upb-lea/LEA_KiCad_Library/LEA_3D_Models/Conn_354078-E_3d.stp

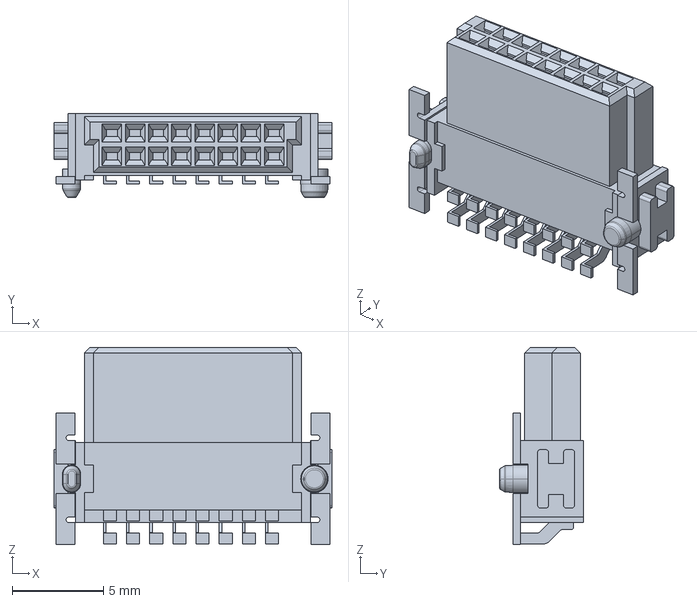
[picture p5: CAD file, 2026-10-27]
LEA_3D_Models/Conn_354078-E_3d.stp
15.2 x 4.60 x 10.8 mm
