upb-lea/LEA_KiCad_Library/LEA_3D_Models/heatsink_ub4060-10.stp

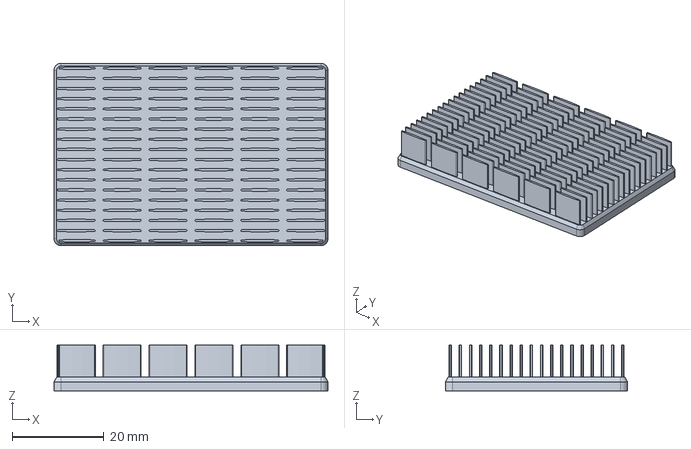
[picture p6: CAD file, 2026-10-13]
LEA_3D_Models/heatsink_ub4060-10.stp
59.7 x 39.7 x 10.0 mm
