upb-lea/LEA_KiCad_Library/LEA_3D_Models/WE_744393305100.stp

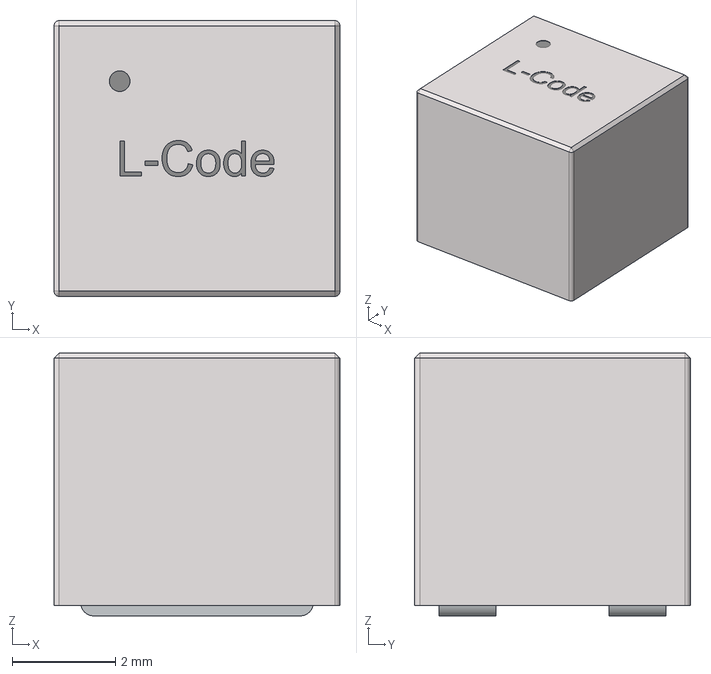
[picture p7: CAD file, 2026-09-16]
LEA_3D_Models/WE_744393305100.stp
5.55 x 5.35 x 5.10 mm
