upb-lea/LEA_KiCad_Library/LEA_3D_Models/C_Film_ECW-FJ3A205J.stp

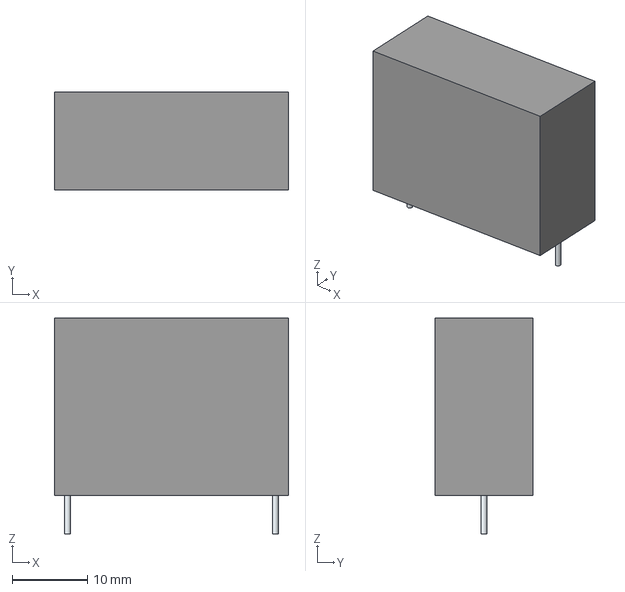
[picture p8: CAD file, 2026-09-16]
LEA_3D_Models/C_Film_ECW-FJ3A205J.stp
31.0 x 13.0 x 28.6 mm
Leads
