upb-lea/LEA_KiCad_Library/LEA_3D_Models/SOT-323F_UFM.stp

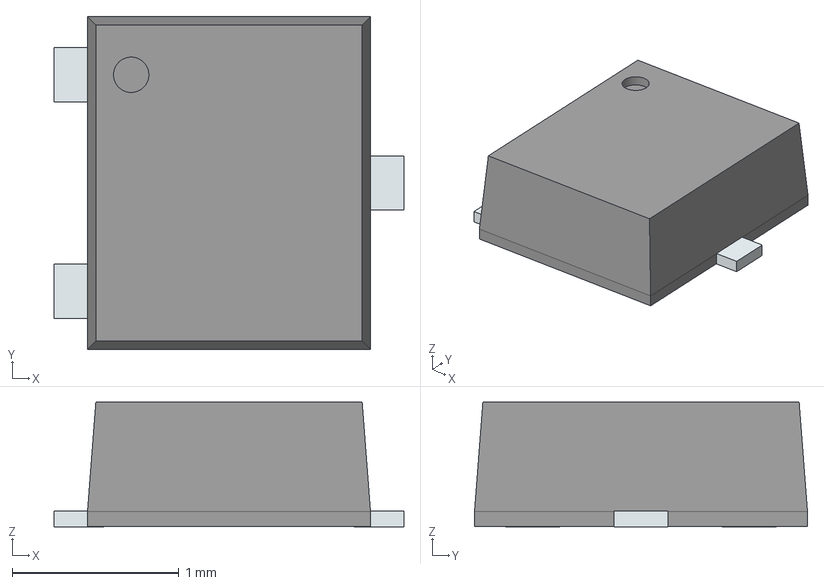
[picture p9: CAD file, 2026-09-15]
LEA_3D_Models/SOT-323F_UFM.stp
2.10 x 2.00 x 0.748 mm
PinsArrayL
PinsArrayR
