upb-lea/LEA_KiCad_Library/LEA_3D_Models/Conn_SAMTEC-LS2-105-01-X-D.step

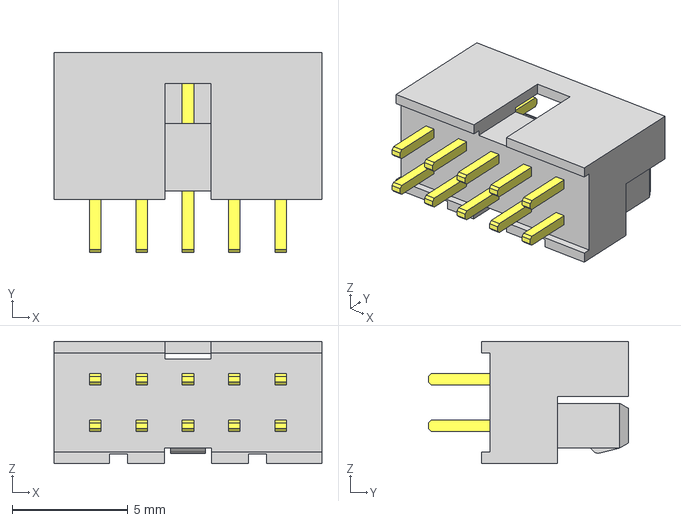
[picture p10: CAD file, 2026-09-14]
LEA_3D_Models/Conn_SAMTEC-LS2-105-01-X-D.step
11.6 x 8.64 x 5.27 mm
LS2-105-01-D_strip
T-1S13-05-01-D
