upb-lea/LEA_KiCad_Library/LEA_3D_Models/Conn_Samtec_LS2-105-01-F-D-RA2.stp

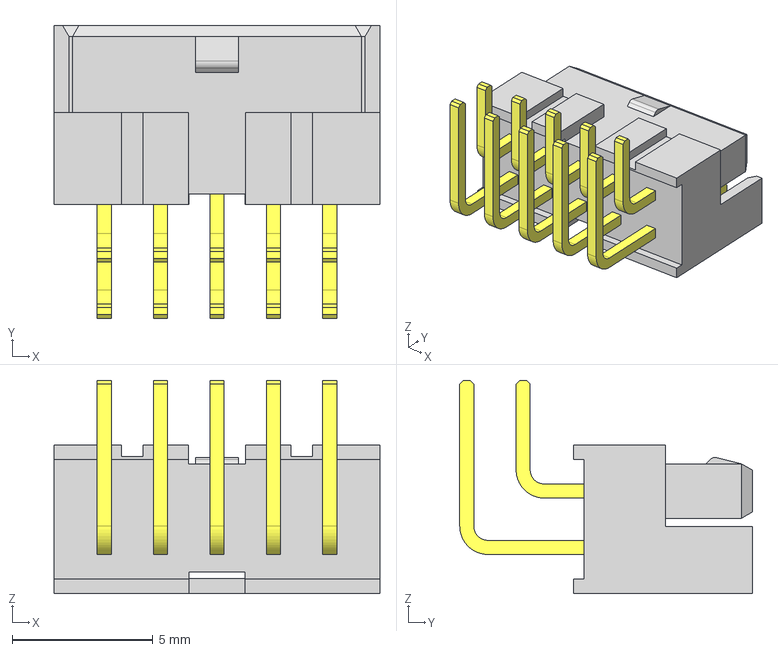
[picture p11: CAD file, 2026-09-14]
LEA_3D_Models/Conn_Samtec_LS2-105-01-F-D-RA2.stp
11.6 x 10.4 x 7.56 mm
LS2-105-01-D_strip
T-1S13-05-01-D-RA2
