upb-lea/LEA_KiCad_Library/LEA_3D_Models/Conn_WE_61301021821.stp

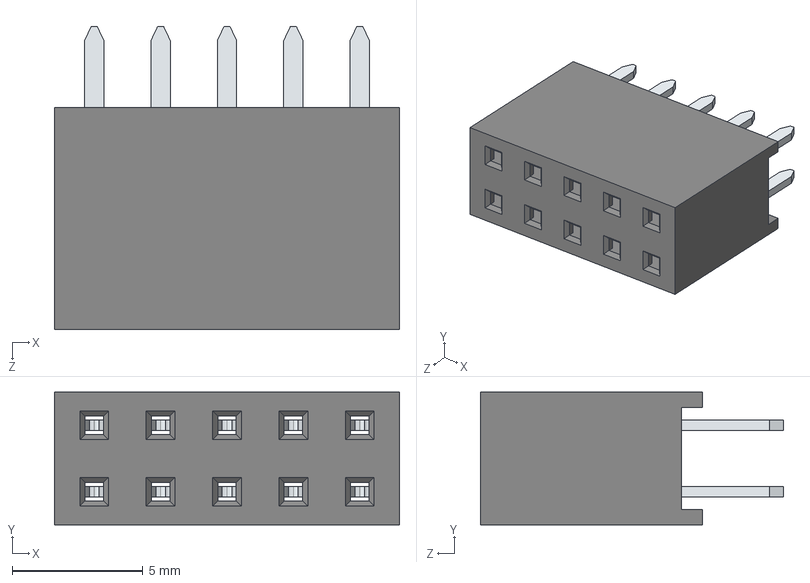
[picture p12: CAD file, 2026-09-11]
LEA_3D_Models/Conn_WE_61301021821.stp
13.2 x 5.08 x 11.6 mm
6130xx21821_PIN x 10
