upb-lea/LEA_KiCad_Library/LEA_3D_Models/HCMA1707-6R8-R.stp

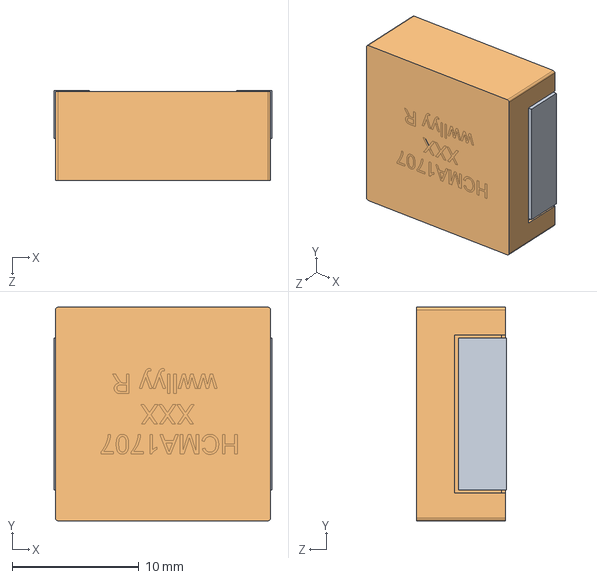
[picture p13: CAD file, 2026-09-08]
LEA_3D_Models/HCMA1707-6R8-R.stp
17.2 x 16.9 x 7.11 mm
