upb-lea/LEA_KiCad_Library/LEA_3D_Models/R_2728_reversed.stp

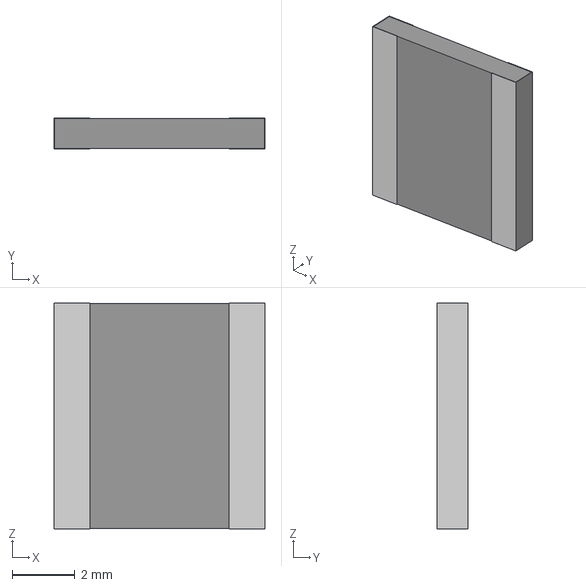
[picture p14: CAD file, 2026-09-08]
LEA_3D_Models/R_2728_reversed.stp
6.71 x 0.99 x 7.19 mm
