upb-lea/LEA_KiCad_Library/LEA_3D_Models/C_2225_5664Metric.step

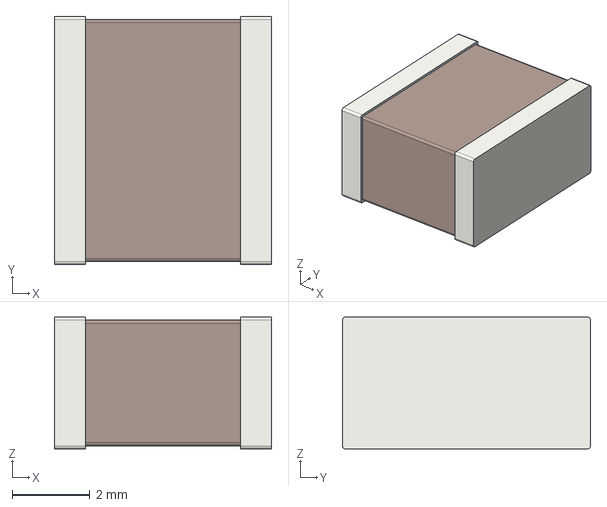
[picture p15: CAD file, 2026-09-07]
LEA_3D_Models/C_2225_5664Metric.step
5.60 x 6.40 x 3.40 mm
