upb-lea/LEA_KiCad_Library/LEA_3D_Models/TO-263-2.step

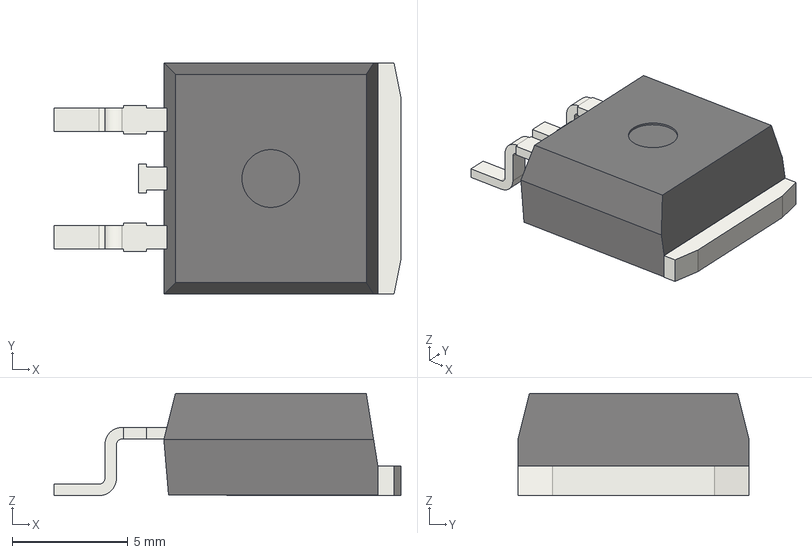
[picture p16: CAD file, 2026-09-03]
LEA_3D_Models/TO-263-2.step
15.0 x 10.0 x 4.42 mm
a3dd6ad7-9c39-11ed-93f0-dde97e994e83_part
a3dd6ad8-9c39-11ed-93f0-dde97e994e83_part
a3dd6ad9-9c39-11ed-93f0-dde97e994e83_part
