upb-lea/LEA_KiCad_Library/LEA_3D_Models/TO-263AB(D2PAK)-2L.STEP

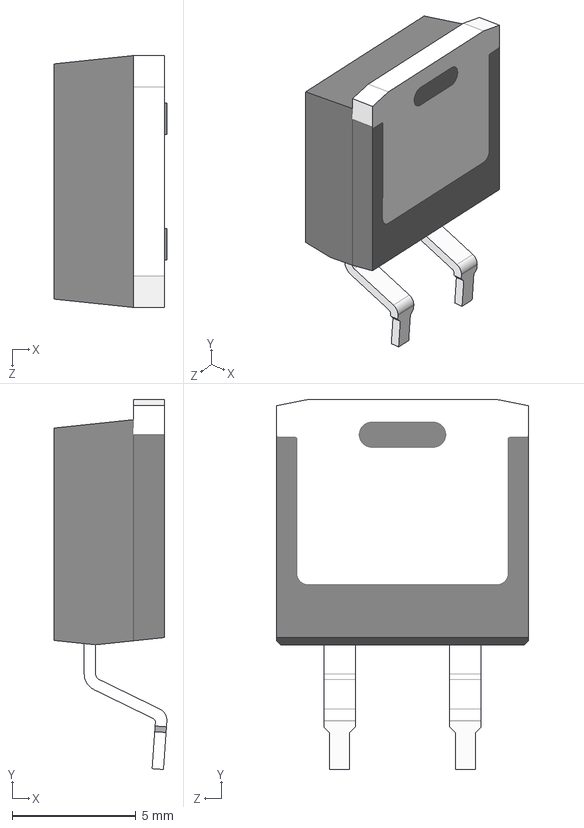
[picture p17: CAD file, 2026-08-31]
LEA_3D_Models/TO-263AB(D2PAK)-2L.STEP
4.55 x 14.9 x 10.2 mm
