upb-lea/LEA_KiCad_Library/LEA_3D_Models/2MM-HB-D08-HT-02-H-TB.stp

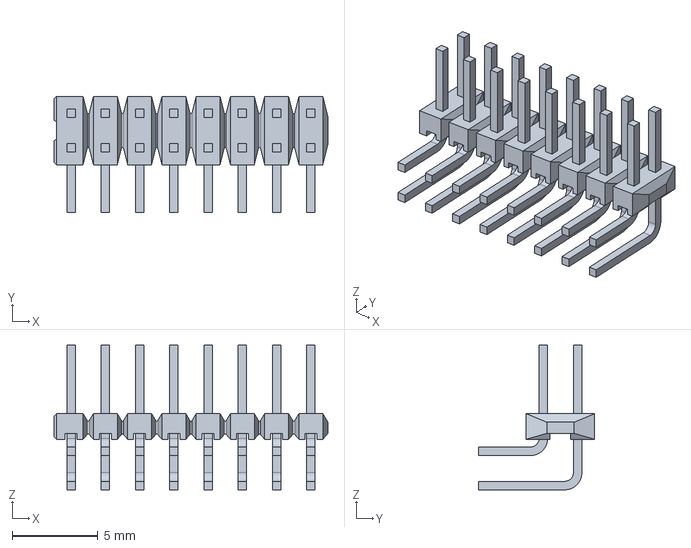
[picture p18: CAD file, 2026-08-21]
LEA_3D_Models/2MM-HB-D08-HT-02-H-TB.stp
16.0 x 6.80 x 8.45 mm
