upb-lea/LEA_KiCad_Library/LEA_3D_Models/HalfBridge.step

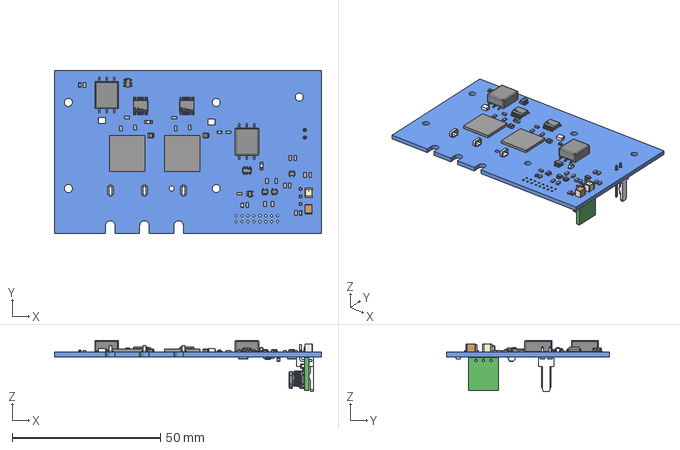
[picture p19: CAD file, 2026-08-21]
LEA_3D_Models/HalfBridge.step
90.0 x 55.0 x 17.3 mm
