upb-lea/LEA_KiCad_Library/LEA_3D_Models/ESQT-108-03-F-D-350.stp

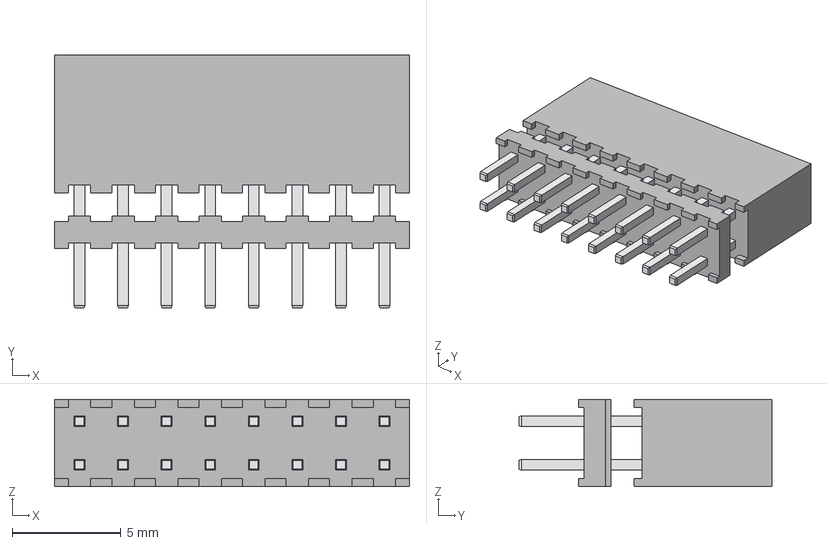
[picture p20: CAD file, 2026-08-21]
LEA_3D_Models/ESQT-108-03-F-D-350.stp
16.3 x 11.6 x 4.00 mm
ESQT-108-03-F-D-350_S
ESQT-108-03-F-D-350_P
ESQT-108-03-F-D-3502_P
ESQT-108-03-F-D-350_BS
