upb-lea/LEA_KiCad_Library/LEA_3D_Models/C_1812_4532Metric.step

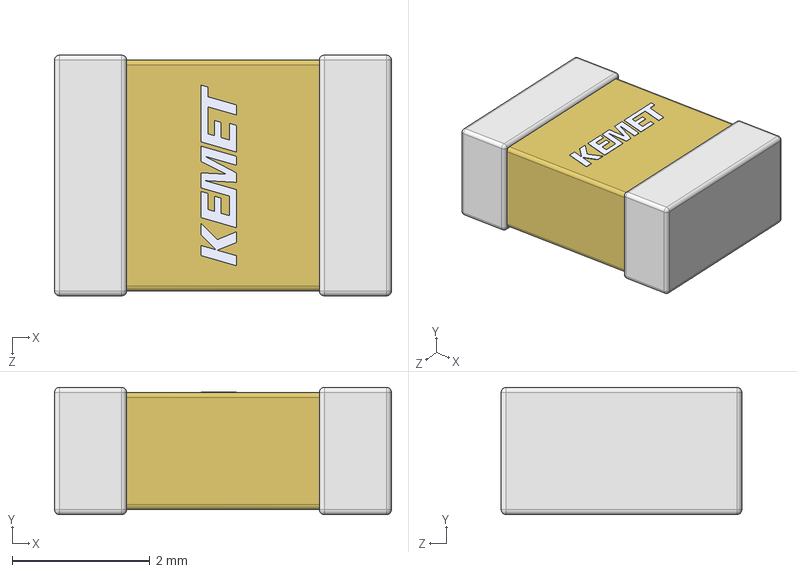
[picture p21: CAD file, 2026-08-18]
LEA_3D_Models/C_1812_4532Metric.step
4.90 x 1.85 x 3.50 mm
