upb-lea/LEA_KiCad_Library/LEA_3D_Models/IGC033S10S1XTMA1.stp

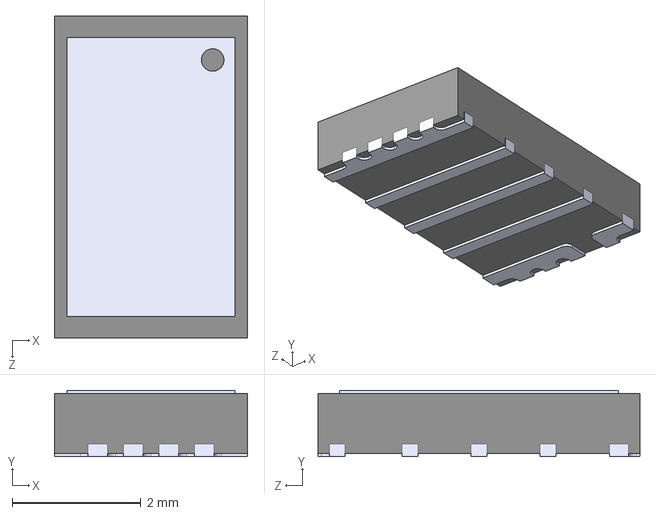
[picture p22: CAD file, 2026-08-09]
LEA_3D_Models/IGC033S10S1XTMA1.stp
3.00 x 1.03 x 5.00 mm
