upb-lea/LEA_KiCad_Library/LEA_3D_Models/D_0805_2012Metric.step

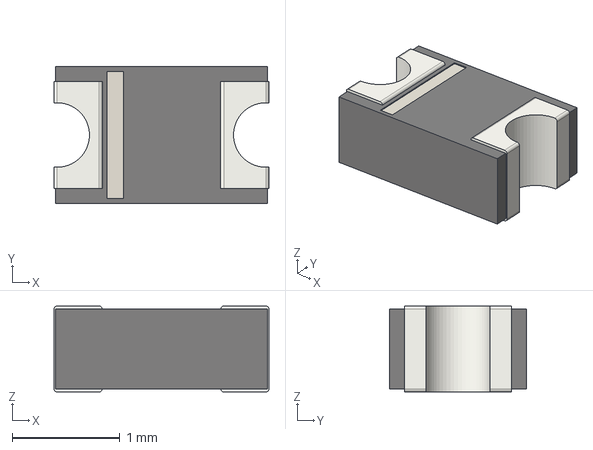
[picture p23: CAD file, 2026-01-27]
LEA_3D_Models/D_0805_2012Metric.step
2.00 x 1.27 x 0.8 mm
