upb-lea/LEA_KiCad_Library/LEA_3D_Models/Conn_Molex_10085021.stp

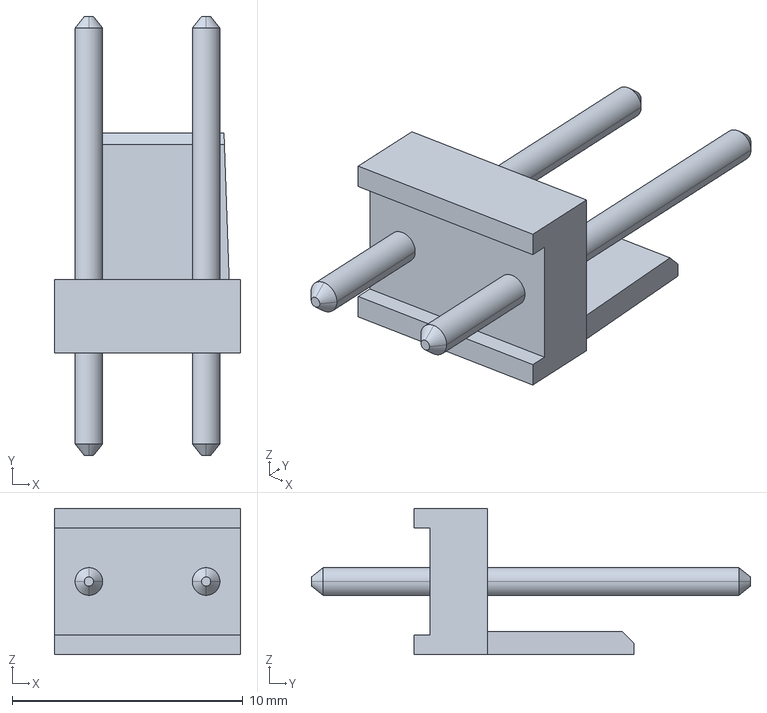
[picture p24: CAD file, 2025-09-18]
LEA_3D_Models/Conn_Molex_10085021.stp
8.08 x 19.0 x 6.35 mm
