upb-lea/LEA_KiCad_Library/LEA_3D_Models/C_1210_3225Metric.step

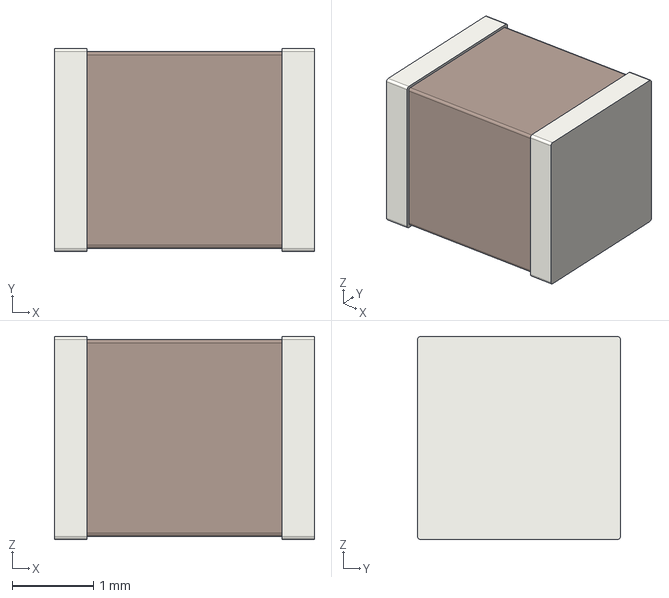
[picture p25: CAD file, 2025-09-16]
LEA_3D_Models/C_1210_3225Metric.step
3.20 x 2.50 x 2.50 mm
