upb-lea/LEA_KiCad_Library/LEA_3D_Models/RDA0015A_QFN15.stp

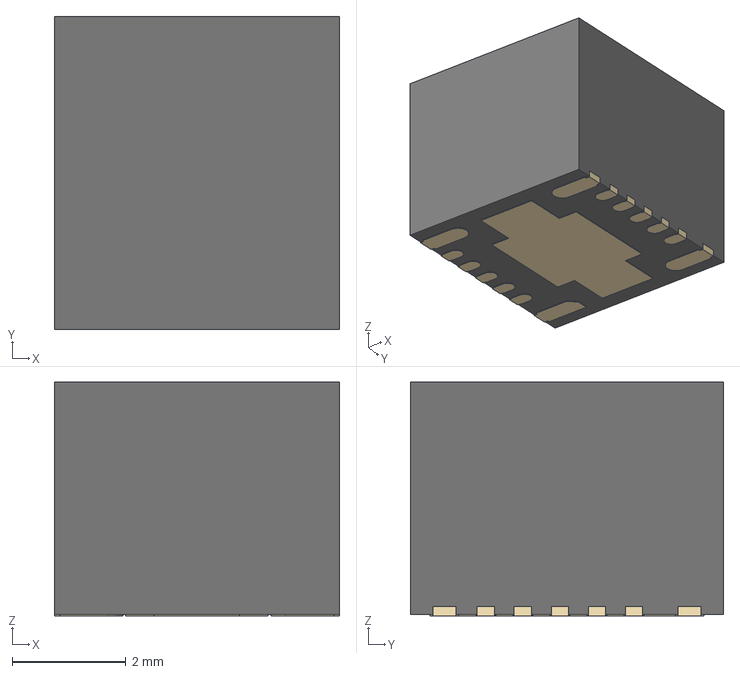
[picture p26: CAD file, 2025-09-12]
LEA_3D_Models/RDA0015A_QFN15.stp
5.00 x 5.50 x 4.10 mm
METAL
MOLD
