upb-lea/LEA_KiCad_Library/LEA_3D_Models/SRN4026-220M.stp

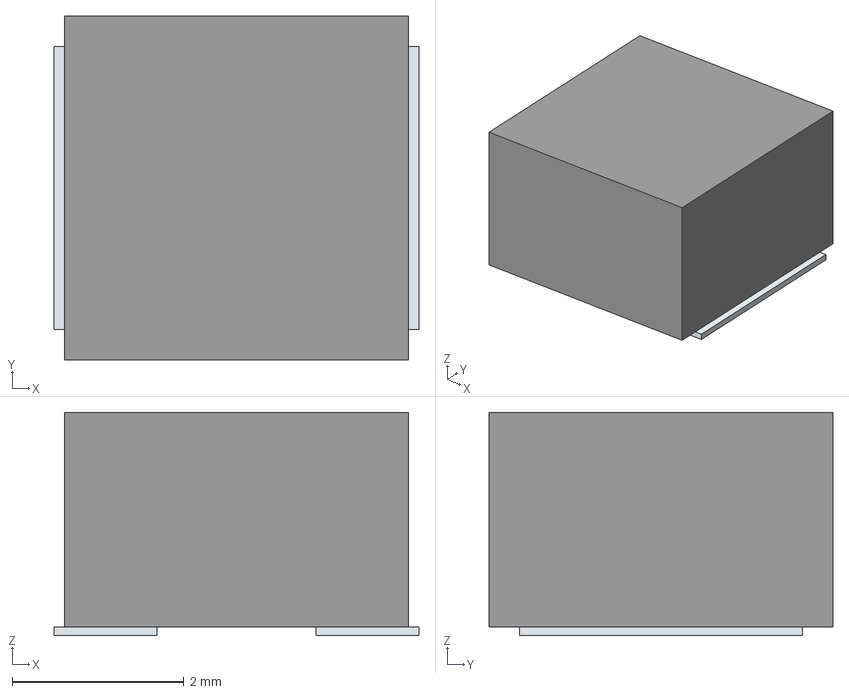
[picture p27: CAD file, 2025-06-04]
LEA_3D_Models/SRN4026-220M.stp
4.25 x 4.00 x 2.60 mm
Pins
