upb-lea/LEA_KiCad_Library/LEA_3D_Models/L_Wurth_WE-TPC-1038.step

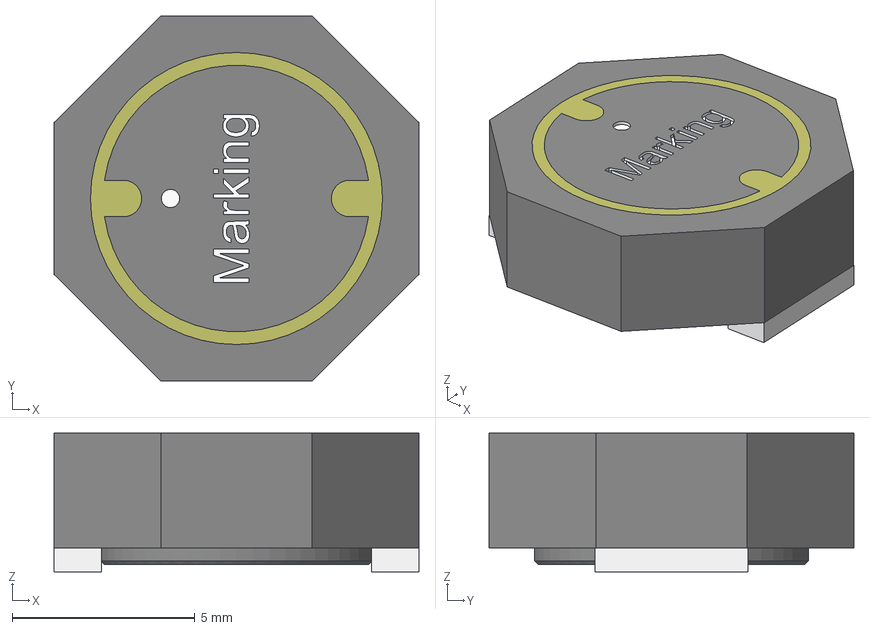
[picture p28: CAD file, 2025-05-29]
LEA_3D_Models/L_Wurth_WE-TPC-1038.step
10.0 x 10.00 x 3.80 mm
