upb-lea/LEA_KiCad_Library/LEA_3D_Models/LED_Yellow_0603.stp

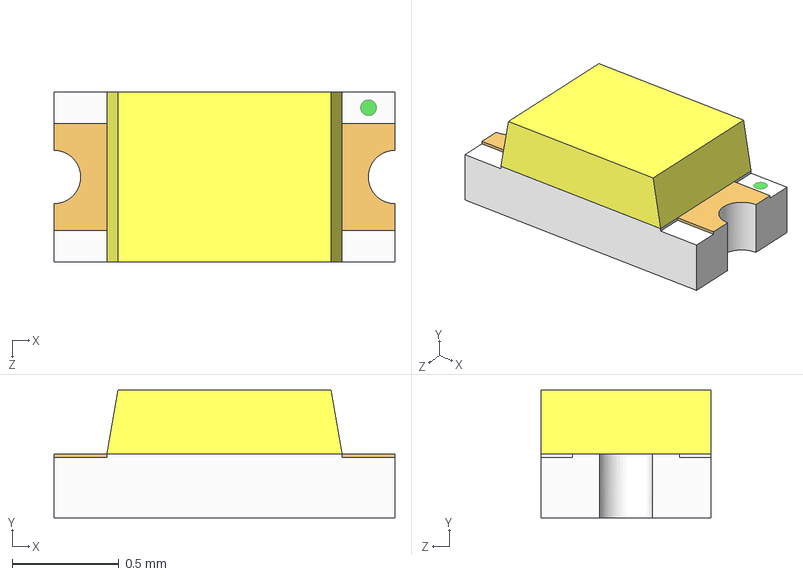
[picture p29: CAD file, 2025-02-20]
LEA_3D_Models/LED_Yellow_0603.stp
1.60 x 0.6 x 0.8 mm
