upb-lea/LEA_KiCad_Library/LEA_3D_Models/MSOP10_AnalogDevices.stp

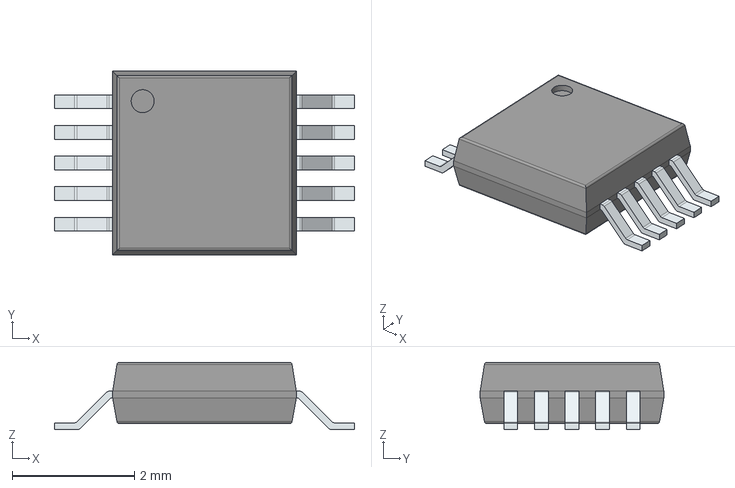
[picture p30: CAD file, 2025-02-18]
LEA_3D_Models/MSOP10_AnalogDevices.stp
4.90 x 3.00 x 1.10 mm
PinsArrayLR
