upb-lea/LEA_KiCad_Library/LEA_3D_Models/FTR-110-03-G-D-06-TR.stp

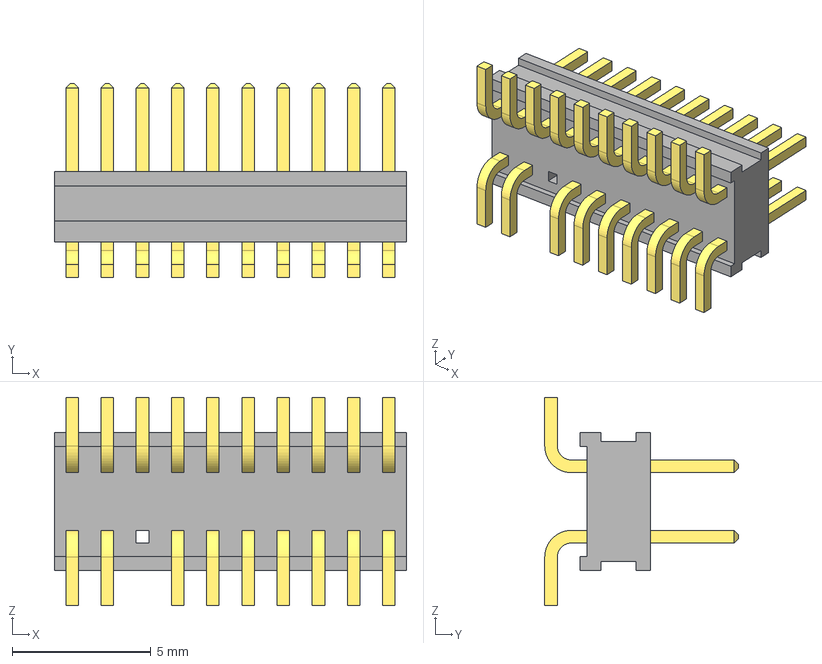
[picture p31: CAD file, 2025-02-18]
LEA_3D_Models/FTR-110-03-G-D-06-TR.stp
12.7 x 6.98 x 7.52 mm
FTR-110-03-G-D-006-TR_body
FTR-110-03-G-D-006-TR_pins
FTR-110-03-G-D-006-TR2PNS
