upb-lea/LEA_KiCad_Library/LEA_3D_Models/VSSOP-8-TI.stp

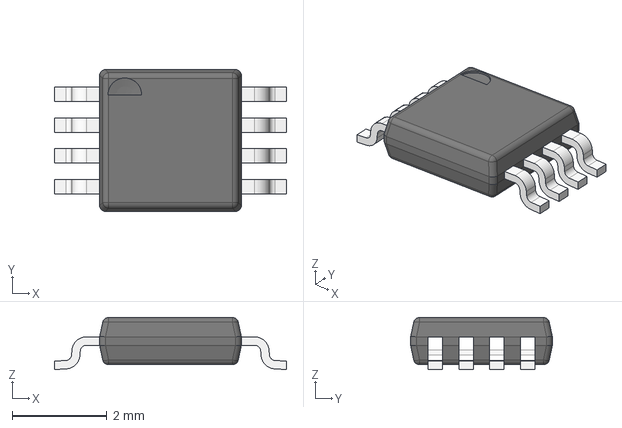
[picture p32: CAD file, 2025-01-23]
LEA_3D_Models/VSSOP-8-TI.stp
4.90 x 3.00 x 1.10 mm
BODY_MUA08A
LEAD_MUA08A x 8
