upb-lea/LEA_KiCad_Library/LEA_3D_Models/SO-14.stp

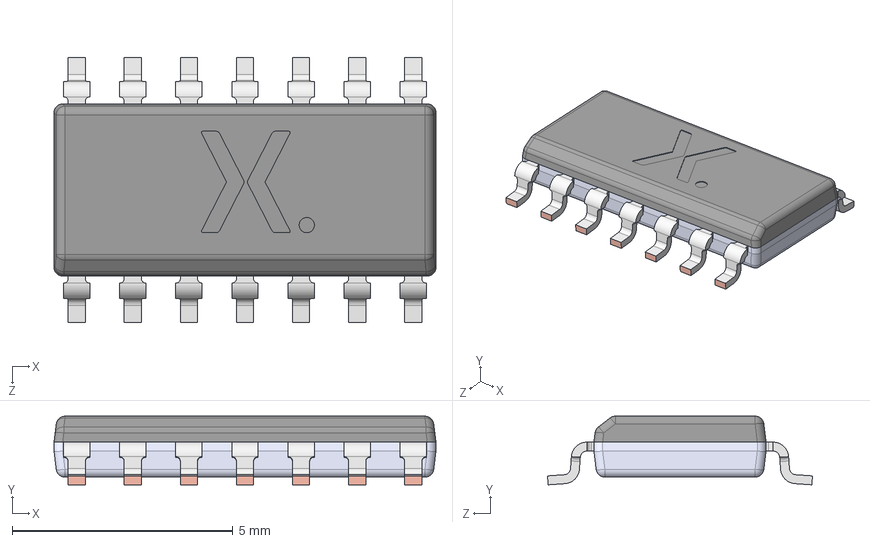
[picture p33: CAD file, 2025-01-13]
LEA_3D_Models/SO-14.stp
8.65 x 1.56 x 6.00 mm
SOT108 lower body
SOT108 upper body
SOT108-1 Lead
