upb-lea/LEA_KiCad_Library/LEA_3D_Models/SOT-23-8.stp

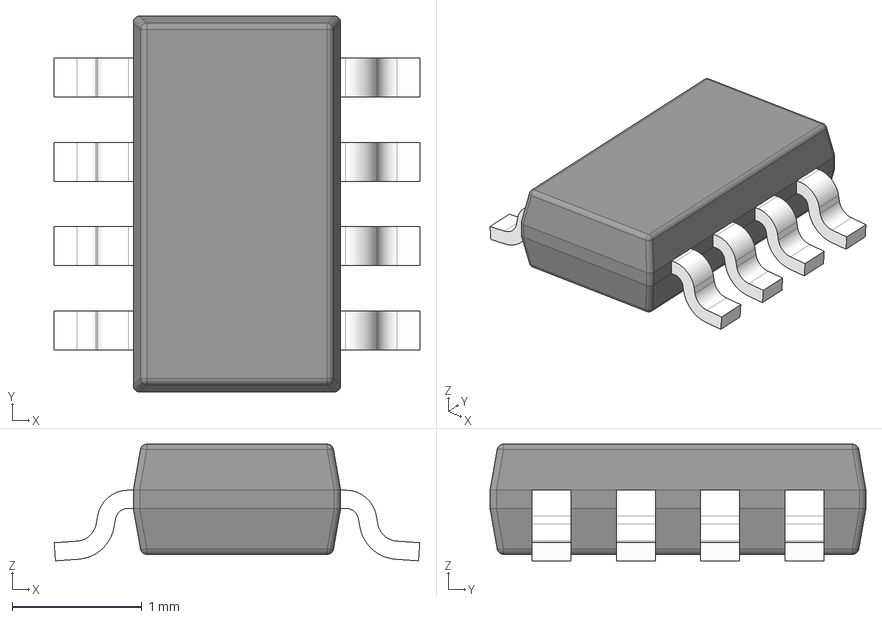
[picture p34: CAD file, 2025-01-13]
LEA_3D_Models/SOT-23-8.stp
2.82 x 2.90 x 0.9 mm
BODY-SO
LEAD-SO x 8
PIN1-ID
