upb-lea/LEA_KiCad_Library/LEA_3D_Models/B3U-3000PM-B.stp

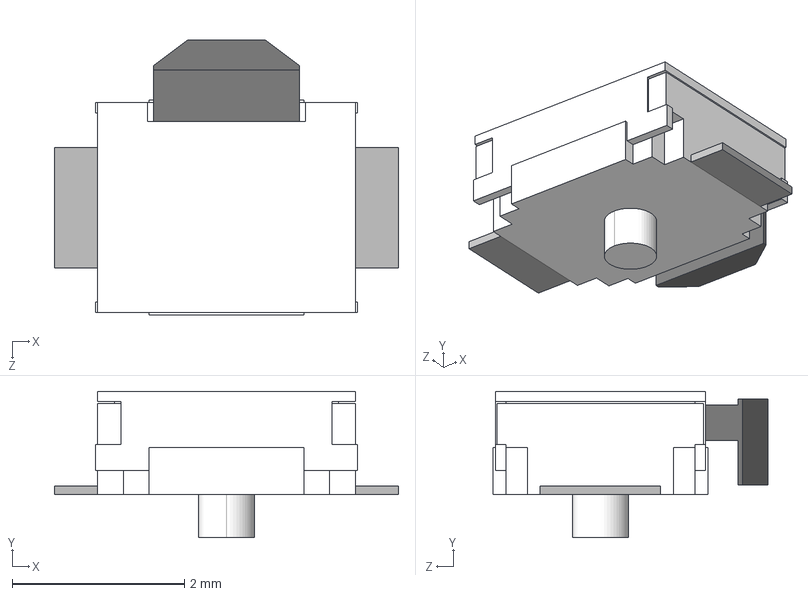
[picture p35: CAD file, 2025-01-06]
LEA_3D_Models/B3U-3000PM-B.stp
4.00 x 1.70 x 3.20 mm
