upb-lea/LEA_KiCad_Library/LEA_3D_Models/PI6C49CB04AQ3WEX.stp

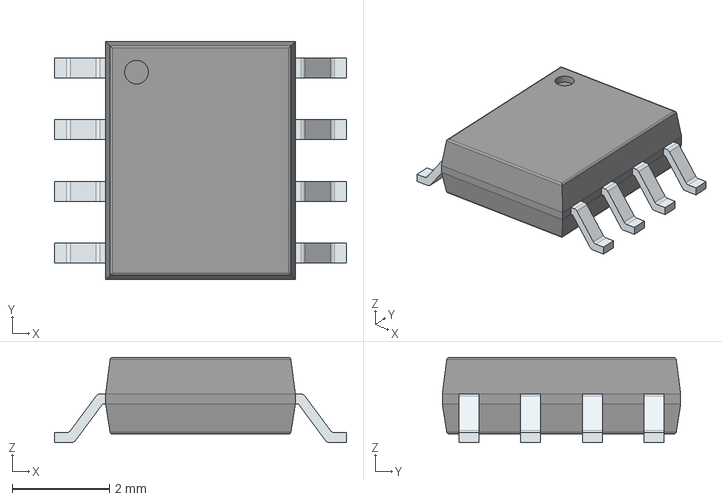
[picture p36: CAD file, 2024-12-20]
LEA_3D_Models/PI6C49CB04AQ3WEX.stp
6.00 x 4.90 x 1.75 mm
PinsArrayLR
