upb-lea/LEA_KiCad_Library/LEA_3D_Models/NTE0303MC.stp

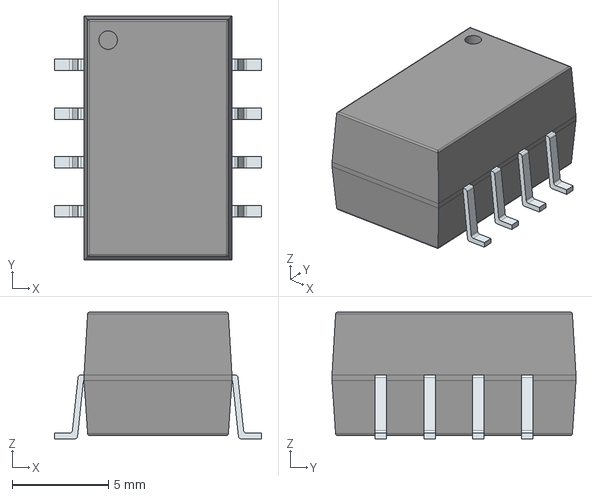
[picture p37: CAD file, 2024-10-23]
LEA_3D_Models/NTE0303MC.stp
10.8 x 12.7 x 6.60 mm
PinsArrayLR
