upb-lea/LEA_KiCad_Library/LEA_3D_Models/Conn_M4_74650074R.stp

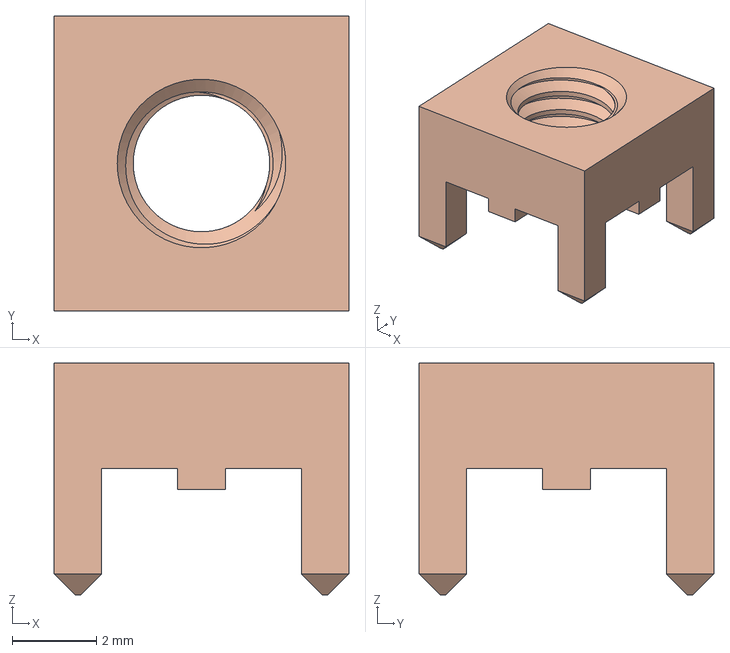
[picture p38: CAD file, 2024-07-29]
LEA_3D_Models/Conn_M4_74650074R.stp
7.00 x 7.00 x 5.50 mm
