upb-lea/LEA_KiCad_Library/LEA_3D_Models/CSI2H-2512K-1L80G.stp

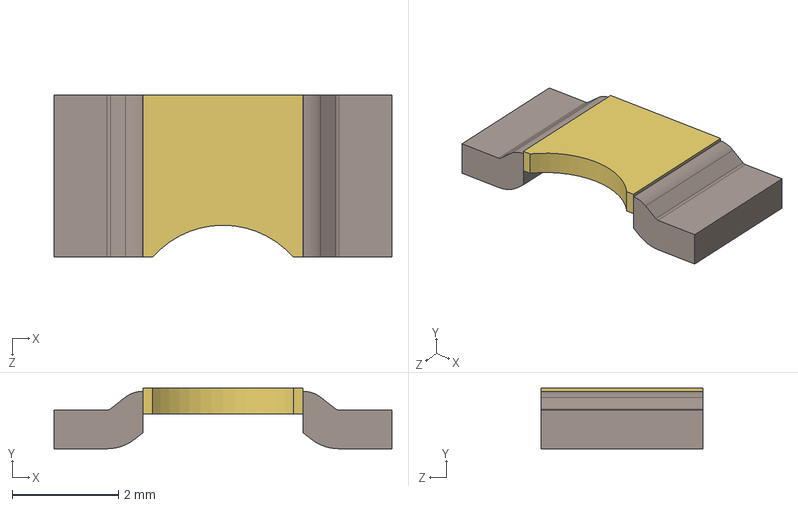
[picture p39: CAD file, 2024-07-23]
LEA_3D_Models/CSI2H-2512K-1L80G.stp
6.35 x 1.14 x 3.05 mm
MANIFOLD_SOLID_BREP_547
MANIFOLD_SOLID_BREP_1090
RESIST2512_3
