upb-lea/LEA_KiCad_Library/LEA_3D_Models/Conn_2492000000.stp

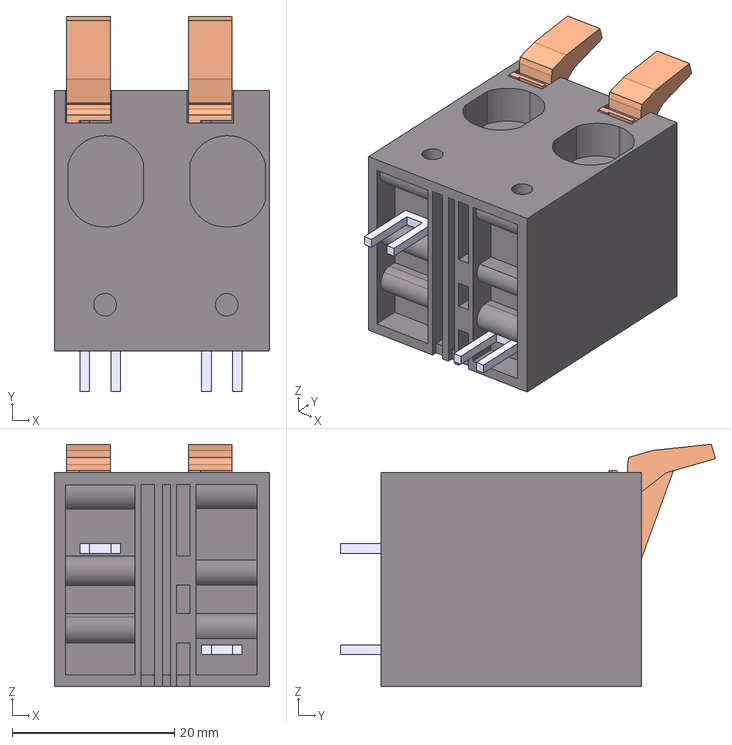
[picture p40: CAD file, 2024-07-22]
LEA_3D_Models/Conn_2492000000.stp
26.6 x 46.2 x 29.9 mm
