upb-lea/LEA_KiCad_Library/LEA_3D_Models/Conn_1548376.stp

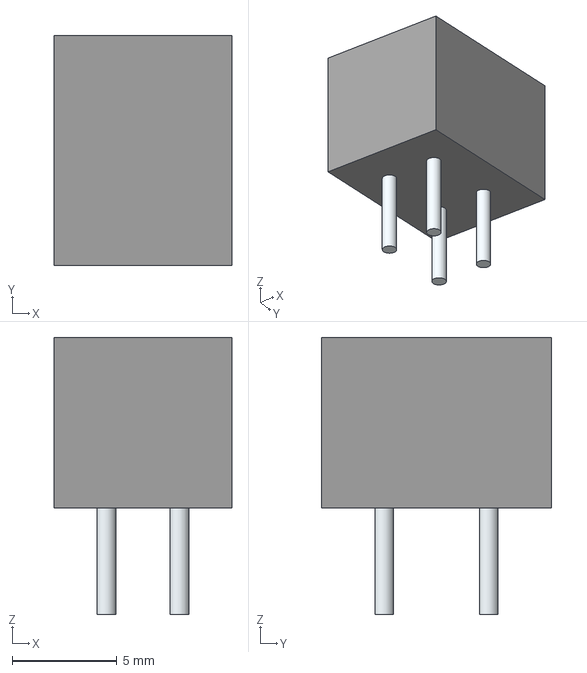
[picture p41: CAD file, 2024-07-22]
LEA_3D_Models/Conn_1548376.stp
8.50 x 11.0 x 13.2 mm
Leads
