upb-lea/LEA_KiCad_Library/LEA_3D_Models/SD101AW-HE3_A-08.stp

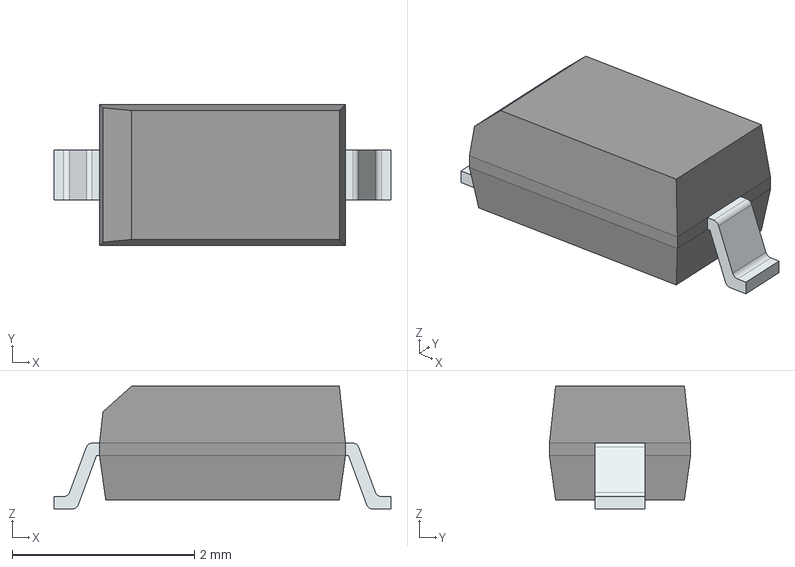
[picture p42: CAD file, 2024-07-16]
LEA_3D_Models/SD101AW-HE3_A-08.stp
3.70 x 1.55 x 1.35 mm
FilletPinL
FilletPinR
