upb-lea/LEA_KiCad_Library/LEA_3D_Models/MTS-10S.stp

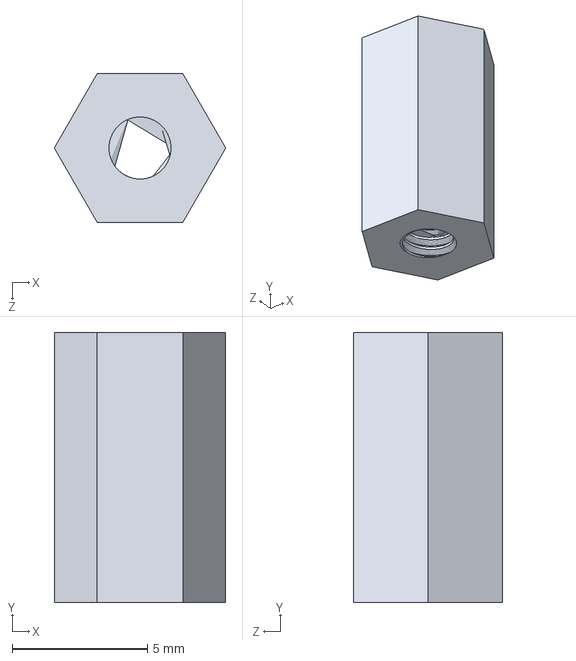
[picture p43: CAD file, 2024-07-12]
LEA_3D_Models/MTS-10S.stp
6.35 x 10.0 x 5.50 mm
