upb-lea/LEA_KiCad_Library/LEA_3D_Models/LTC7800HUDC#PBF.stp

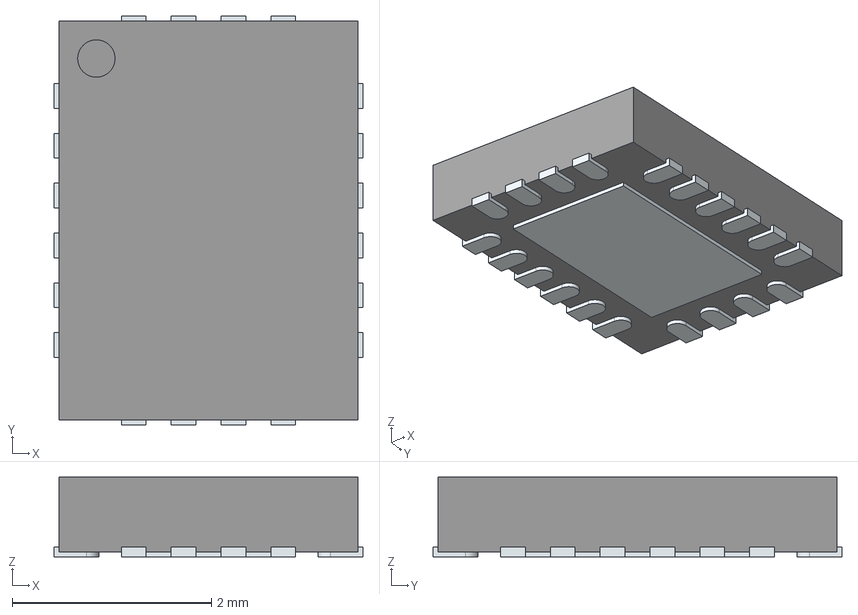
[picture p44: CAD file, 2024-07-10]
LEA_3D_Models/LTC7800HUDC#PBF.stp
3.10 x 4.10 x 0.8 mm
ThermalPin
PinsArrayLR
PinsArrayTB
