upb-lea/LEA_KiCad_Library/LEA_3D_Models/EEU-EB2W220S.stp

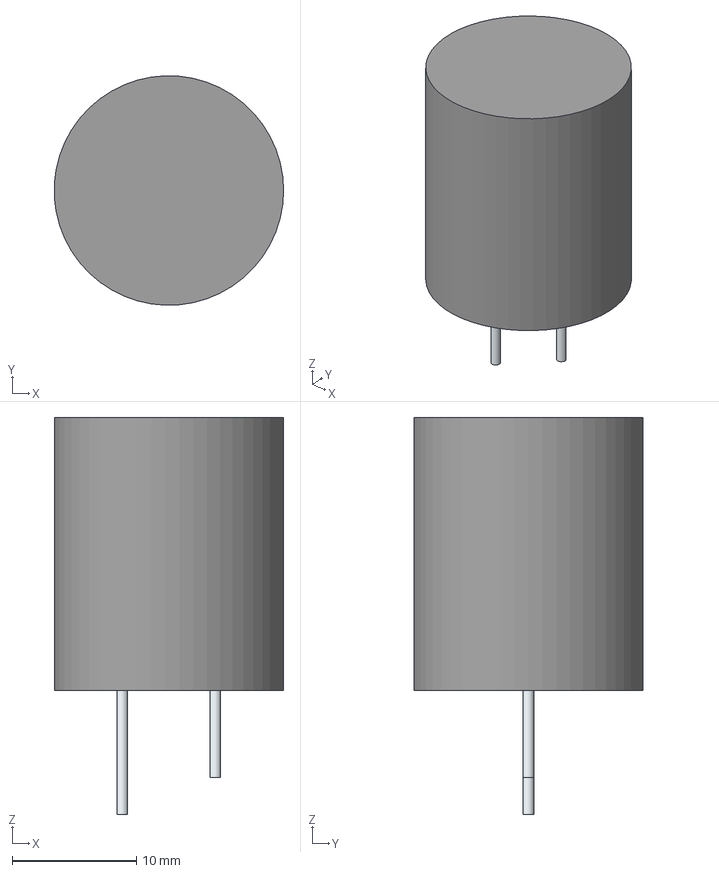
[picture p45: CAD file, 2024-05-21]
LEA_3D_Models/EEU-EB2W220S.stp
18.5 x 18.5 x 32.0 mm
SimpleBody
Pin1
Pin2
