upb-lea/LEA_KiCad_Library/LEA_3D_Models/EEU-FS2A560L.stp

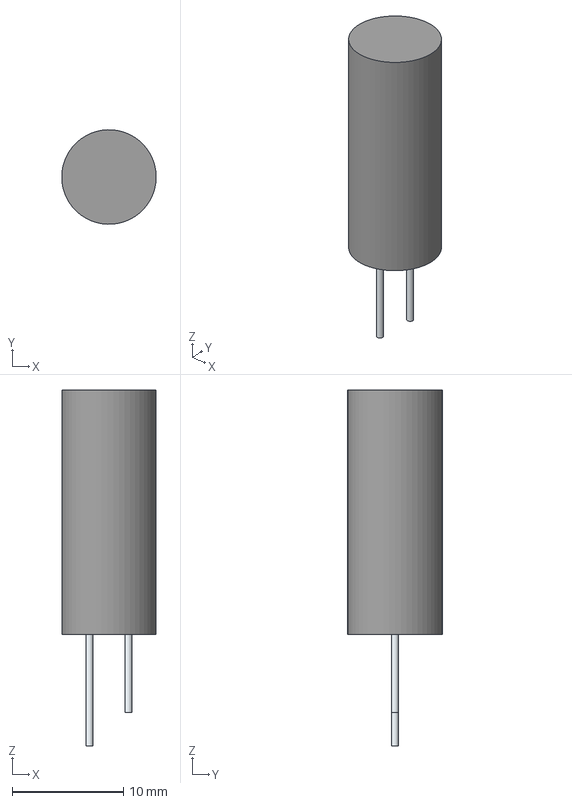
[picture p46: CAD file, 2024-05-21]
LEA_3D_Models/EEU-FS2A560L.stp
8.49 x 8.50 x 32.0 mm
SimpleBody
Pin1
Pin2
