upb-lea/LEA_KiCad_Library/LEA_3D_Models/EEU-FS1H270B.stp

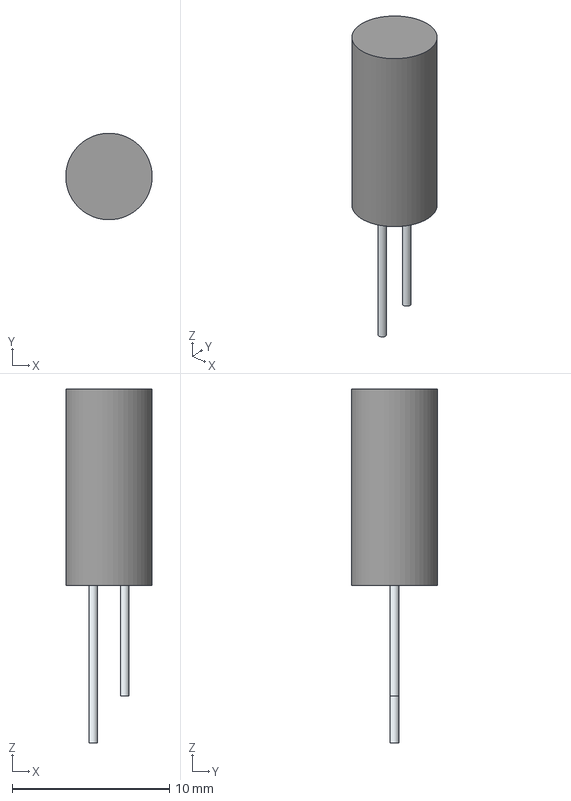
[picture p47: CAD file, 2024-05-21]
LEA_3D_Models/EEU-FS1H270B.stp
5.49 x 5.50 x 22.5 mm
SimpleBody
Pin1
Pin2
