upb-lea/LEA_KiCad_Library/LEA_3D_Models/09.03290.01.stp

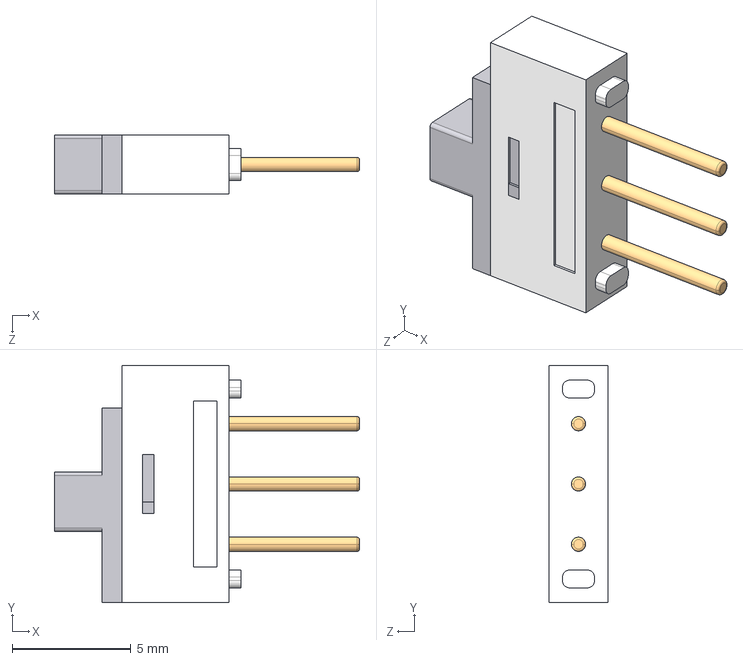
[picture p48: CAD file, 2024-05-13]
LEA_3D_Models/09.03290.01.stp
12.8 x 10.0 x 2.50 mm
