upb-lea/LEA_KiCad_Library/LEA_3D_Models/LED_Blue_0402.stp

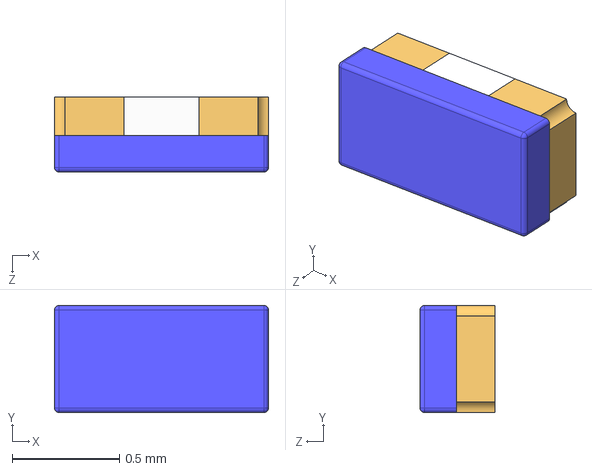
[picture p49: CAD file, 2024-03-21]
LEA_3D_Models/LED_Blue_0402.stp
1.00 x 0.5 x 0.35 mm
