upb-lea/LEA_KiCad_Library/LEA_3D_Models/LED_Yellow_0402.stp

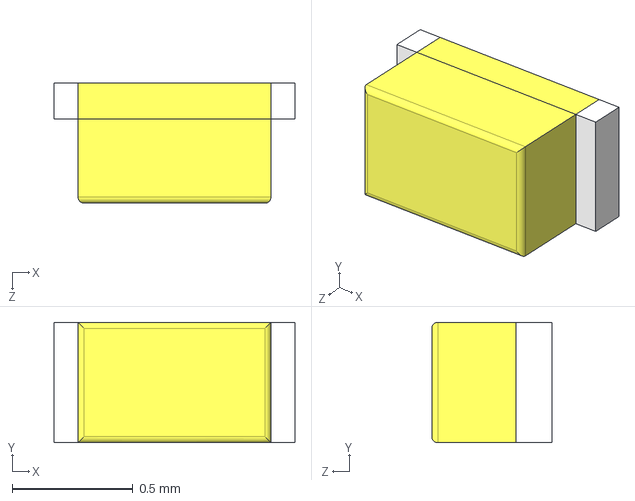
[picture p50: CAD file, 2024-03-21]
LEA_3D_Models/LED_Yellow_0402.stp
1 x 0.5 x 0.5 mm
