upb-lea/LEA_KiCad_Library/LEA_3D_Models/LED_Red_0402.stp

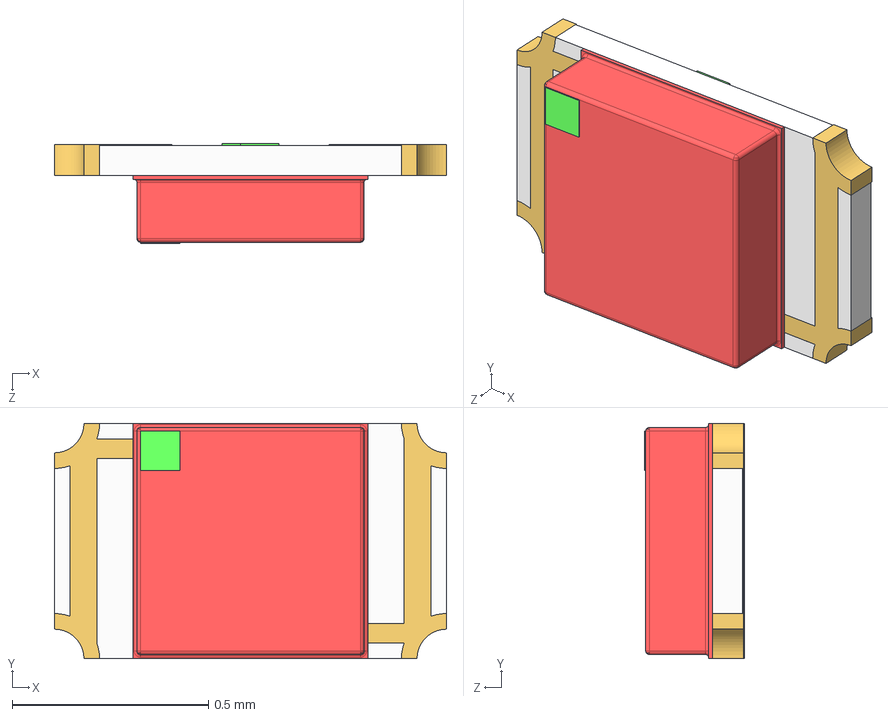
[picture p51: CAD file, 2024-03-21]
LEA_3D_Models/LED_Red_0402.stp
1.00 x 0.6 x 0.255 mm
terminals_2
terminals
lens
cathod mark
cathod mark_2
