upb-lea/LEA_KiCad_Library/LEA_3D_Models/LED_Blue_0603.stp

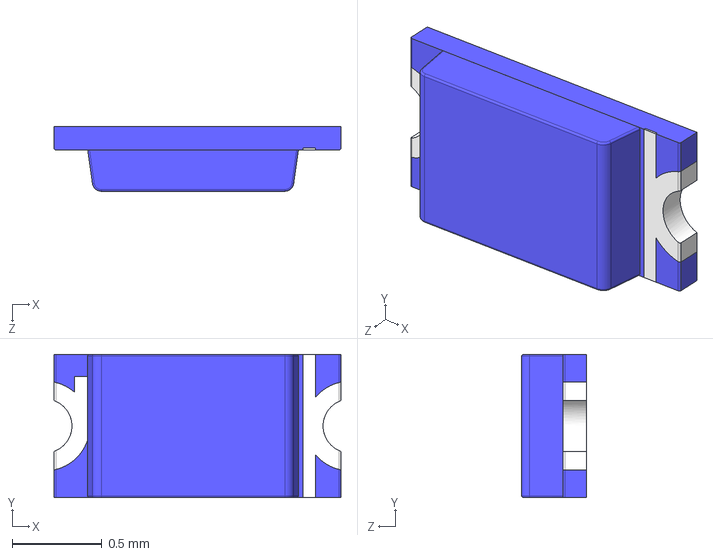
[picture p52: CAD file, 2024-03-20]
LEA_3D_Models/LED_Blue_0603.stp
1.60 x 0.8 x 0.36 mm
