upb-lea/LEA_KiCad_Library/LEA_3D_Models/LED_Red_0603.stp

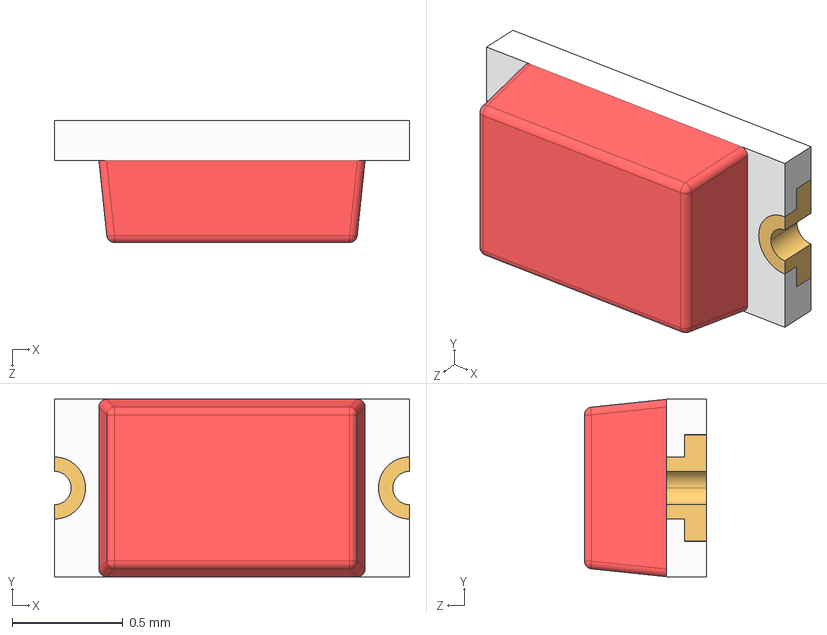
[picture p53: CAD file, 2024-03-20]
LEA_3D_Models/LED_Red_0603.stp
1.60 x 0.8 x 0.55 mm
