upb-lea/LEA_KiCad_Library/LEA_3D_Models/TSW-102-07-G-T.stp

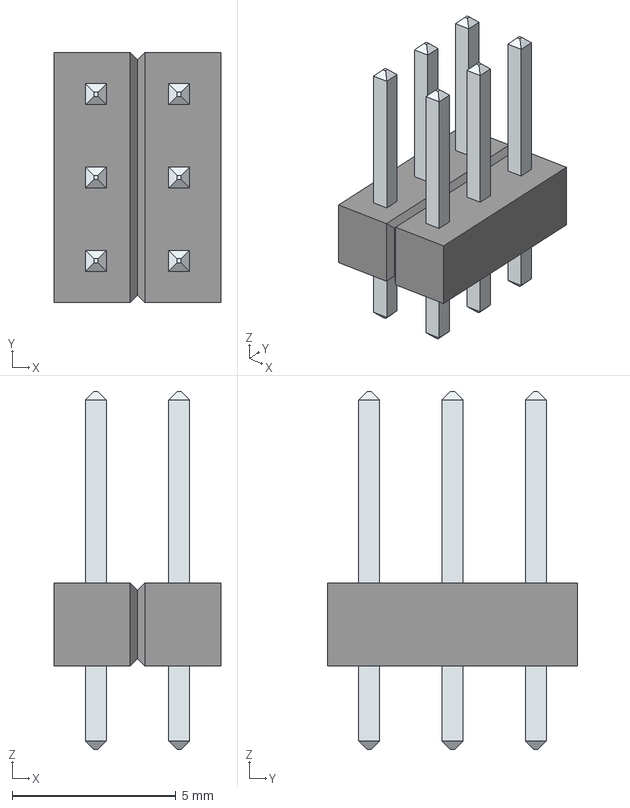
[picture p54: CAD file, 2024-03-03]
LEA_3D_Models/TSW-102-07-G-T.stp
5.08 x 7.62 x 10.9 mm
LeadsArray
