upb-lea/LEA_KiCad_Library/LEA_3D_Models/ADG708BRUZ.stp

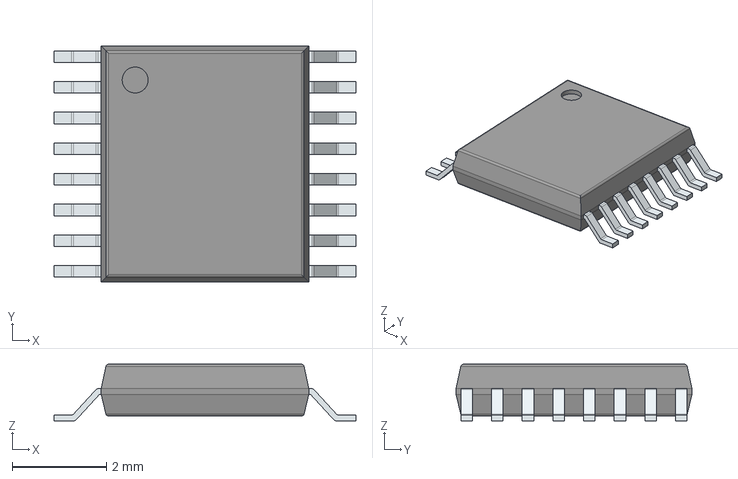
[picture p55: CAD file, 2024-02-08]
LEA_3D_Models/ADG708BRUZ.stp
6.40 x 5.00 x 1.20 mm
PinsArrayLR
