upb-lea/LEA_KiCad_Library/LEA_3D_Models/VXO7805-1000.stp

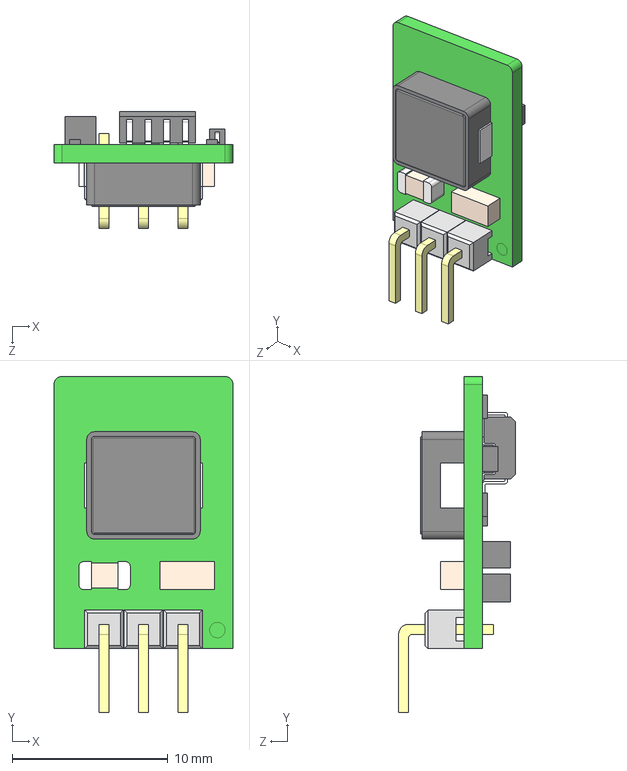
[picture p56: CAD file, 2023-12-15]
LEA_3D_Models/VXO7805-1000.stp
11.5 x 21.6 x 7.50 mm
