upb-lea/LEA_KiCad_Library/LEA_3D_Models/EEU-FC1V681B.stp

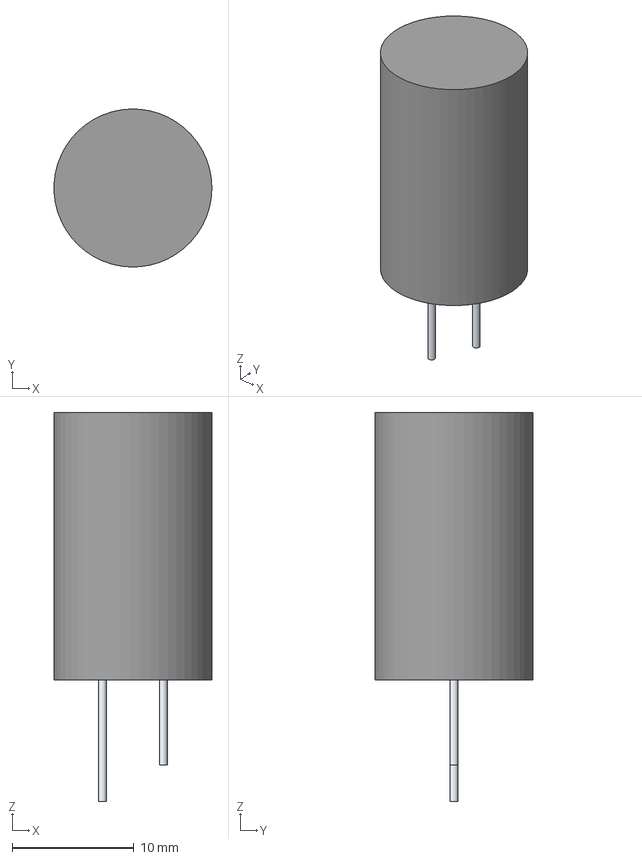
[picture p57: CAD file, 2023-12-15]
LEA_3D_Models/EEU-FC1V681B.stp
13.0 x 13.0 x 32.0 mm
SimpleBody
Pin1
Pin2
