upb-lea/LEA_KiCad_Library/LEA_3D_Models/DNBT8105-7.stp

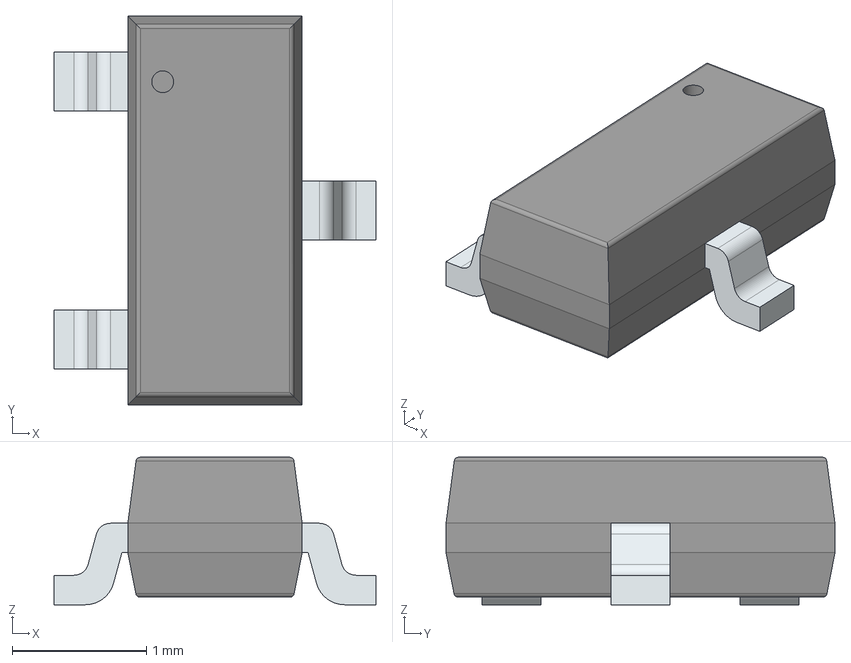
[picture p58: CAD file, 2023-12-15]
LEA_3D_Models/DNBT8105-7.stp
2.40 x 2.90 x 1.10 mm
PinsArrayL
FilletPinR
