upb-lea/LEA_KiCad_Library/LEA_3D_Models/SN74AUP1T32DCKR.stp

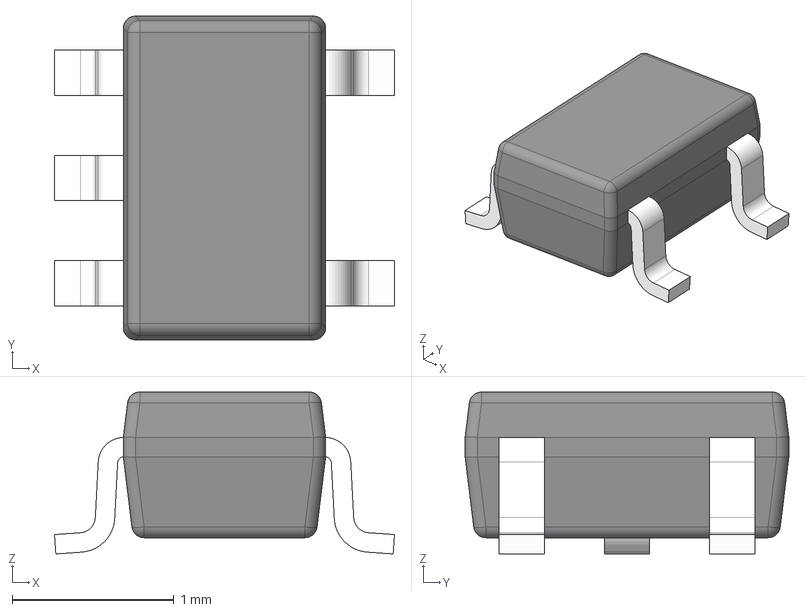
[picture p59: CAD file, 2023-08-23]
LEA_3D_Models/SN74AUP1T32DCKR.stp
2.10 x 2.00 x 1.00 mm
BODY-SOT
LEAD-SOT x 5
PIN1-ID
