upb-lea/LEA_KiCad_Library/LEA_3D_Models/SN74LVC2G32DCUR.stp

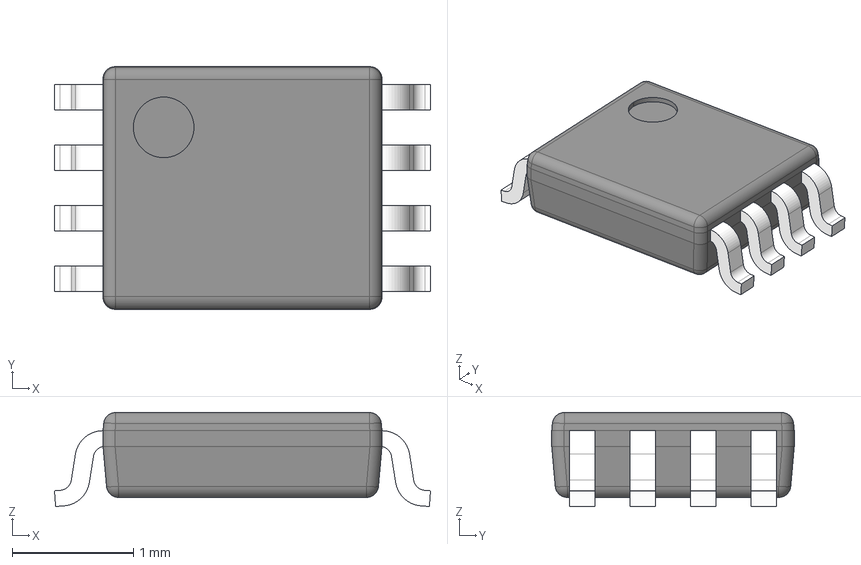
[picture p60: CAD file, 2023-08-23]
LEA_3D_Models/SN74LVC2G32DCUR.stp
3.10 x 2.00 x 0.775 mm
BODY-VSSOP
LEAD-VSSOP x 8
