upb-lea/LEA_KiCad_Library/LEA_3D_Models/DESD24VL1BAQ-7.stp

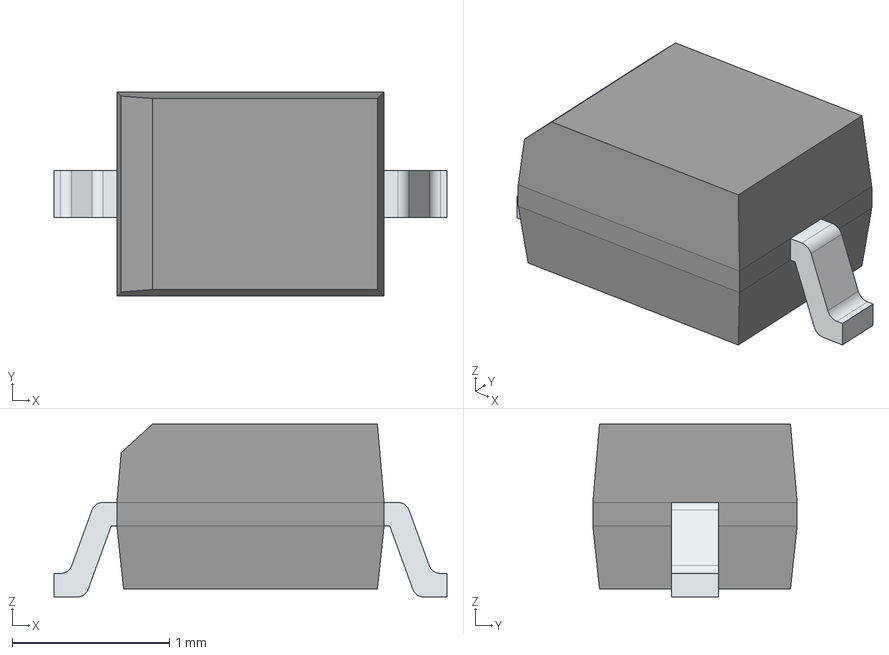
[picture p61: CAD file, 2023-08-11]
LEA_3D_Models/DESD24VL1BAQ-7.stp
2.50 x 1.30 x 1.10 mm
FilletPinL
FilletPinR
