upb-lea/LEA_KiCad_Library/LEA_3D_Models/AMC22C11QDRQ1.stp

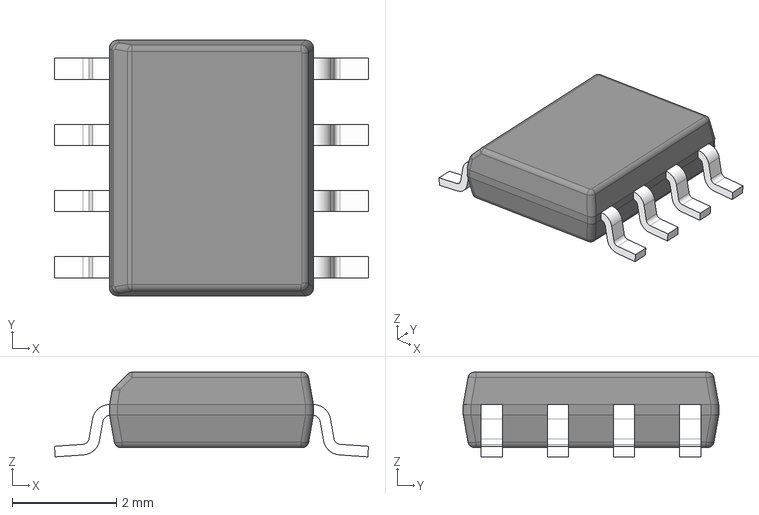
[picture p62: CAD file, 2023-08-07]
LEA_3D_Models/AMC22C11QDRQ1.stp
6.02 x 4.90 x 1.63 mm
BODY-SO
LEAD-D0008A x 8
