upb-lea/LEA_KiCad_Library/LEA_3D_Models/TP3A226K010C1500AS.stp

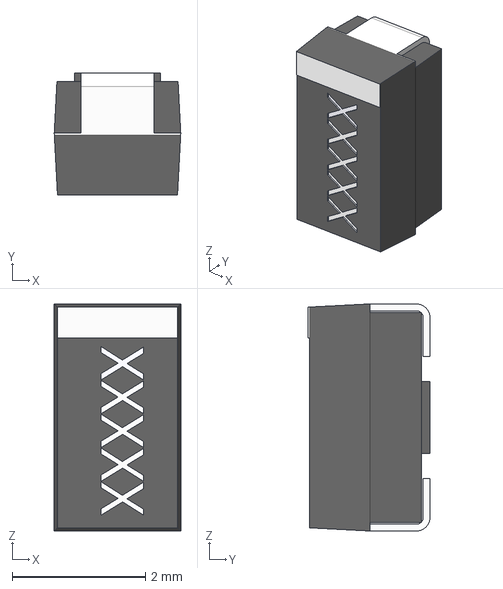
[picture p63: CAD file, 2023-08-07]
LEA_3D_Models/TP3A226K010C1500AS.stp
1.90 x 1.83 x 3.40 mm
