upb-lea/LEA_KiCad_Library/LEA_3D_Models/ECQ-E2475JB.stp

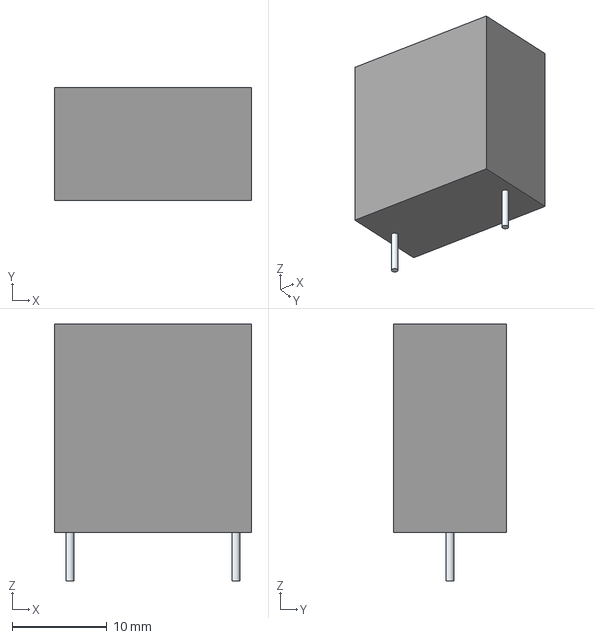
[picture p64: CAD file, 2023-08-07]
LEA_3D_Models/ECQ-E2475JB.stp
20.8 x 11.9 x 27.1 mm
Leads
