upb-lea/LEA_KiCad_Library/LEA_3D_Models/P6SMB160A-Q.stp

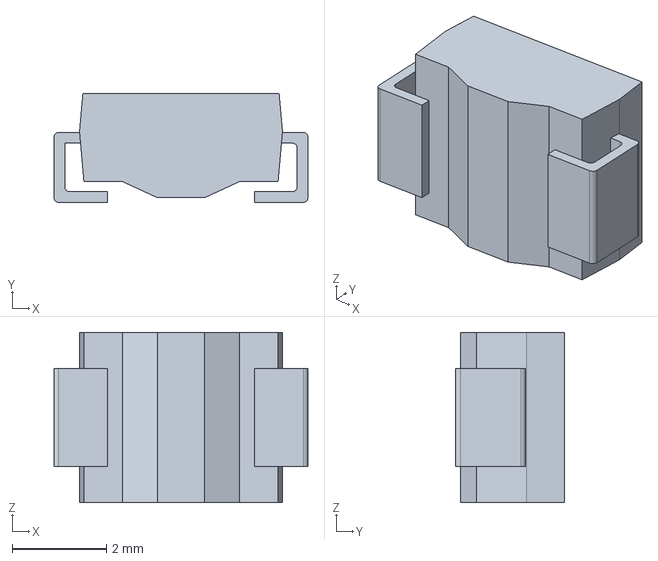
[picture p65: CAD file, 2023-08-07]
LEA_3D_Models/P6SMB160A-Q.stp
5.40 x 2.31 x 3.62 mm
