upb-lea/LEA_KiCad_Library/LEA_3D_Models/CRGP2512F47K.stp

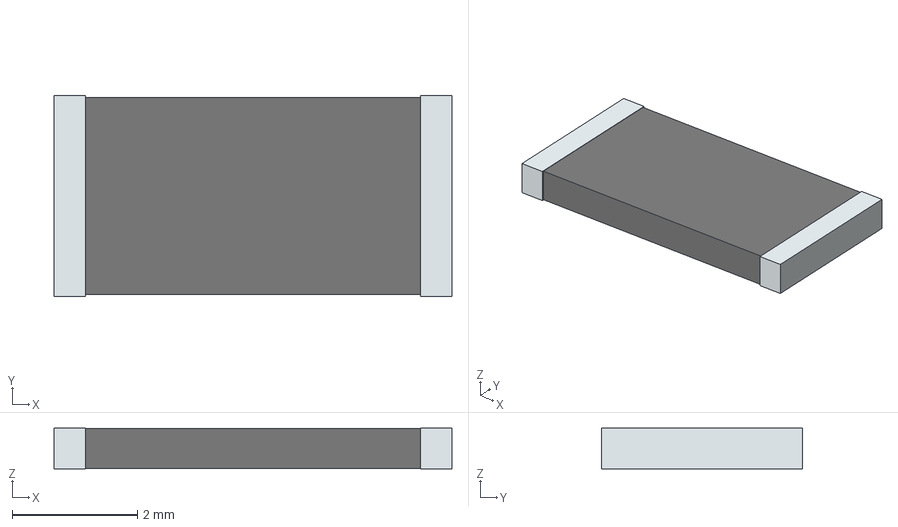
[picture p66: CAD file, 2023-08-07]
LEA_3D_Models/CRGP2512F47K.stp
6.35 x 3.20 x 0.65 mm
term1
term2
