upb-lea/LEA_KiCad_Library/LEA_3D_Models/RFN2L6SDDTE25.stp

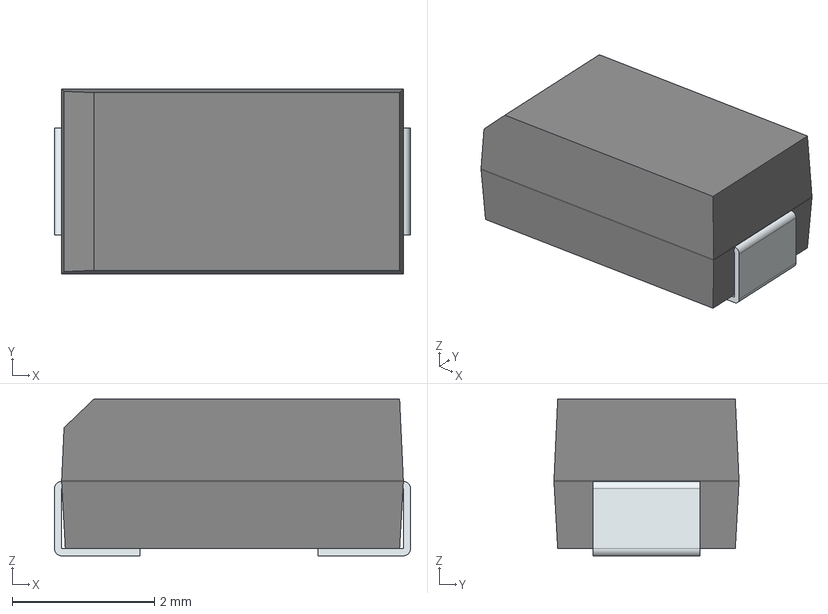
[picture p67: CAD file, 2023-08-01]
LEA_3D_Models/RFN2L6SDDTE25.stp
5.00 x 2.60 x 2.20 mm
FilletPin1
FilletPin2
