upb-lea/LEA_KiCad_Library/LEA_3D_Models/VS-5EAH02-M3_H.stp

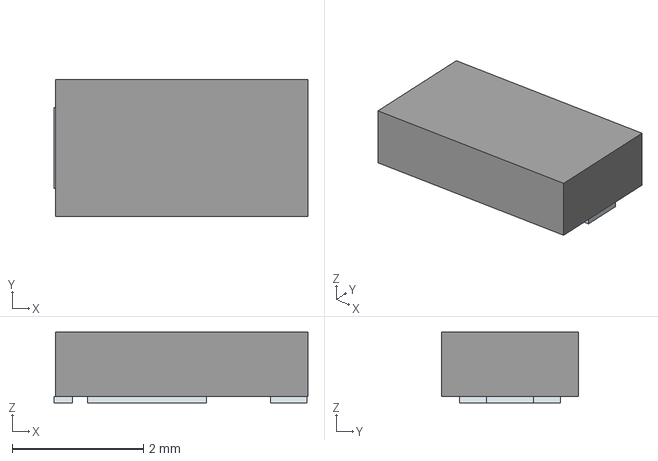
[picture p68: CAD file, 2023-08-01]
LEA_3D_Models/VS-5EAH02-M3_H.stp
3.87 x 2.08 x 1.08 mm
Pins
