upb-lea/LEA_KiCad_Library/LEA_3D_Models/DFN3820A_20220714.step

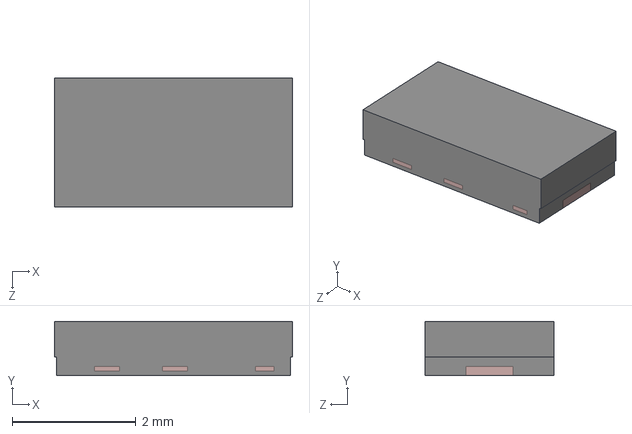
[picture p69: CAD file, 2023-08-01]
LEA_3D_Models/DFN3820A_20220714.step
3.85 x 0.88 x 2.08 mm
