upb-lea/LEA_KiCad_Library/LEA_3D_Models/Copper_block.step

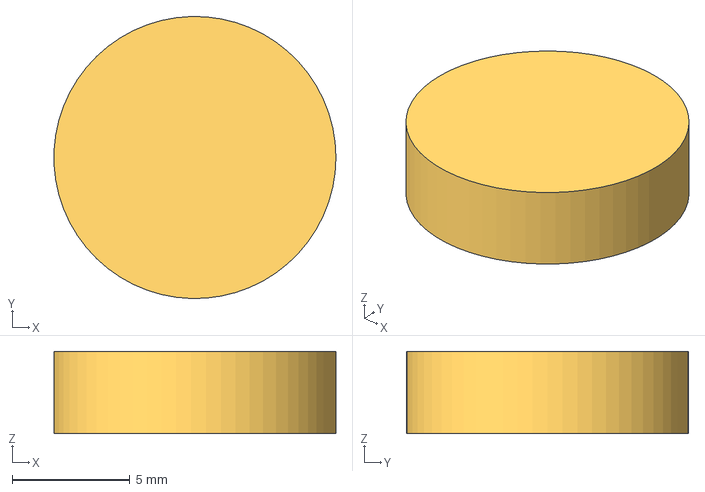
[picture p70: CAD file, 2023-08-01]
LEA_3D_Models/Copper_block.step
12.0 x 12.0 x 3.50 mm
