upb-lea/LEA_KiCad_Library/LEA_3D_Models/STD13N60M2.stp

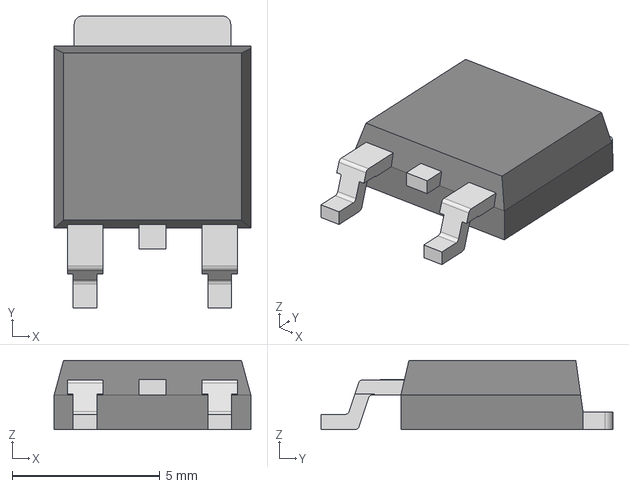
[picture p71: CAD file, 2023-08-01]
LEA_3D_Models/STD13N60M2.stp
6.65 x 9.87 x 2.33 mm
