upb-lea/LEA_KiCad_Library/LEA_3D_Models/PEM2-S24-S24-S.stp

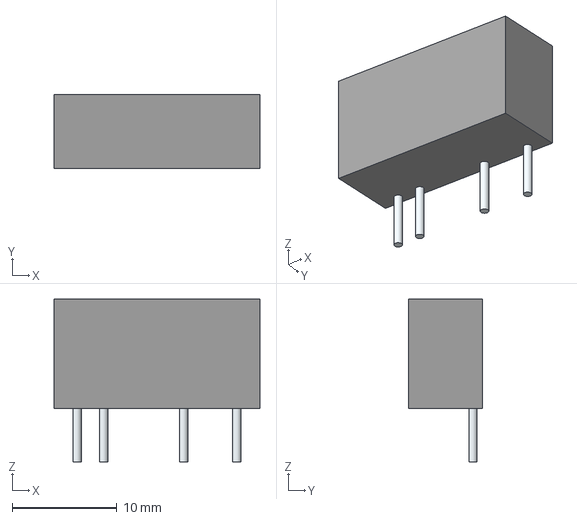
[picture p72: CAD file, 2023-07-25]
LEA_3D_Models/PEM2-S24-S24-S.stp
19.6 x 7.05 x 15.5 mm
Leads
