upb-lea/LEA_KiCad_Library/LEA_3D_Models/TS4448_RGG.stp

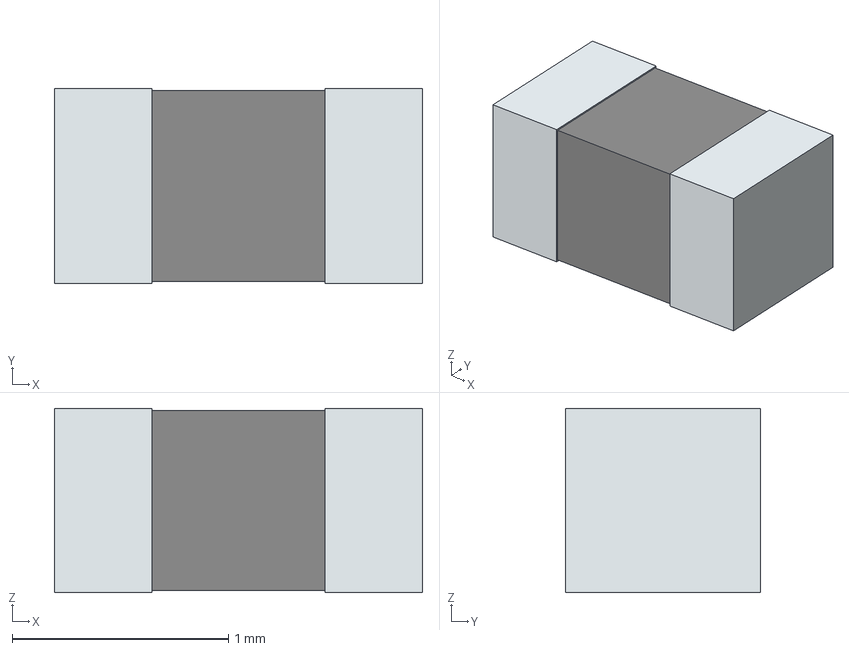
[picture p73: CAD file, 2023-07-17]
LEA_3D_Models/TS4448_RGG.stp
1.70 x 0.9 x 0.85 mm
term1
term2
