upb-lea/LEA_KiCad_Library/LEA_3D_Models/MKP1848C53080JK2.stp

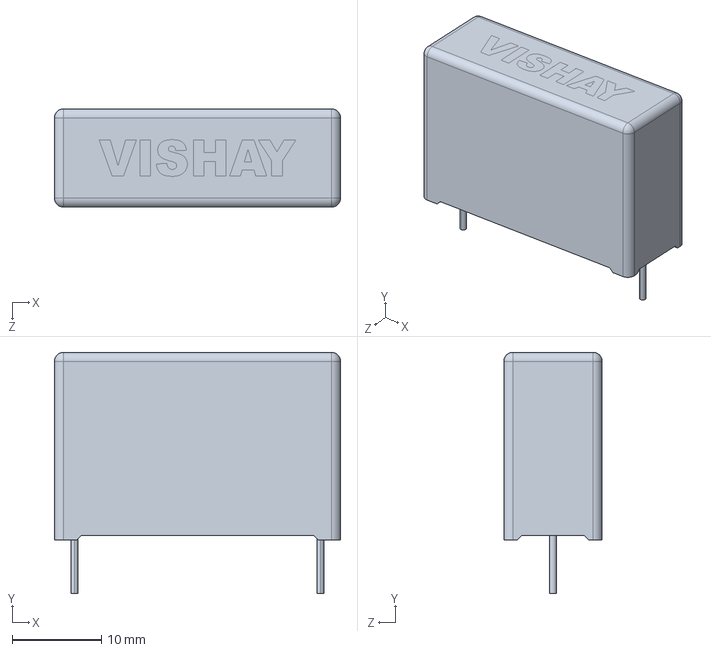
[picture p74: CAD file, 2023-07-17]
LEA_3D_Models/MKP1848C53080JK2.stp
32.0 x 27.0 x 11.0 mm
