upb-lea/LEA_KiCad_Library/LEA_3D_Models/TL431BIDBZTG4.stp

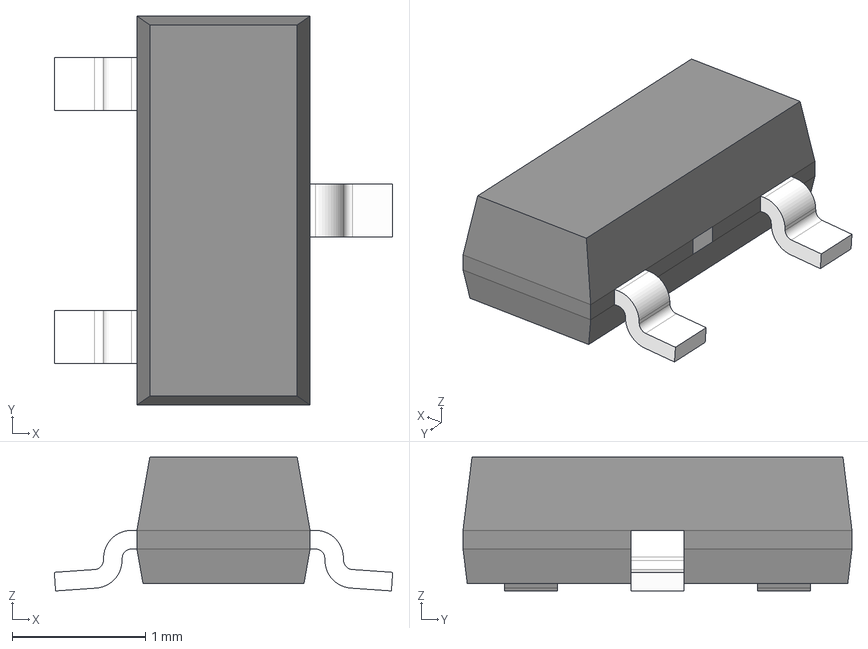
[picture p75: CAD file, 2023-07-13]
LEA_3D_Models/TL431BIDBZTG4.stp
2.54 x 2.92 x 1.01 mm
BODY-SOT
LEAD-SOT x 3
PIN1-ID
TIEBAR
