upb-lea/LEA_KiCad_Library/LEA_3D_Models/LTV-817S.stp

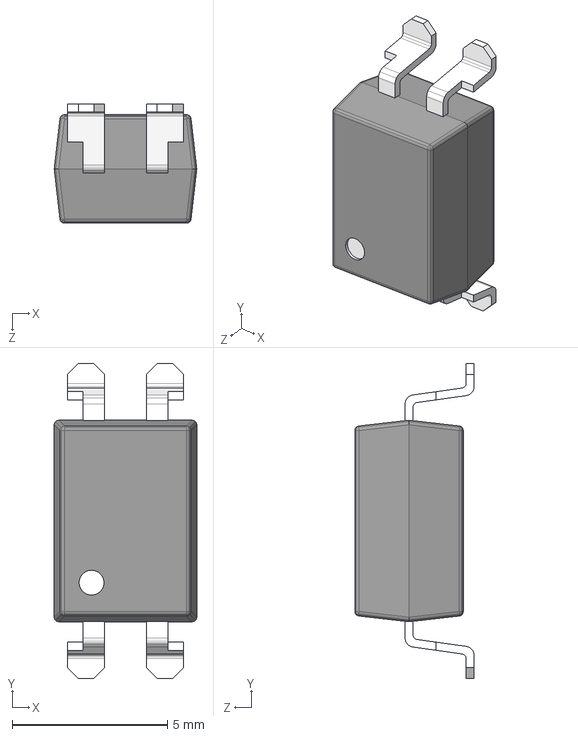
[picture p76: CAD file, 2023-07-13]
LEA_3D_Models/LTV-817S.stp
4.60 x 10.2 x 3.85 mm
