upb-lea/LEA_KiCad_Library/LEA_3D_Models/BZX384-A10-QX.stp

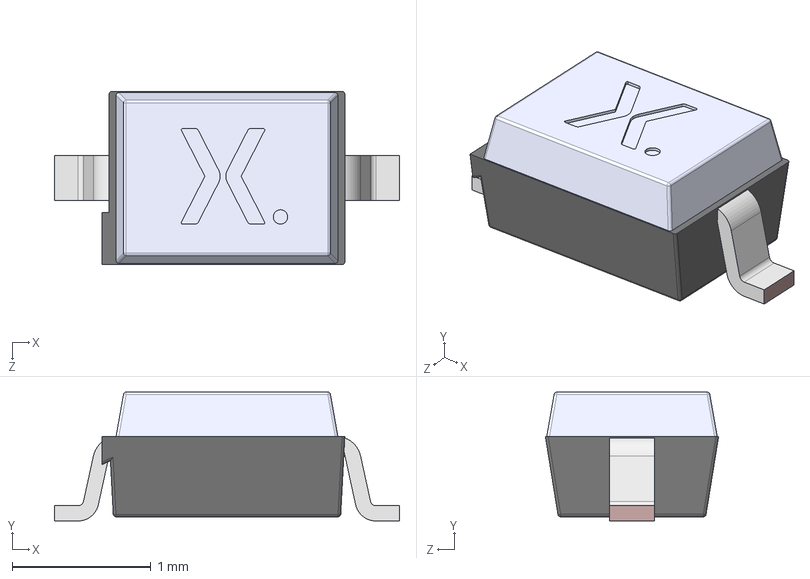
[picture p77: CAD file, 2023-07-13]
LEA_3D_Models/BZX384-A10-QX.stp
2.49 x 0.93 x 1.25 mm
SOD323 Lower body
SOD323 Lead x 2
SOD323 Upper body
