upb-lea/LEA_KiCad_Library/LEA_3D_Models/INA181A1IDBVR.stp

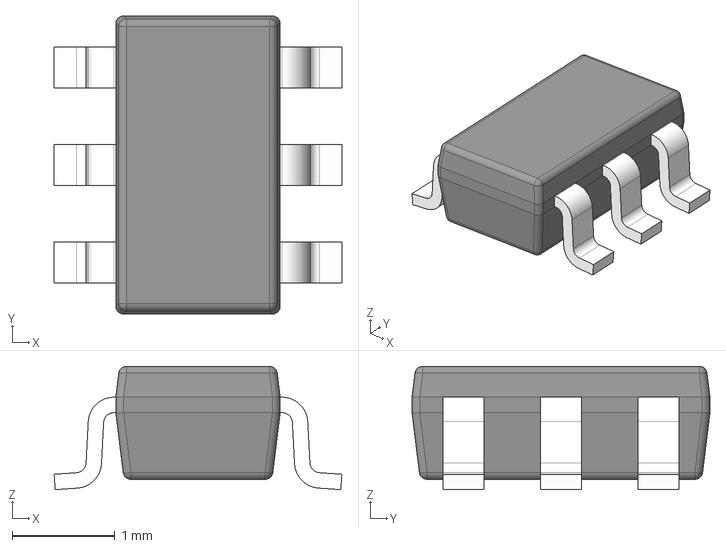
[picture p78: CAD file, 2023-07-13]
LEA_3D_Models/INA181A1IDBVR.stp
2.80 x 2.90 x 1.20 mm
BODY-SOT
LEAD-SOT x 6
