upb-lea/LEA_KiCad_Library/LEA_3D_Models/BA033CC0FP-E2.stp

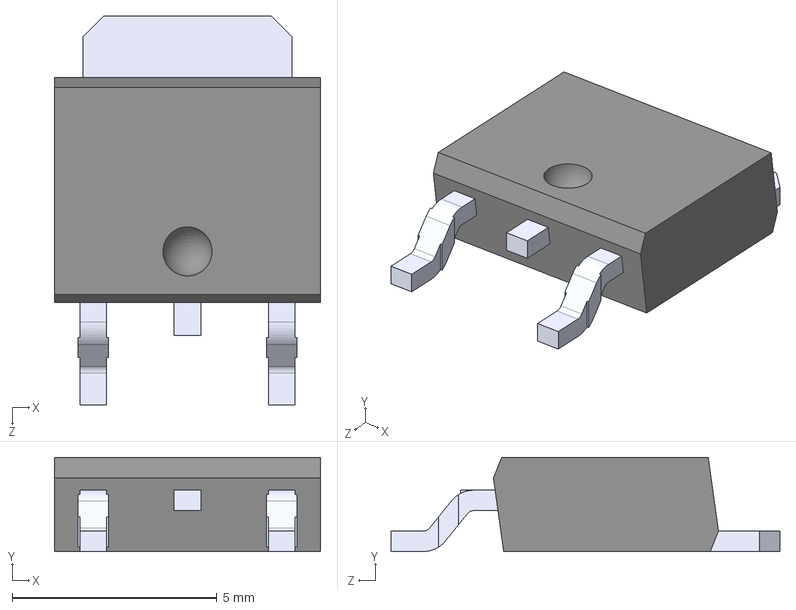
[picture p79: CAD file, 2023-07-13]
LEA_3D_Models/BA033CC0FP-E2.stp
6.50 x 2.30 x 9.50 mm
