upb-lea/LEA_KiCad_Library/LEA_3D_Models/ES2C-E3_52T.stp

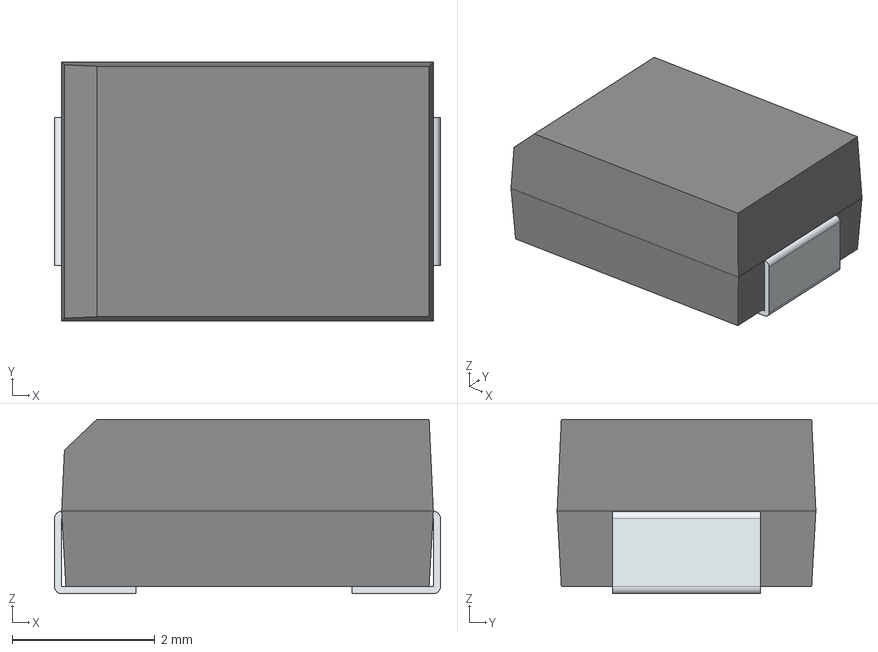
[picture p80: CAD file, 2023-07-13]
LEA_3D_Models/ES2C-E3_52T.stp
5.40 x 3.62 x 2.44 mm
FilletPin1
FilletPin2
