upb-lea/LEA_KiCad_Library/LEA_3D_Models/PCS2512FR0050ET.stp

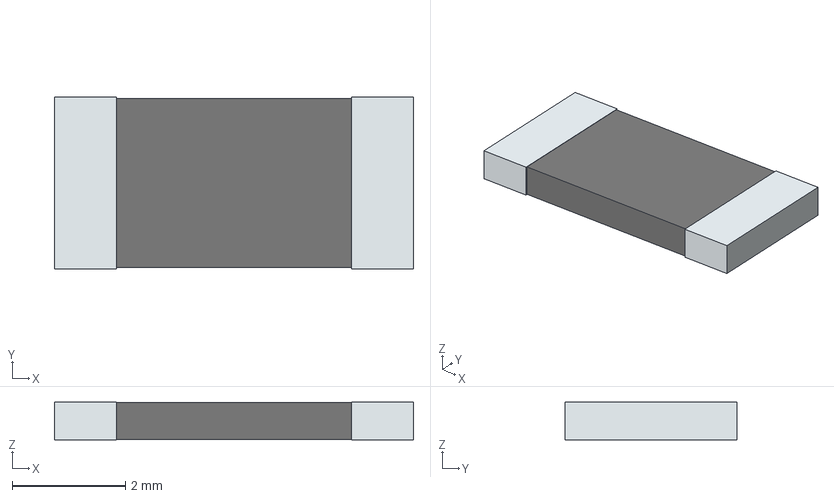
[picture p81: CAD file, 2023-07-06]
LEA_3D_Models/PCS2512FR0050ET.stp
6.35 x 3.05 x 0.664 mm
term1
term2
