upb-lea/LEA_KiCad_Library/LEA_3D_Models/B140HW-7.stp

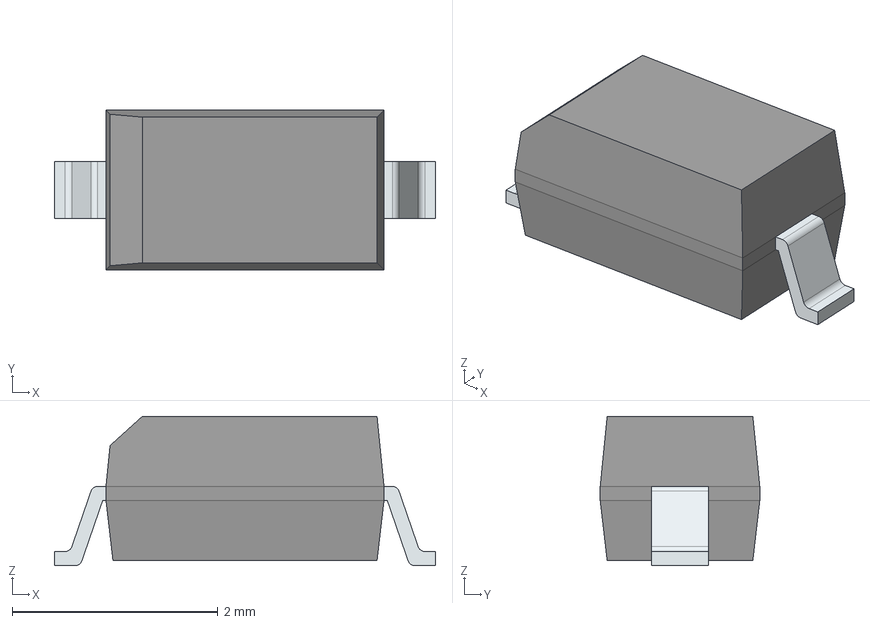
[picture p82: CAD file, 2023-07-06]
LEA_3D_Models/B140HW-7.stp
3.70 x 1.55 x 1.45 mm
FilletPinL
FilletPinR
