upb-lea/LEA_KiCad_Library/LEA_3D_Models/PLZ6V2C-G3_H.stp

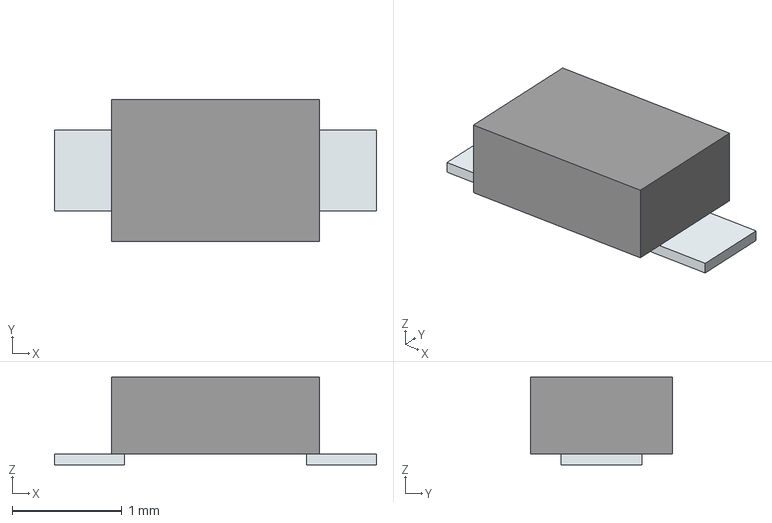
[picture p83: CAD file, 2023-07-06]
LEA_3D_Models/PLZ6V2C-G3_H.stp
2.94 x 1.30 x 0.8 mm
Pins
