upb-lea/LEA_KiCad_Library/LEA_3D_Models/CU8965-ALC.stp

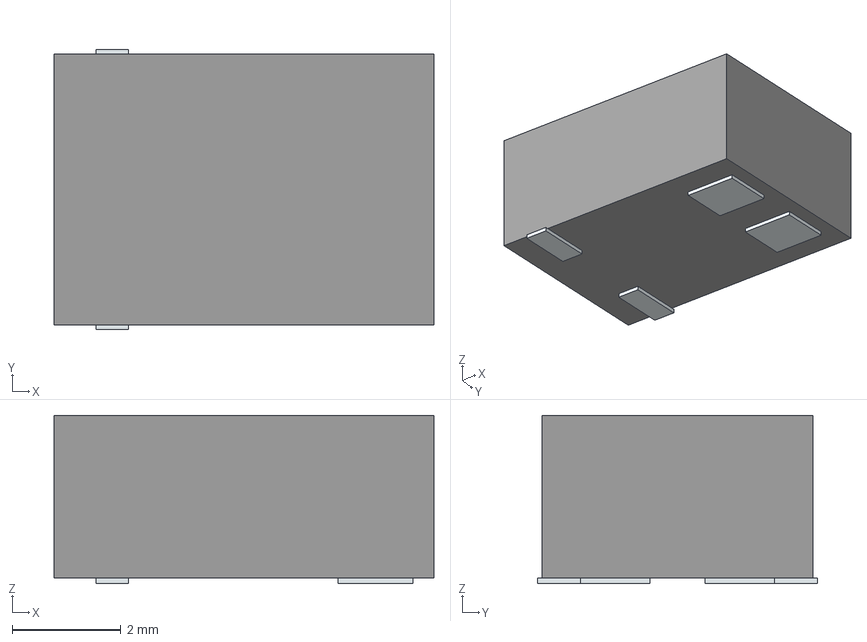
[picture p84: CAD file, 2023-07-06]
LEA_3D_Models/CU8965-ALC.stp
7.00 x 5.15 x 3.10 mm
Pins
