upb-lea/LEA_KiCad_Library/LEA_3D_Models/BAT54S-7-F.stp

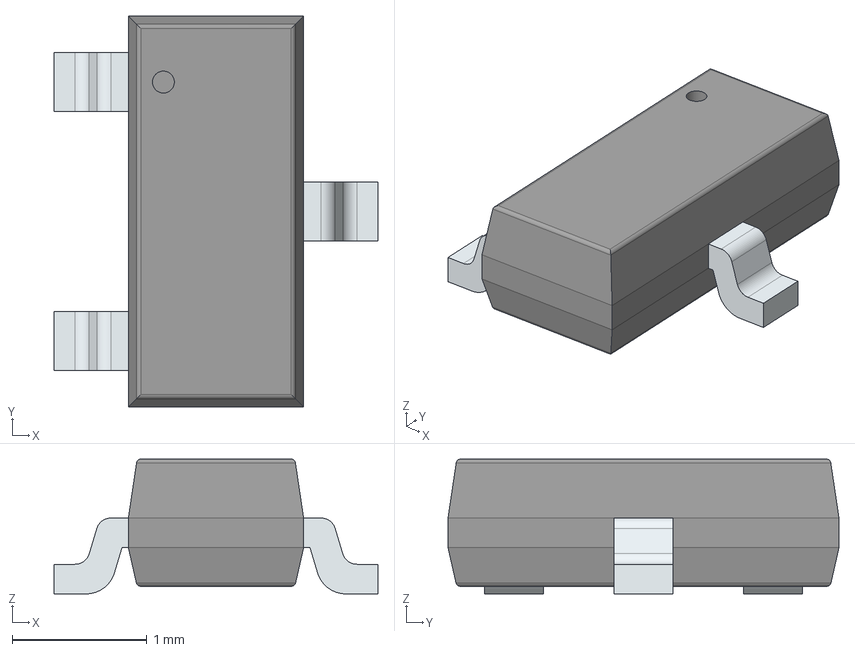
[picture p85: CAD file, 2023-07-06]
LEA_3D_Models/BAT54S-7-F.stp
2.40 x 2.90 x 1.00 mm
PinsArrayL
FilletPinR
