upb-lea/LEA_KiCad_Library/LEA_3D_Models/ERJ-8RQF1R3V.stp

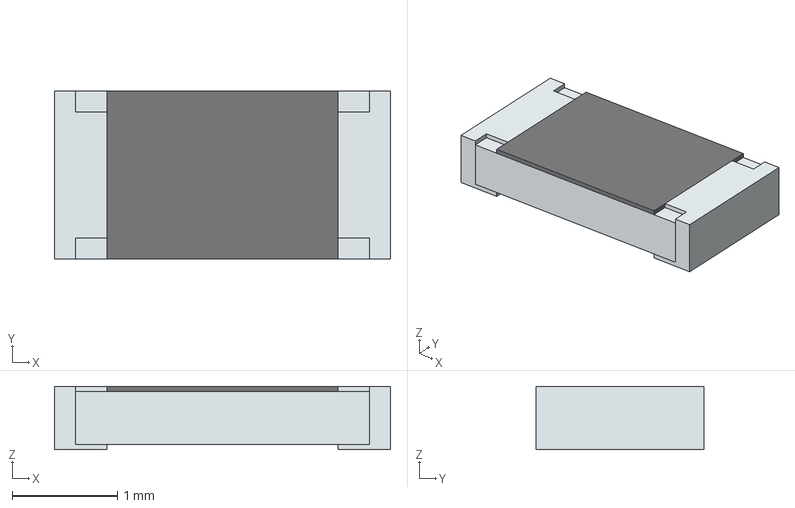
[picture p86: CAD file, 2023-07-06]
LEA_3D_Models/ERJ-8RQF1R3V.stp
3.20 x 1.60 x 0.6 mm
solidBody
Terminal
solidTop
