upb-lea/LEA_KiCad_Library/LEA_3D_Models/NFBGA-337_TI.step

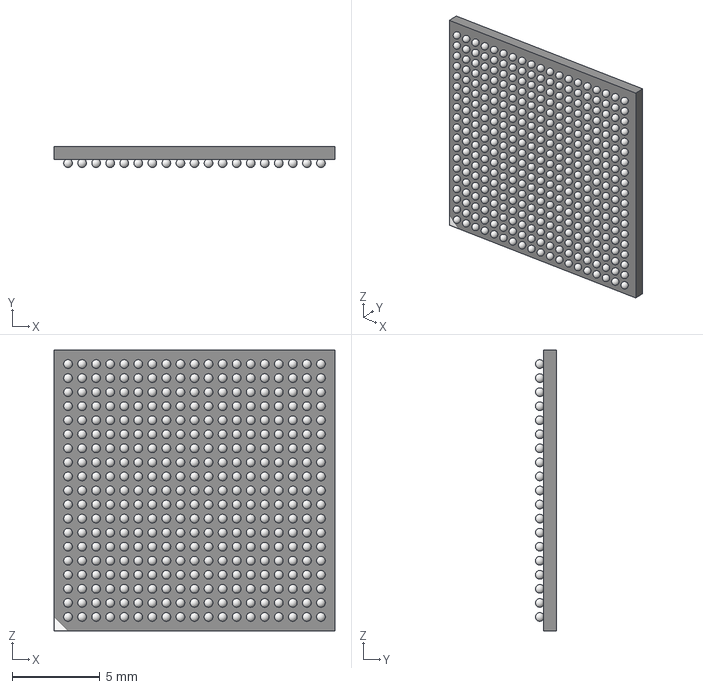
[picture p87: CAD file, 2023-04-09]
LEA_3D_Models/NFBGA-337_TI.step
16.0 x 1.20 x 16.0 mm
