upb-lea/LEA_KiCad_Library/LEA_3D_Models/MSOP-10_RM10.step

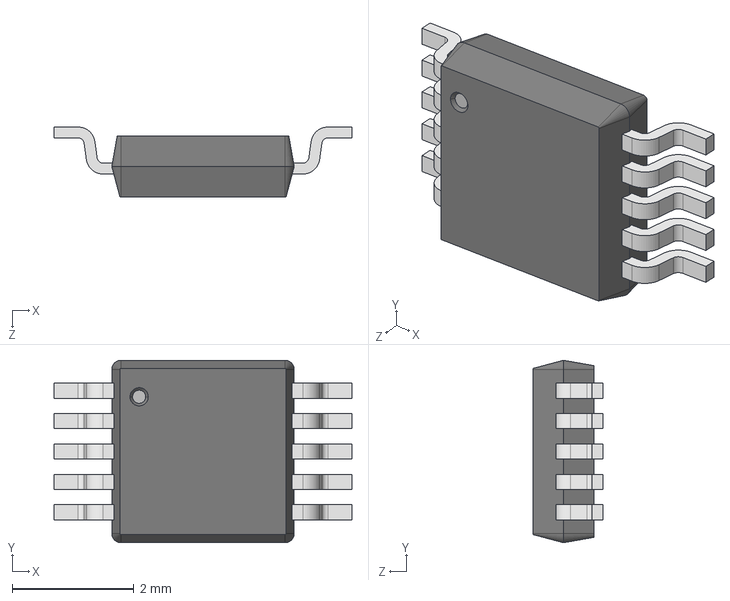
[picture p88: CAD file, 2023-04-09]
LEA_3D_Models/MSOP-10_RM10.step
4.90 x 3.00 x 1.15 mm
