upb-lea/LEA_KiCad_Library/LEA_3D_Models/Molex532617006.step

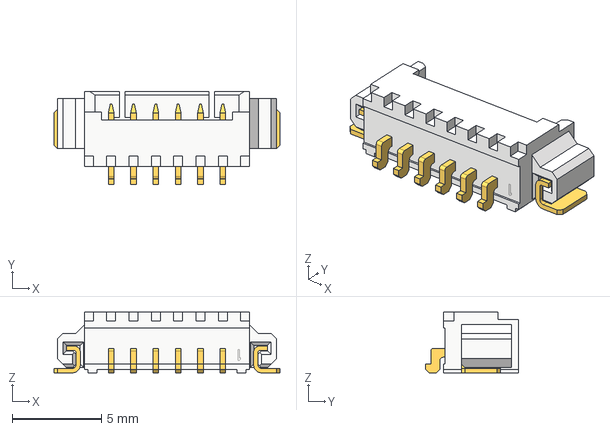
[picture p89: CAD file, 2023-04-09]
LEA_3D_Models/Molex532617006.step
12.7 x 5.20 x 3.40 mm
