upb-lea/LEA_KiCad_Library/LEA_3D_Models/R_0603_1608Metric.step

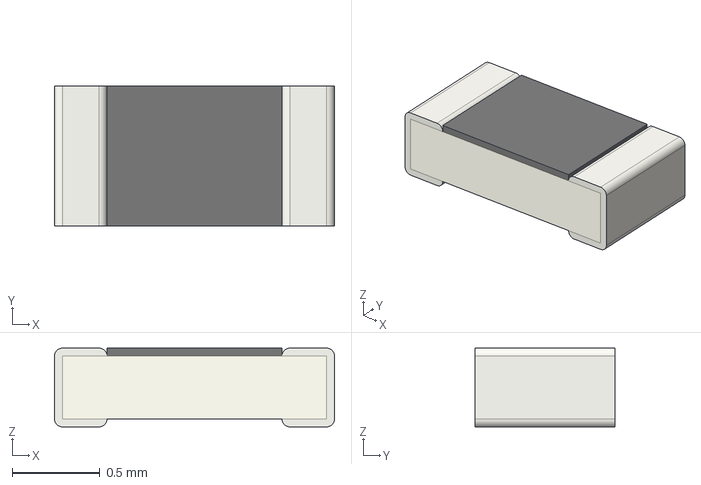
[picture p90: CAD file, 2023-04-09]
LEA_3D_Models/R_0603_1608Metric.step
1.60 x 0.8 x 0.45 mm
