upb-lea/LEA_KiCad_Library/LEA_3D_Models/2MS1T1B1M2QES.stp

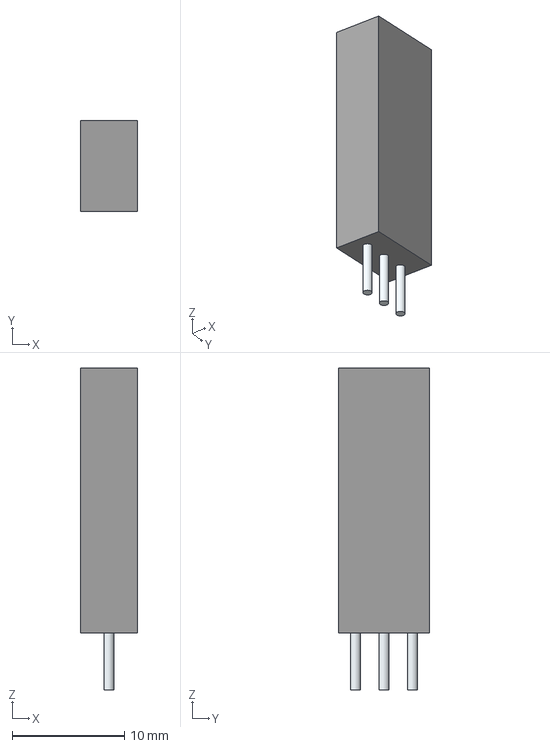
[picture p91: CAD file, 2023-04-09]
LEA_3D_Models/2MS1T1B1M2QES.stp
5.08 x 8.13 x 28.7 mm
Leads
