upb-lea/LEA_KiCad_Library/LEA_3D_Models/TSSOP-14.step

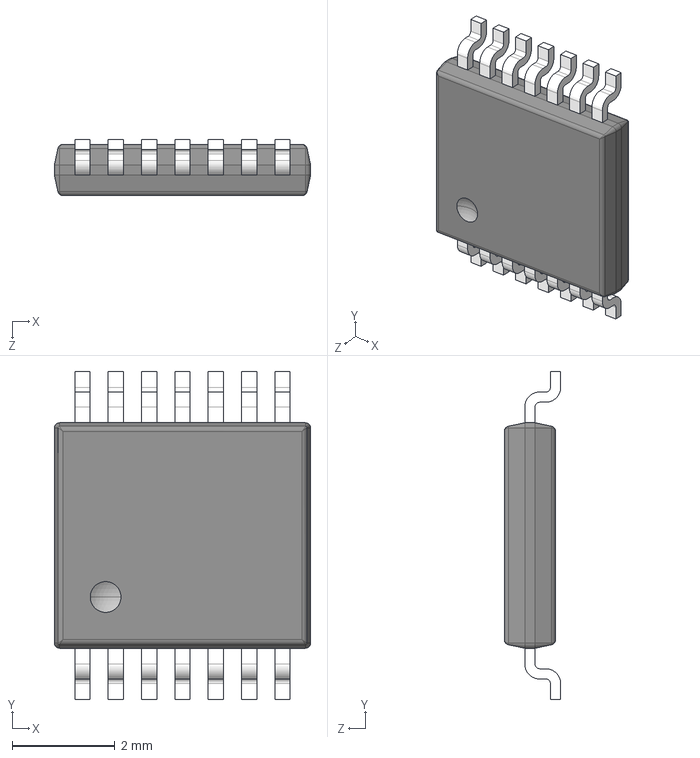
[picture p92: CAD file, 2023-04-09]
LEA_3D_Models/TSSOP-14.step
5.00 x 6.40 x 1.10 mm
