upb-lea/LEA_KiCad_Library/LEA_3D_Models/MAX_QSOP16.step

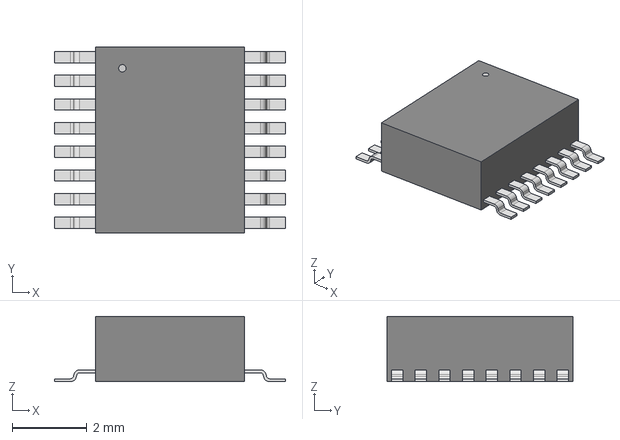
[picture p93: CAD file, 2023-04-09]
LEA_3D_Models/MAX_QSOP16.step
6.20 x 4.98 x 1.75 mm
