upb-lea/LEA_KiCad_Library/LEA_3D_Models/SOIC-16_TI_DW.step

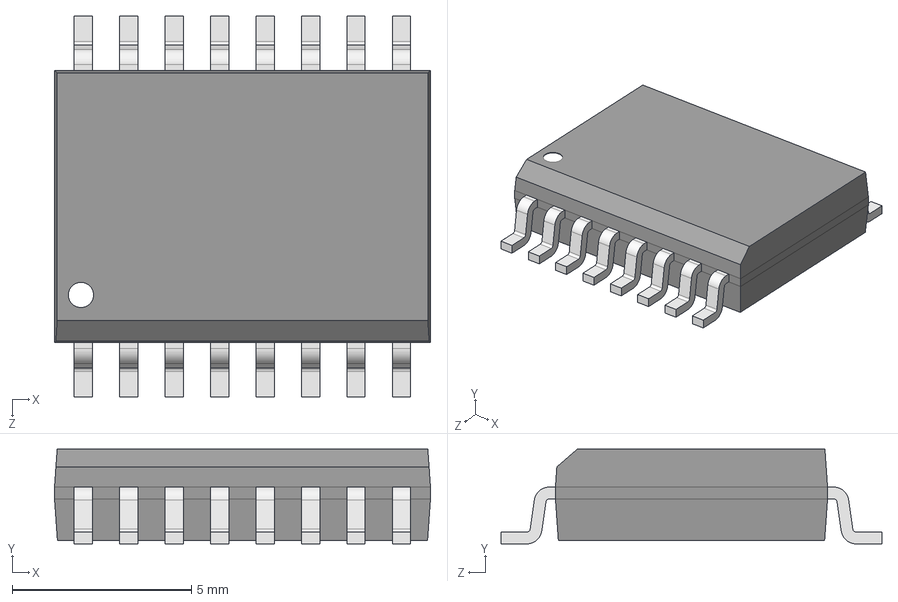
[picture p94: CAD file, 2023-04-09]
LEA_3D_Models/SOIC-16_TI_DW.step
10.5 x 2.65 x 10.6 mm
