upb-lea/LEA_KiCad_Library/LEA_3D_Models/SOT-223.step

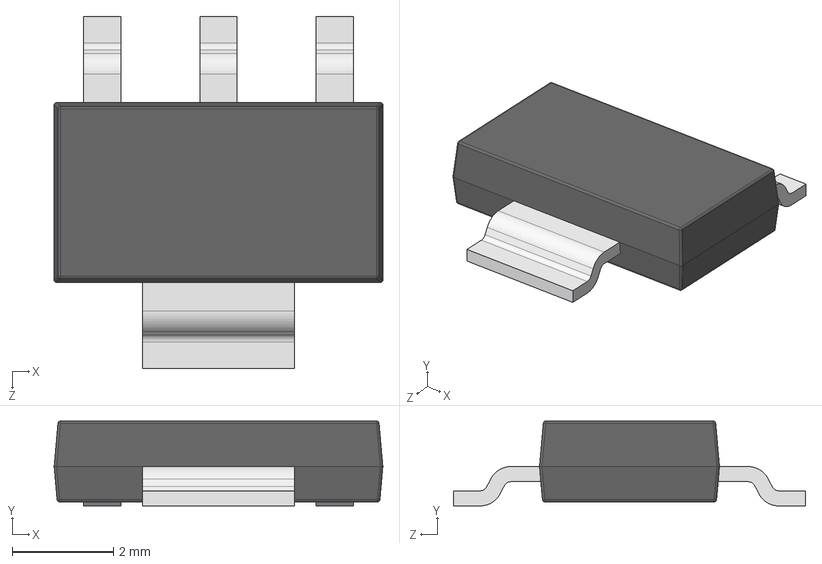
[picture p95: CAD file, 2023-04-09]
LEA_3D_Models/SOT-223.step
6.50 x 1.68 x 6.96 mm
