upb-lea/LEA_KiCad_Library/LEA_3D_Models/Con_SMA_PCB.stp

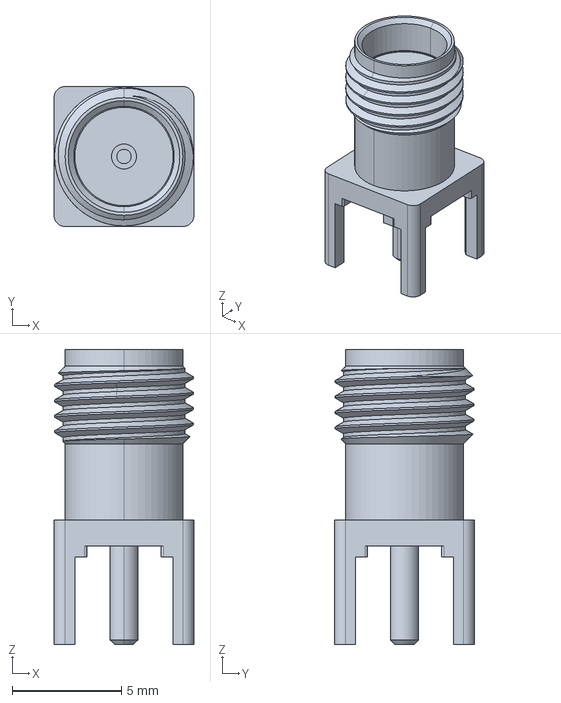
[picture p96: CAD file, 2023-04-09]
LEA_3D_Models/Con_SMA_PCB.stp
6.40 x 6.40 x 13.5 mm
