upb-lea/LEA_KiCad_Library/LEA_3D_Models/SOT-223-6.stp

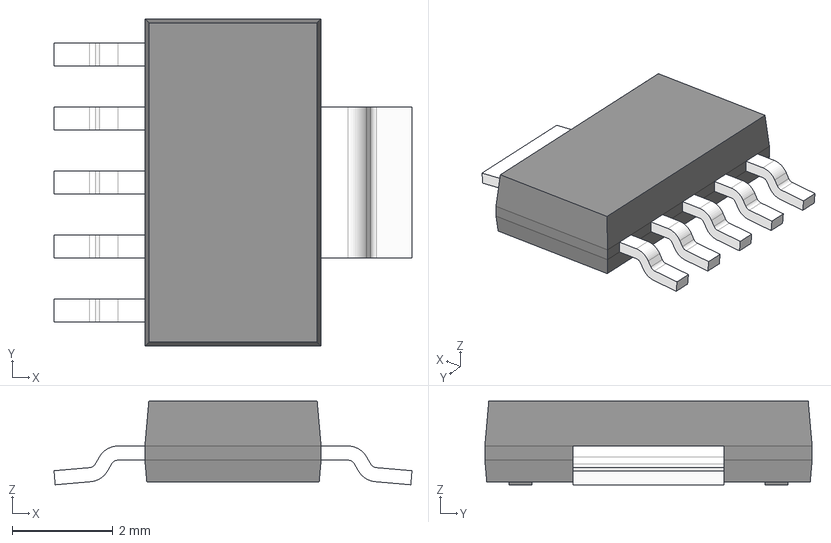
[picture p97: CAD file, 2023-04-09]
LEA_3D_Models/SOT-223-6.stp
7.11 x 6.50 x 1.66 mm
LEAD x 5
LEAD_WIDE
