upb-lea/LEA_KiCad_Library/LEA_3D_Models/LED_Green_0603.STEP

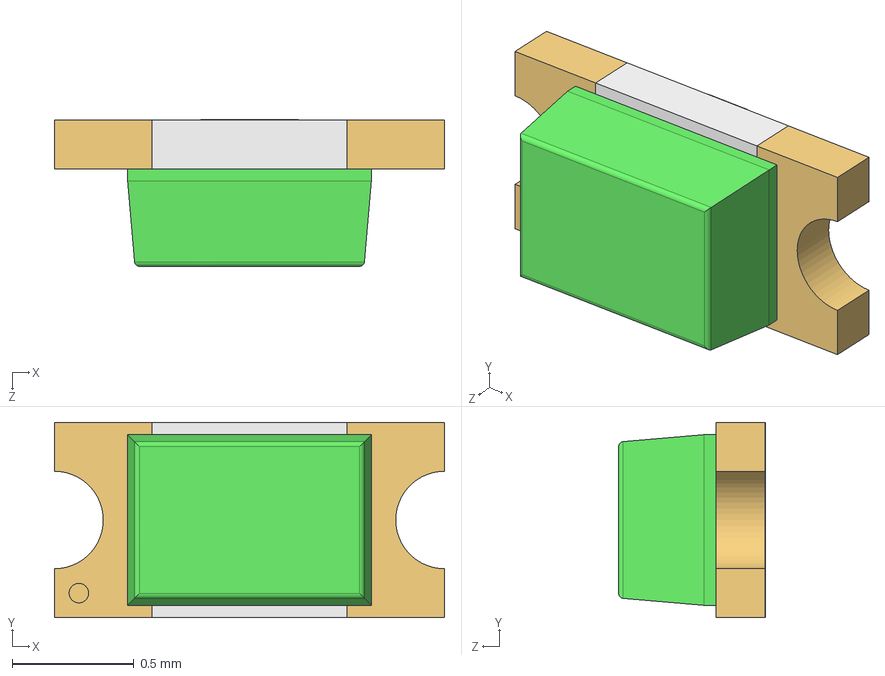
[picture p98: CAD file, 2023-04-09]
LEA_3D_Models/LED_Green_0603.STEP
1.60 x 0.8 x 0.602 mm
