upb-lea/LEA_KiCad_Library/LEA_3D_Models/SOIC-16_3.9x9.9mm_P1.27mm.step

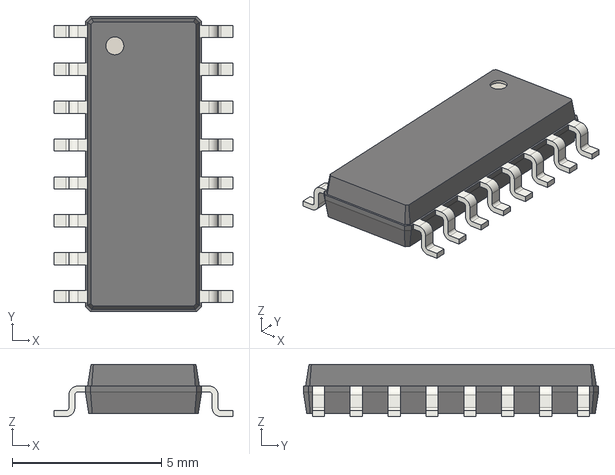
[picture p99: CAD file, 2023-04-09]
LEA_3D_Models/SOIC-16_3.9x9.9mm_P1.27mm.step
6.00 x 9.90 x 1.75 mm
