upb-lea/LEA_KiCad_Library/LEA_3D_Models/Trim_84W.stp

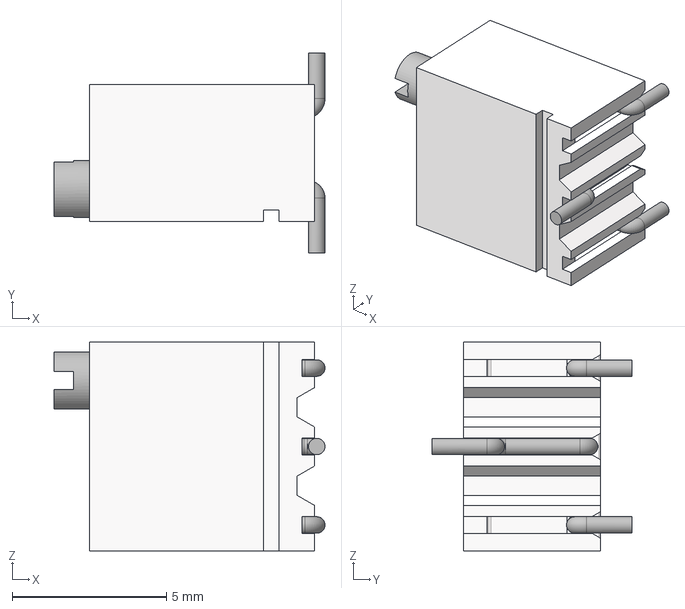
[picture p100: CAD file, 2023-04-09]
LEA_3D_Models/Trim_84W.stp
8.78 x 6.48 x 6.76 mm
