upb-lea/LEA_KiCad_Library/LEA_3D_Models/Murata_MEJ1S_SIP-7_DCDC.step

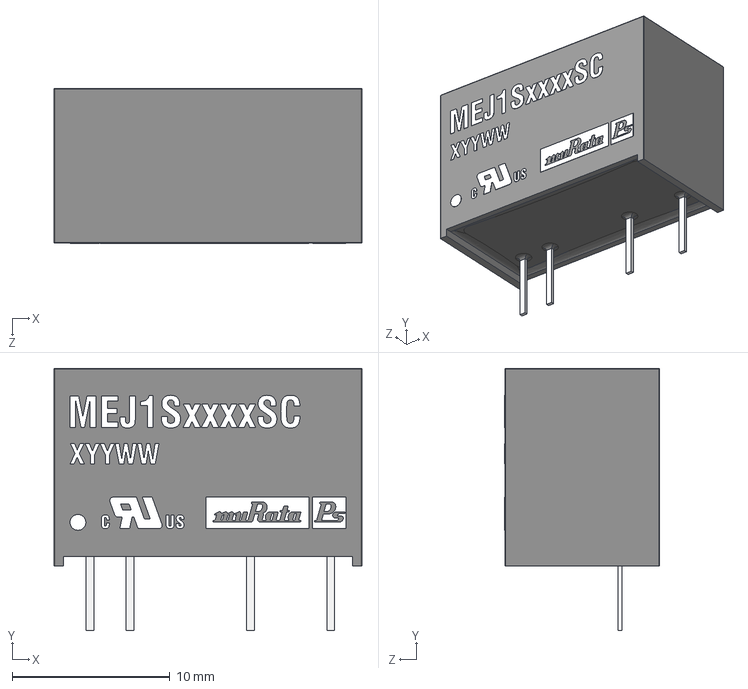
[picture p101: CAD file, 2023-04-09]
LEA_3D_Models/Murata_MEJ1S_SIP-7_DCDC.step
19.5 x 16.6 x 9.82 mm
