upb-lea/LEA_KiCad_Library/LEA_3D_Models/Murata_NKE_DIP_DCDC.step

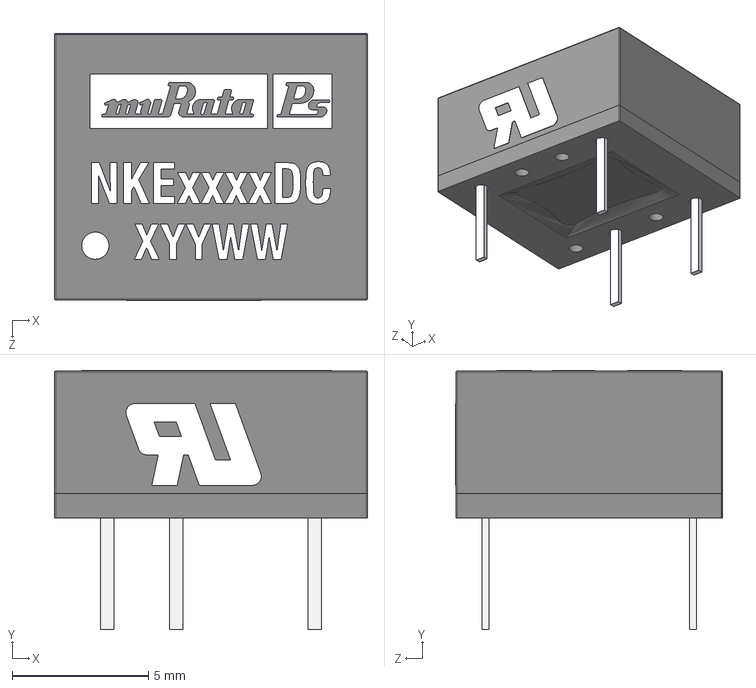
[picture p102: CAD file, 2023-04-09]
LEA_3D_Models/Murata_NKE_DIP_DCDC.step
11.5 x 9.52 x 9.82 mm
