upb-lea/LEA_KiCad_Library/LEA_3D_Models/CAS-120TA.step

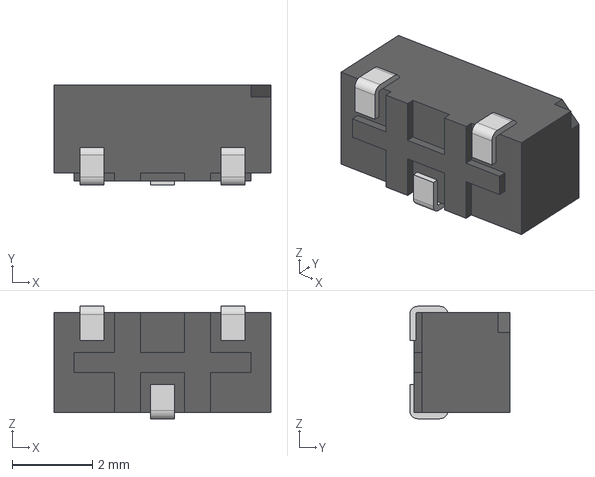
[picture p103: CAD file, 2023-04-09]
LEA_3D_Models/CAS-120TA.step
5.40 x 2.50 x 2.80 mm
_CAS_c_12A
_1 pole_s
