upb-lea/LEA_KiCad_Library/LEA_3D_Models/SOT-23-6.step

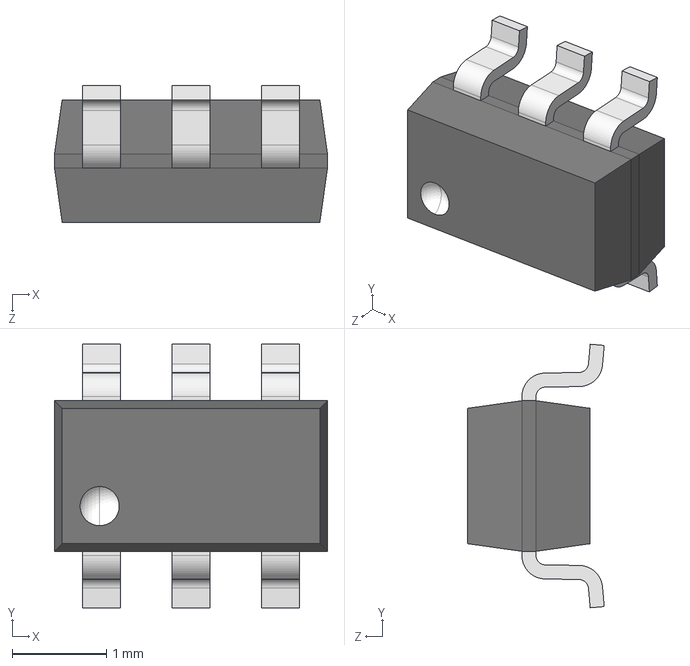
[picture p104: CAD file, 2023-04-09]
LEA_3D_Models/SOT-23-6.step
2.90 x 2.80 x 1.45 mm
