upb-lea/LEA_KiCad_Library/LEA_3D_Models/Con_DPT_Signal.stp

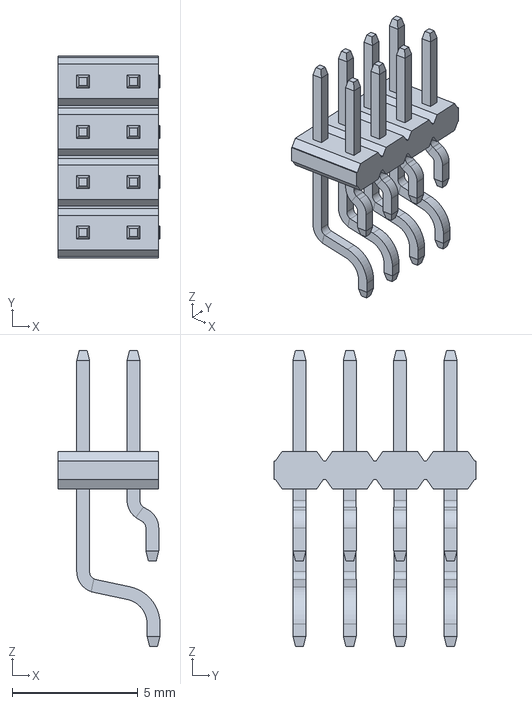
[picture p105: CAD file, 2023-04-09]
LEA_3D_Models/Con_DPT_Signal.stp
4.05 x 8.00 x 11.8 mm
