upb-lea/LEA_KiCad_Library/LEA_3D_Models/R_0805_2012Metric.step

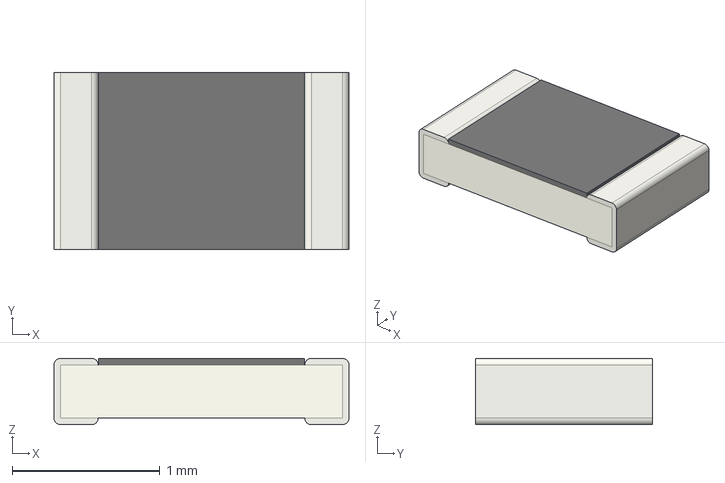
[picture p106: CAD file, 2023-04-09]
LEA_3D_Models/R_0805_2012Metric.step
2.00 x 1.20 x 0.45 mm
