upb-lea/LEA_KiCad_Library/LEA_3D_Models/MSOP8.step

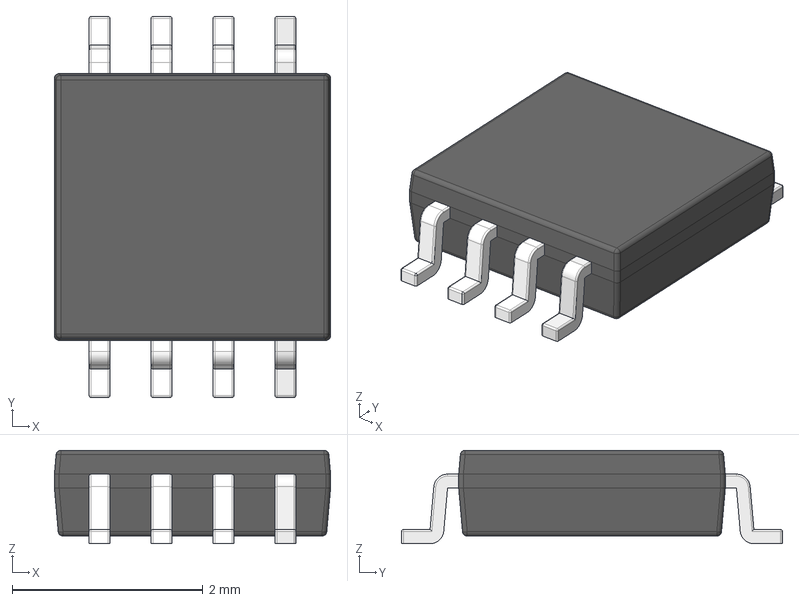
[picture p107: CAD file, 2023-04-09]
LEA_3D_Models/MSOP8.step
2.90 x 4.00 x 0.98 mm
