upb-lea/LEA_KiCad_Library/LEA_3D_Models/HC49_US.step

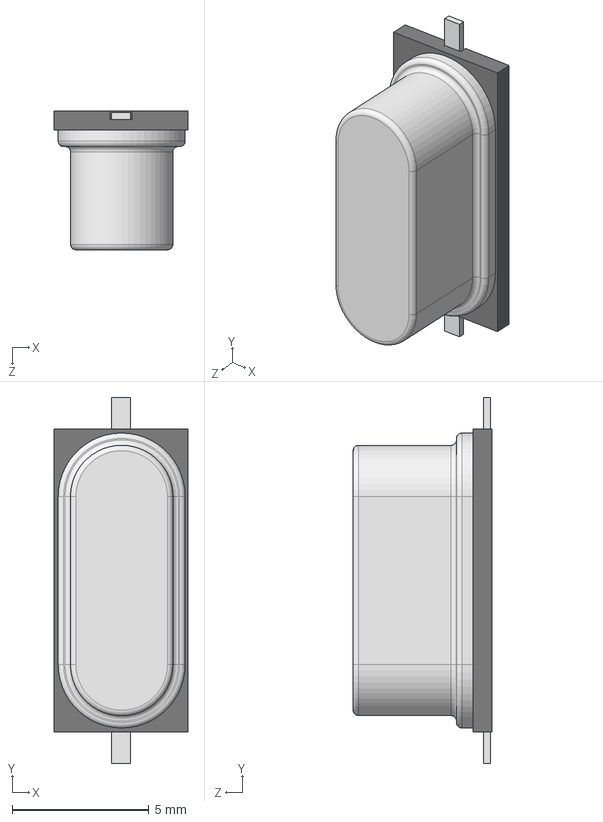
[picture p108: CAD file, 2023-04-09]
LEA_3D_Models/HC49_US.step
4.90 x 13.4 x 5.08 mm
