upb-lea/LEA_KiCad_Library/LEA_3D_Models/SOIC-14_3.9x8.7mm_P1.27mm.step

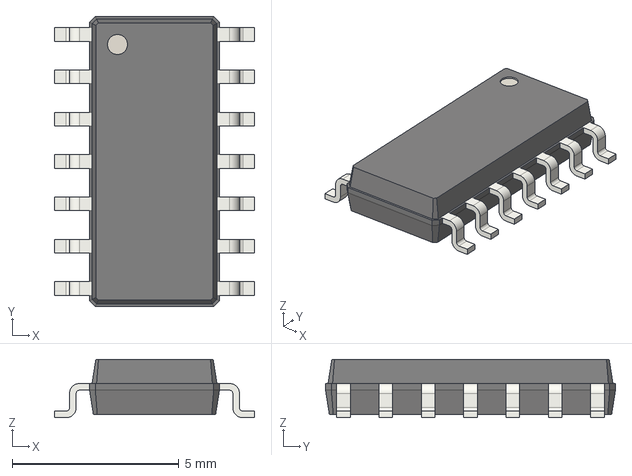
[picture p109: CAD file, 2023-04-09]
LEA_3D_Models/SOIC-14_3.9x8.7mm_P1.27mm.step
6.00 x 8.70 x 1.75 mm
