upb-lea/LEA_KiCad_Library/LEA_3D_Models/CAS-D20TA.step

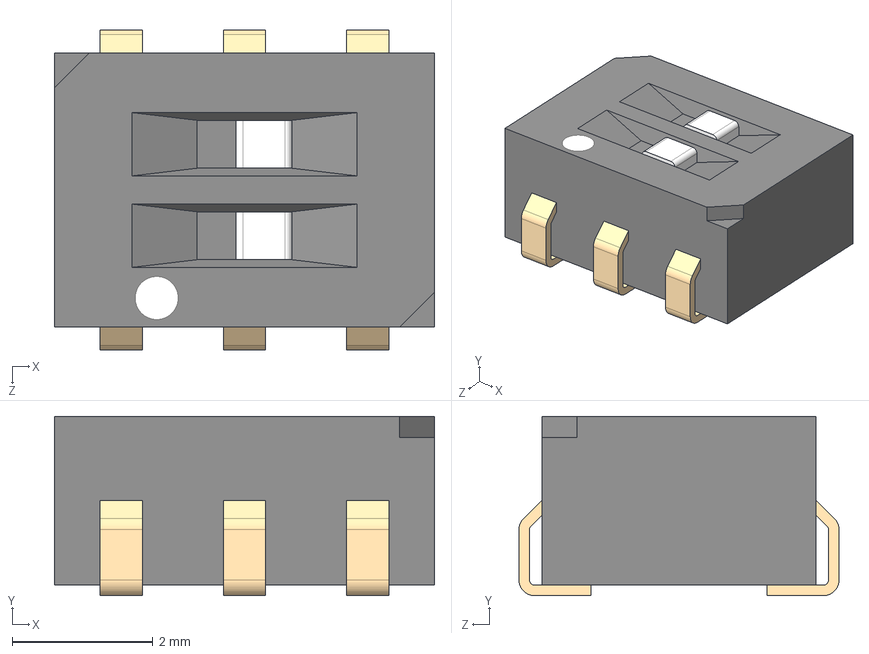
[picture p110: CAD file, 2023-04-09]
LEA_3D_Models/CAS-D20TA.step
5.40 x 2.55 x 4.55 mm
