upb-lea/LEA_KiCad_Library/LEA_3D_Models/USB4110.stp

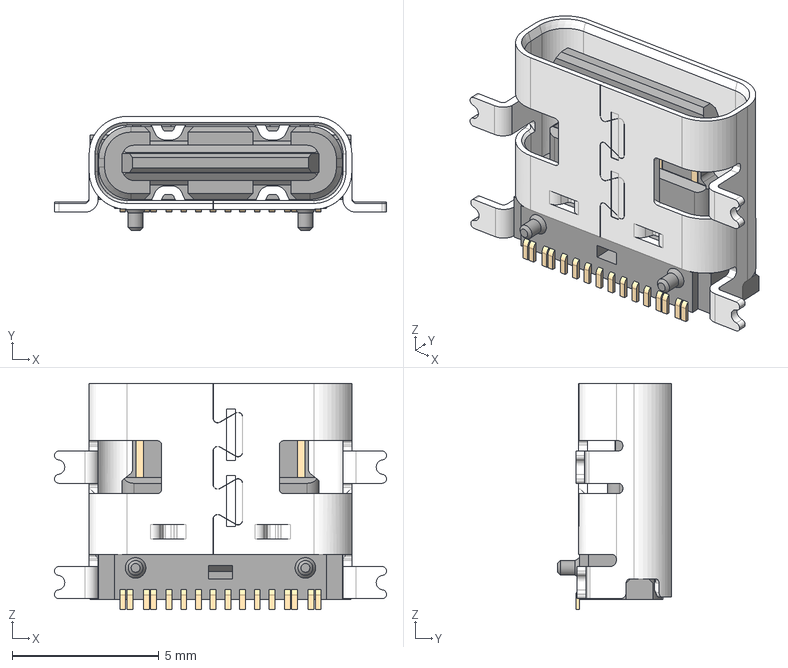
[picture p111: CAD file, 2023-04-09]
LEA_3D_Models/USB4110.stp
11.3 x 3.89 x 7.70 mm
