upb-lea/LEA_KiCad_Library/LEA_3D_Models/Molex2171790001.step

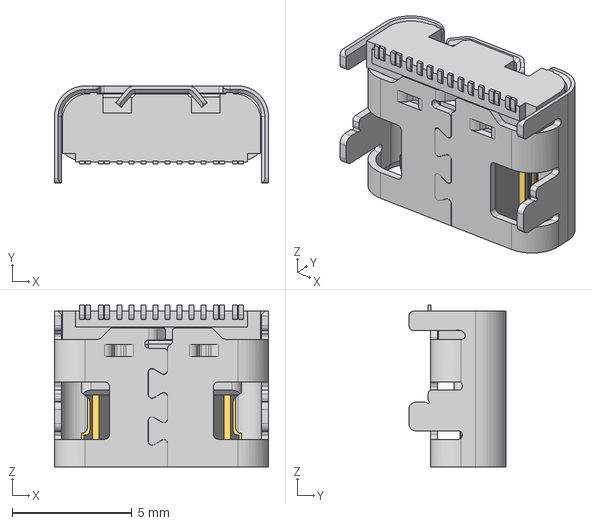
[picture p112: CAD file, 2023-04-09]
LEA_3D_Models/Molex2171790001.step
8.94 x 4.06 x 6.75 mm
