upb-lea/LEA_KiCad_Library/LEA_3D_Models/Potentiometer_PTV09A-4020F-B103.stp

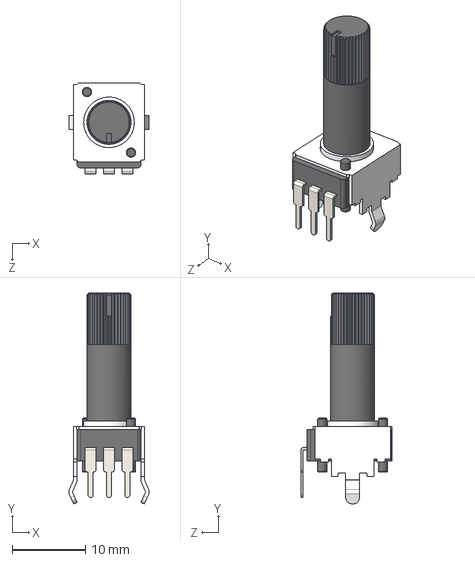
[picture p113: CAD file, 2023-04-09]
LEA_3D_Models/Potentiometer_PTV09A-4020F-B103.stp
11.0 x 28.7 x 12.5 mm
