upb-lea/LEA_KiCad_Library/LEA_3D_Models/LED_Green_0402.STEP

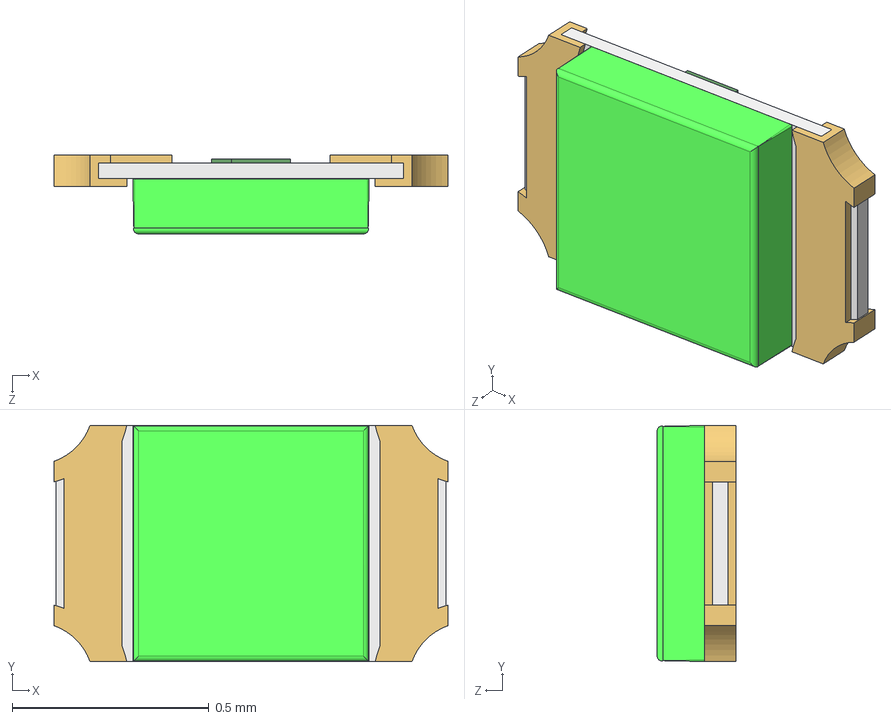
[picture p114: CAD file, 2023-04-09]
LEA_3D_Models/LED_Green_0402.STEP
1.00 x 0.6 x 0.2 mm
Grnn
Cut005_(Mirror_#1)
