upb-lea/LEA_KiCad_Library/LEA_3D_Models/Con_BNC_PCB.stp

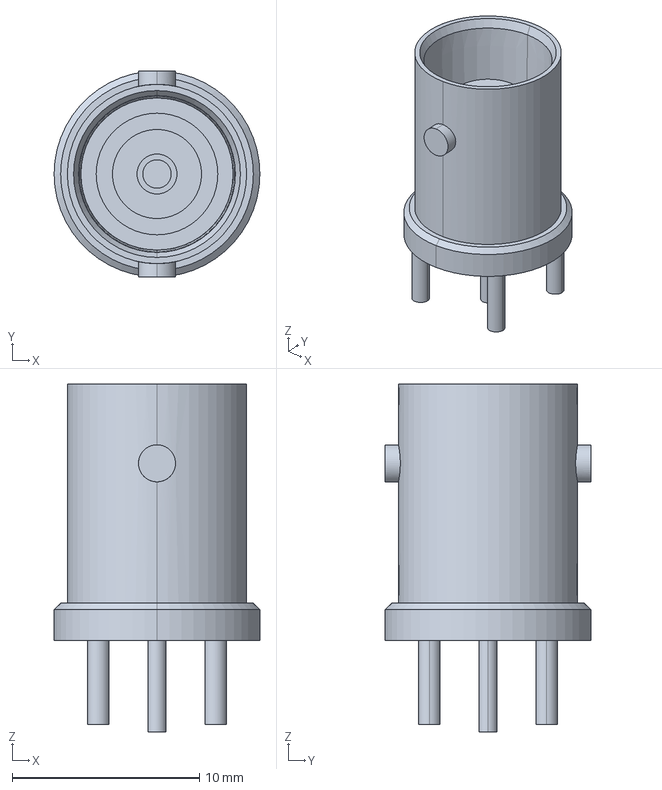
[picture p115: CAD file, 2023-04-09]
LEA_3D_Models/Con_BNC_PCB.stp
11.0 x 11.0 x 18.6 mm
