upb-lea/LEA_KiCad_Library/LEA_3D_Models/ECS-2520.STEP

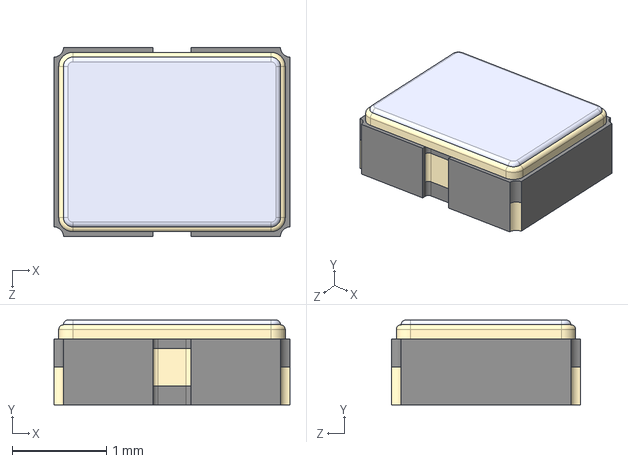
[picture p116: CAD file, 2023-04-09]
LEA_3D_Models/ECS-2520.STEP
2.50 x 0.9 x 2.00 mm
