upb-lea/LEA_KiCad_Library/LEA_3D_Models/ECS-5032.step

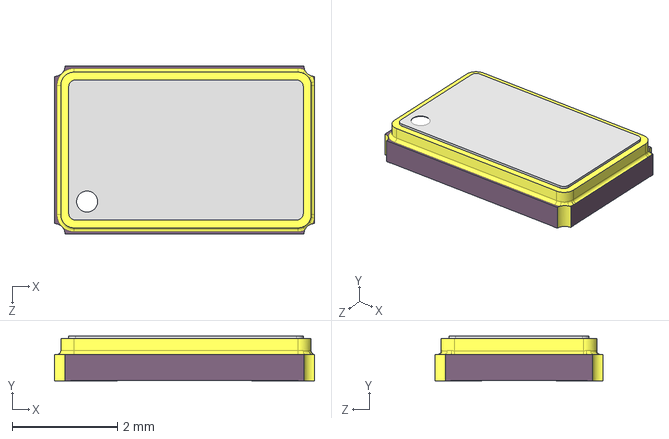
[picture p117: CAD file, 2023-04-09]
LEA_3D_Models/ECS-5032.step
4.94 x 0.855 x 3.20 mm
