upb-lea/LEA_KiCad_Library/LEA_3D_Models/SOD-323.step

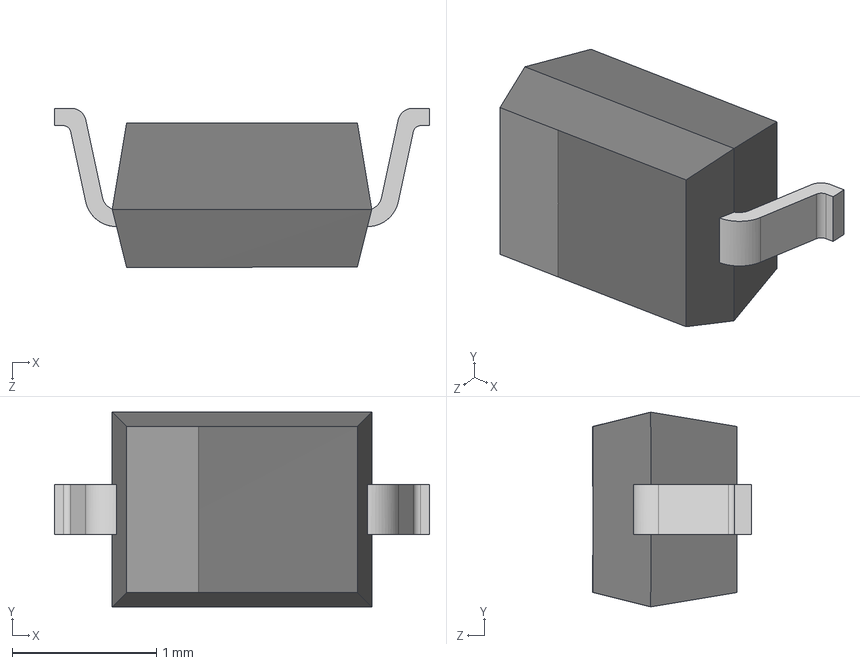
[picture p118: CAD file, 2023-04-09]
LEA_3D_Models/SOD-323.step
2.60 x 1.35 x 1.10 mm
