upb-lea/LEA_KiCad_Library/LEA_3D_Models/ERM5-060-02.0.step

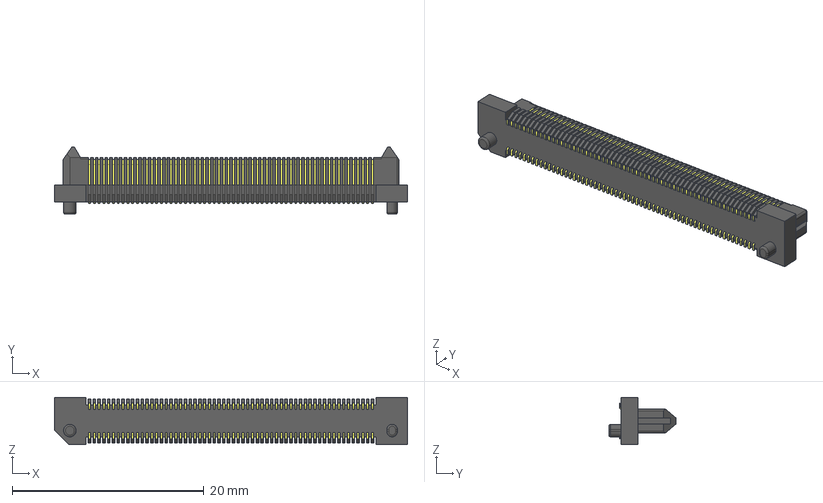
[picture p119: CAD file, 2023-04-09]
LEA_3D_Models/ERM5-060-02.0.step
36.8 x 7.04 x 4.95 mm
