upb-lea/LEA_KiCad_Library/LEA_3D_Models/SOT762-1.step

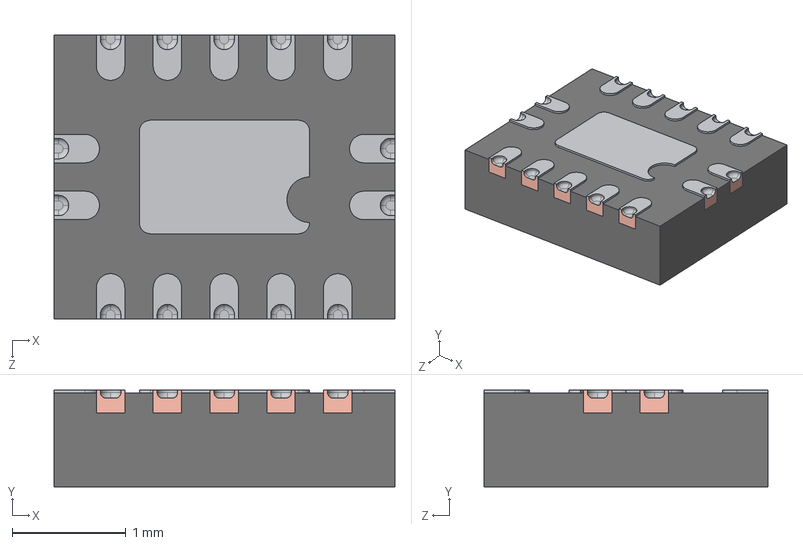
[picture p120: CAD file, 2023-04-09]
LEA_3D_Models/SOT762-1.step
3.00 x 0.85 x 2.50 mm
SOT762 Body
SOT762 Heatsink
SOT762 Lead x 14
