upb-lea/LEA_KiCad_Library/LEA_3D_Models/SOT-89-5.stp

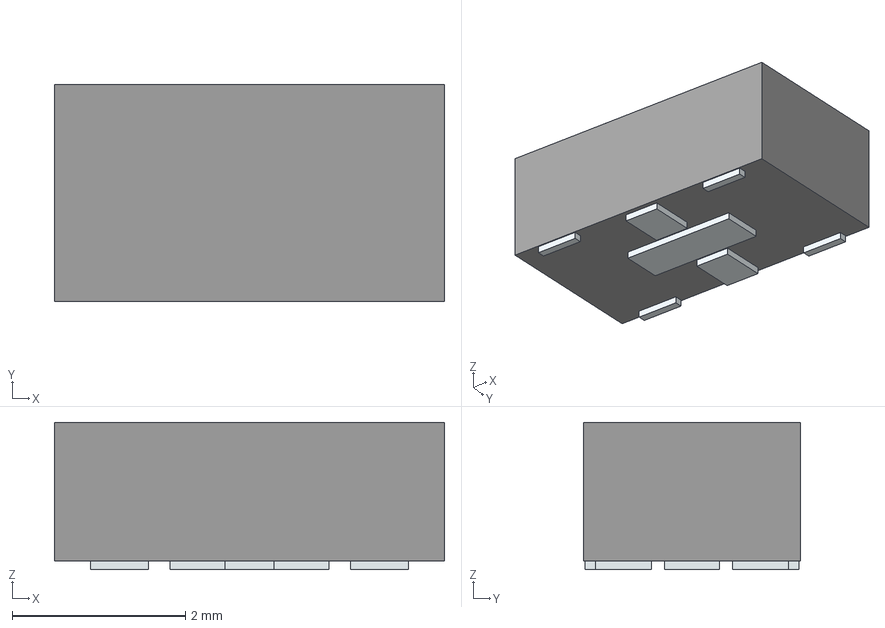
[picture p121: CAD file, 2023-04-09]
LEA_3D_Models/SOT-89-5.stp
4.50 x 2.50 x 1.70 mm
Pins
