upb-lea/LEA_KiCad_Library/LEA_3D_Models/R_shunt_Coax.step

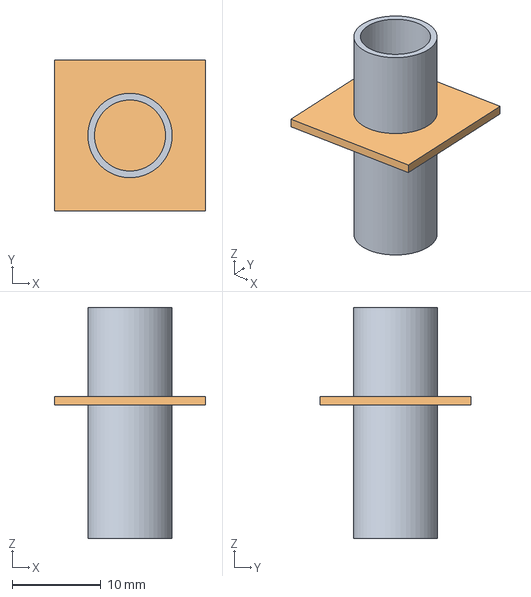
[picture p122: CAD file, 2023-04-09]
LEA_3D_Models/R_shunt_Coax.step
17.0 x 17.0 x 26.0 mm
Tube
Würfel
