upb-lea/LEA_KiCad_Library/LEA_3D_Models/SOT-23-5.step

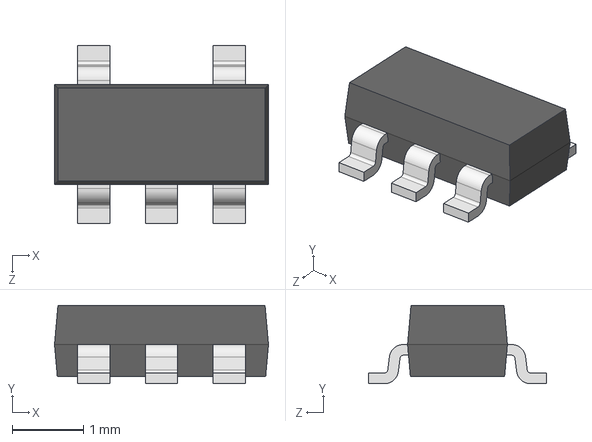
[picture p123: CAD file, 2023-04-09]
LEA_3D_Models/SOT-23-5.step
3.00 x 1.10 x 2.50 mm
