upb-lea/LEA_KiCad_Library/LEA_3D_Models/Molex731000207.stp

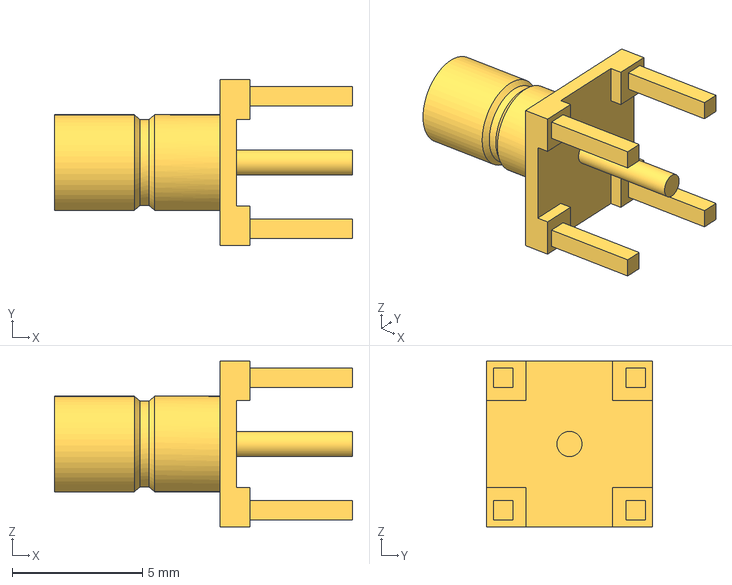
[picture p124: CAD file, 2023-04-09]
LEA_3D_Models/Molex731000207.stp
11.4 x 6.36 x 6.35 mm
