upb-lea/LEA_KiCad_Library/LEA_3D_Models/ERF5-060-05.0.step

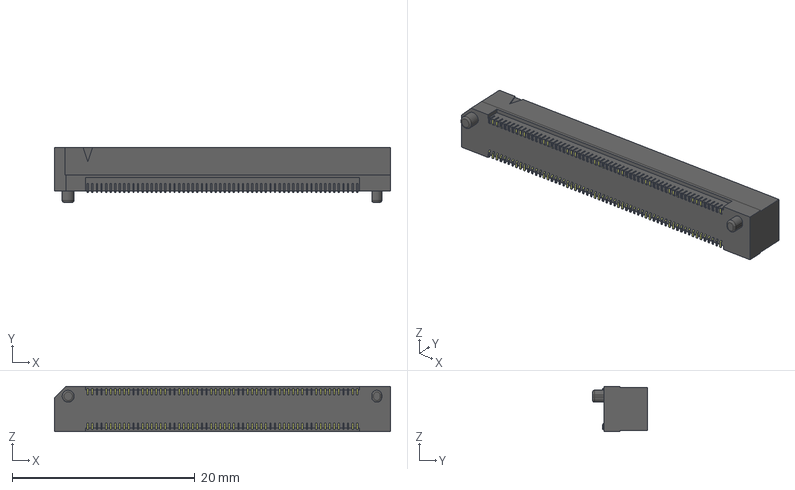
[picture p125: CAD file, 2023-04-09]
LEA_3D_Models/ERF5-060-05.0.step
36.8 x 6.00 x 4.95 mm
