upb-lea/LEA_KiCad_Library/LEA_3D_Models/SW_PUSH.STEP

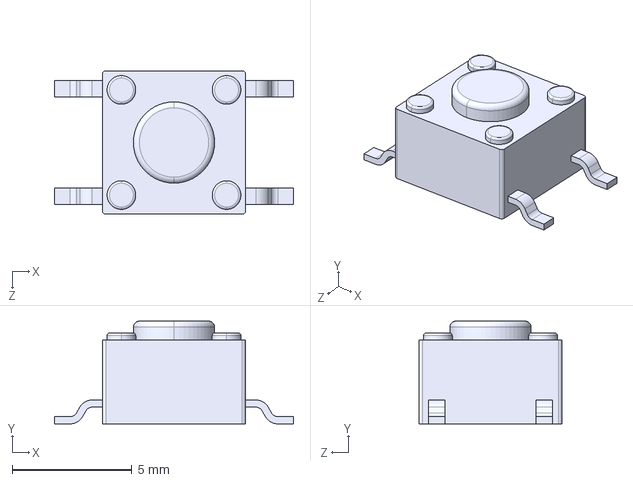
[picture p126: CAD file, 2023-04-09]
LEA_3D_Models/SW_PUSH.STEP
10.0 x 4.30 x 6.00 mm
