upb-lea/LEA_KiCad_Library/LEA_3D_Models/SOIC-16_TI_DWW.stp

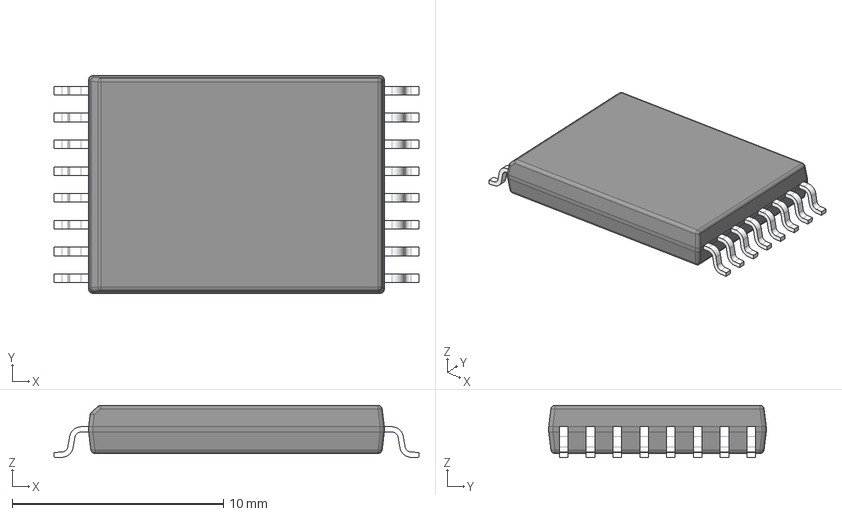
[picture p127: CAD file, 2023-04-09]
LEA_3D_Models/SOIC-16_TI_DWW.stp
17.3 x 10.3 x 2.48 mm
BODY-SO
LEAD-SO x 16
PIN1-ID
