upb-lea/LEA_KiCad_Library/LEA_3D_Models/CLM-107-02-L-D-K-TR.step

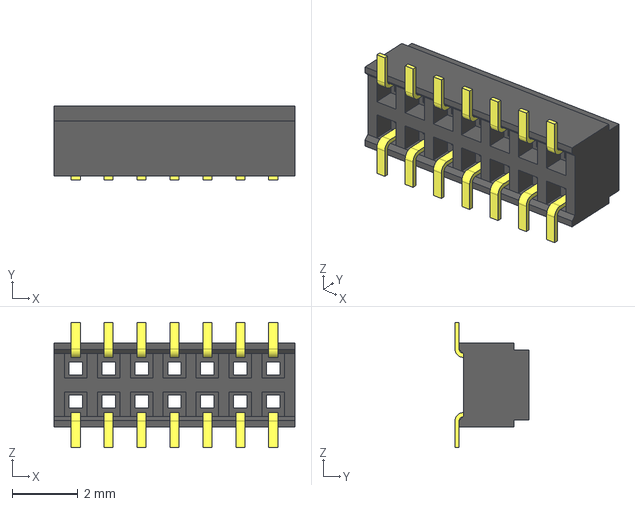
[picture p128: CAD file, 2023-04-09]
LEA_3D_Models/CLM-107-02-L-D-K-TR.step
7.32 x 2.25 x 3.81 mm
_C-07-02_pins
_CLM-107-02-L-D-K-TR_socket
