upb-lea/LEA_KiCad_Library/LEA_3D_Models/Keystone5019.STEP

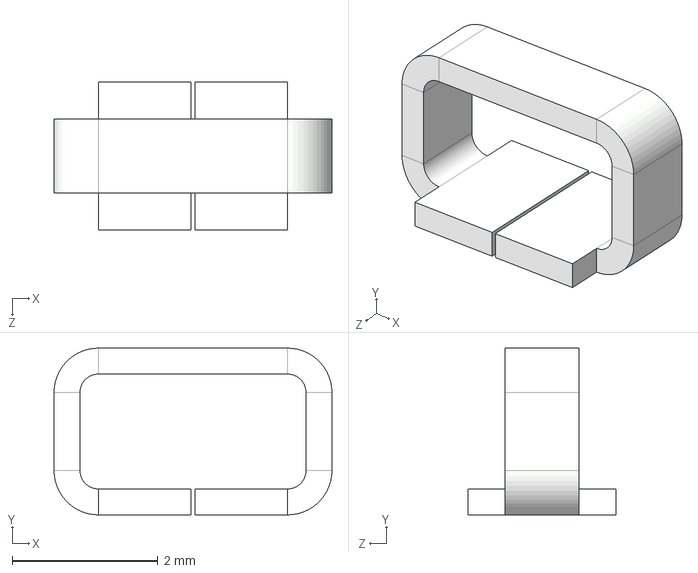
[picture p129: CAD file, 2023-04-09]
LEA_3D_Models/Keystone5019.STEP
3.81 x 2.29 x 2.03 mm
