upb-lea/LEA_KiCad_Library/LEA_3D_Models/Infineon_PB-DSO-8.stp

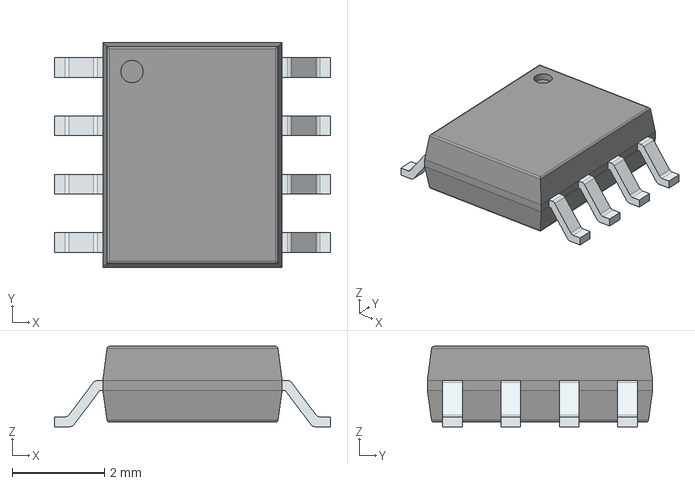
[picture p130: CAD file, 2023-04-09]
LEA_3D_Models/Infineon_PB-DSO-8.stp
6.00 x 4.90 x 1.75 mm
PinsArrayLR
