upb-lea/LEA_KiCad_Library/(list of files, cad)

Other CAD files:
LEA_3D_Models/Conn_Samtec_LS2-105-01-F-D-RA1.stp
LEA_3D_Models/DPBT8105-7.stp
LEA_3D_Models/dcdc_murata_mgj2d_sc_a.step
LEA_3D_Models/09551156612741.stp
LEA_3D_Models/10129381-910002BLF.stp
LEA_3D_Models/1122550000.stp
LEA_3D_Models/1234268.stp
LEA_3D_Models/1731471.stp
LEA_3D_Models/1731484.stp
LEA_3D_Models/1779405341.stp
LEA_3D_Models/1804797.stp
LEA_3D_Models/1844210.stp
LEA_3D_Models/1998933.stp
LEA_3D_Models/29341.stp
LEA_3D_Models/53398-0671.stp
LEA_3D_Models/53398-0871.stp
LEA_3D_Models/744226S.stp
LEA_3D_Models/7461062.stp
LEA_3D_Models/7466204.stp
LEA_3D_Models/B32032A4472M000.stp
LEA_3D_Models/B32774X0505K000.stp
LEA_3D_Models/B65877A0000R095.stp
LEA_3D_Models/B65878E1012D001.stp
LEA_3D_Models/B82801C1265A150.stp
LEA_3D_Models/GS61008T-TR.stp
LEA_3D_Models/ISO1042QDWVRQ1.stp
LEA_3D_Models/ISO7740FQDWQ1.stp
LEA_3D_Models/M20-9770342.stp
LEA_3D_Models/M20-9980846.stp
LEA_3D_Models/M20-9980946.stp
LEA_3D_Models/M20-9990846.stp
LEA_3D_Models/MAX22530AWE+.stp
LEA_3D_Models/TSSOP-14.stp
LEA_3D_Models/UCC21530DWKR.step
LEA_3D_Models/UCC21530DWKR.stp
LEA_3D_Models/UCC28740QDRQ1.stp
