upb-lea/LEA_KiCad_Library/(commit log)

2023-04-11 update some labels and values, as they can be separate values in KiCad7
2023-04-11 update some Rs and Cs names and values, as they can be separate values in KiCad7
2023-04-19 add symbol for second LCB connector when using the LCB_connector_top symbol and footprint
2023-07-04 new schematic symbols and footprints for MA_ANIKET_DAB
2023-07-05 D_SOD_1A0_B140HW-7 and 3d model previous component
    [B140HW-7.stp, BAT54S-7-F.stp, CU8965-ALC.stp]
2023-07-05 D_Z_4V3_PLZ4V3-G3/H and D_Z_16V_PL16C-G3/H
    [PLZ6V2C-G3_H.stp]
2023-07-06 Update diode keys according to name scheme
2023-07-06 Controller_UCC28740QDRQ1 and footprint update
    [UCC28740QDRQ1.stp]
2023-07-12 rename resistor names from _1P to __1P
2023-07-12 INA181A2IDBVR, INA181A1IDBVR current sense amplifiers
    [INA181A1IDBVR.stp]
2023-07-14 Conn_DAB_Transformer and 3D model fix
    [7466204.stp, TS4448_RGG.stp]
2023-07-21 Grid changes to symbol and footprint wiht mechanical area update
2023-07-29 D_DFN_5A0_SE20ND and TO-263-7_TabPin8_Heatsink footprint
    [DFN3820A_20220714.step, VS-5EAH02-M3_H.stp]
2023-07-29 TO-263-7_TabPin8_Heatsink footprint
2023-07-30 Ground symbol changes
2023-07-31 TO-263-7_TabPin8_Heatsink copperblock addition
    [Copper_block.step]
2023-08-06 D_TVS_2A0_P6SMB160A-Q and git comments fix
    [B65877A0000R095.stp, B65878E1012D001.stp, P6SMB160A-Q.stp]
2023-08-07 C_0805_4n7_X7R_10P__250V and ISO_AMC22C11QDRQ1
    [AMC22C11QDRQ1.stp]
2023-08-07 add symbol for LEA control board
2023-08-08 update footprint with copper tablet to have copper inside drill and different pads on top and bot side
2023-08-09 exclude jumper from BOM
2023-08-09 rm hidden power pins in and make them to solid pins
2023-08-10 C__Film__4n7_PP__20P_1000V, C__Film__15n_PP__20P_300V
    [B32032A4472M000.stp]
2023-08-10 fix double power symbols of LCB
2023-08-11 Conn_Fan, Accessory_Conn_Fan
    [1731471.stp]
2023-08-13 connectors name update
2023-08-13 AND OR gates ic
    [SN74AUP1T32DCKR.stp, SN74LVC2G32DCUR.stp]
2023-11-19 DCDC_24V_5V0_VXO7805-1000 and C_Electrolytic_680u_Radial_20P_35V
    [EEU-FC1V681B.stp, VXO7805-1000.stp]
2023-11-22 T_NPN_DNBT8105-7 and T_PNP_DPBT8105-7
    [DNBT8105-7.stp, DPBT8105-7.stp]
2024-02-01 fix overlapping solder mask on multiple potentials for DPT connector
2024-02-01 add detailed information for bom creation
2024-03-01 added few components: LEDs,connectors
    [10129381-910002BLF.stp, M20-9980946.stp, TSW-102-07-G-T.stp]
2024-03-06 updated 0603 LEDs-symbol,footprint,3D model
    [LED_Blue_0603.stp, LED_Red_0603.stp]
2024-03-21 updated 0402 LEDs-symbol,footprint,3D model
    [LED_Blue_0402.stp, LED_Red_0402.stp, LED_Yellow_0402.stp]
2024-04-05 pin input description -> power supply
2024-04-05 OP_4_MCP6004 power symbol change
2024-05-08 added few compenents
    [09.03290.01.stp, 53398-0871.stp, ISO7740FQDWQ1.stp]
2024-07-03 added LTC7800 Footprint and 3D-model
    [LTC7800HUDC#PBF.stp]
2024-07-04 LCB connector symbol updated with free pins for NetClasses
2024-07-09 updated the Symbol and the Footprint of the LTC7800
2024-07-10 Added Footprint and Symbol of GS61800T
    [GS61008T-TR.stp]
2024-07-10 updated the symbol and the footprint of the GS61008T
2024-07-11 LCB connectors' spacer+screw
    [29341.stp, MTS-10S.stp]
2024-07-12 changes to LCB_Spacer+Screw
2024-07-15 added SD101AW Shottky Diode
2024-07-16 Updated Footprint and Symbol
    [SD101AW-HE3_A-08.stp]
2024-07-16 fix pin and grid issues
2024-07-16 add symbol description for connector pins
2024-07-16 Updated Footprint and Symbol - Switched Pins and added thick line in Footprint
2024-07-17 add missing driver footprint
2024-07-17 update - Gate driver, SiC MOSFET
    [UCC21530DWKR.step]
2024-07-17 Conn_Header_3.5mm_8A_160V - pin type change
2024-07-17 fix no-bom for mounting holes
2024-07-17 fix material number keys
2024-07-19 changed Symbol Diode SD101AW
    [UCC21530DWKR.step]
2024-07-21 Added Connector 24920000000
    [Conn_2492000000.stp]
2024-07-21 added Connector 1548376
    [Conn_1548376.stp]
2024-07-21 changed Symbol Connector 1548376
2024-07-22 added 1.8 mOhm Shunt 5W
    [CSI2H-2512K-1L80G.stp]
2024-07-29 Added new M4 Connector 50A
    [Conn_M4_74650074R.stp]
2024-07-29 updated the connector
2024-08-12 Updated Footprint
2024-08-16 updated the Footprint of the LTC7800
2024-10-17 potentiometer through hole dia change
2024-10-17 Isolated 3.3V to 3.3V power supply
    [NTE0303MC.stp]
2024-10-23 corrections to DCDC_3V3_3V3_NTE0303MC symbol and footprint
2024-12-11 fix sub-d connector footprint
2024-12-20 3D-model for SOIC-8 package
    [PI6C49CB04AQ3WEX.stp]
2025-01-06 added right angle push switch
    [B3U-3000PM-B.stp]
2025-01-09 update: LCB Error detection Comparator and D-Flip Flop ICs
    [SO-14.stp, SOT-23-8.stp]
2025-01-10 update: LCB Error dectection - D flipflop and 0603 600 Ohm ferrite beads
2025-01-17 update: analog comparator, flip-flop, OR gate
    [TSSOP-14.stp, VSSOP-8-TI.stp]
2025-02-03 External debugguer connector + analoge switches
    [FTR-110-03-G-D-06-TR.stp, MSOP10_AnalogDevices.stp]
2025-02-09 PR changes, DAB:diode datasheet change + transformer aux winding dot, LCB footprint M3 hole keepout + OR gate output pin
2025-02-19 added: 0603 Yellow LED
    [LED_Yellow_0603.stp]
2025-02-21 LCB sch. AND gate pin update
2025-02-25 connectors for DAB, Transformer footprint update, M3 hole dia increment
    [1234268.stp, 1731484.stp, 1804797.stp]
2025-03-19 add hint for kicad 9 schematic view
2025-04-01 fix connector npth
2025-05-20 fix gan transistor footprint linking
2025-05-20 Added GaN driver LMG1210 and current sense amplifier INA310x
2025-05-22 Added schottky diode
2025-05-22 added capacitors, edited gate driver LMG1210 and current sense amp INA310x
2025-05-26 edited footprint WQFN
2025-05-27 fox footprints
2025-05-27 added inductor 3D model
    [L_Wurth_WE-TPC-1038.step]
2025-06-02 added new inductor
    [SRN4026-220M.stp]
2025-06-03 edited inductor footprint
2025-07-23 added new component zener_diode_SMAF4735A-TP and footprint
2025-07-23 updated zener diode symbol
2025-07-23 update zener diode footprint
2025-07-23 added gate driver MP1923GS-P symbol
2025-07-24 updated current sense amplifier symbol INA310
2025-07-24 updated changes on Current sense amplifier
2025-07-24 updated current sense amplifier symbol
2025-09-02 update fiducial medium with free pin
2025-09-02 add new gnd symbols
2025-09-03 updated sms3924 diode symbol
2025-09-03 Update diode sms3924 to sms3922
2025-09-04 added TVS diode P6SMB62A-Q
2025-09-04 update footprint filters, add gnd_b1 and gnd_b2
2025-09-05 Update symbol name for tvs diode
2025-09-11 add 820k 1206 resistor
2025-09-11 add 220k 1206 resistor
2025-09-12 added switching regulator TPSM5601R5 symbol and footprint
2025-09-12 Updated changes to buck IC TPSM5601R5, added 3D model
    [RDA0015A_QFN15.stp]
2025-09-12 Updated buck IC TPSM5601R5 symbol
2025-09-12 edited footprint QFN-15 for Buck IC TPSM5601R5
2025-09-15 Updated TPSM5601R5 footprint
2025-09-15 added M2 mounting hole symbol and footprint
2025-09-15 added symbol for C_0603 100nF 100V capacitor
2025-09-15 Update symbol for capacitor C_0603_100n_X8L_10P_100V
2025-09-15 added a capacitor symbol C_1206_4u7_X7R_10P_100V
2025-09-15 fix ic input/output pin functionality
2025-09-16 updated TVS diode P6SMB62A symbol
2025-09-16 updated symbol for capacitor C_0603_100n_100V
2025-09-16 added reference symbol, footprint and 3dmodel for C_1210
    [C_1210_3225Metric.step]
2025-09-16 added capacitor C_1210_10u_X7R_10P_100V symbol
2025-09-16 Updated capacitor symbol
2025-09-18 added a new connector molex_10085021
    [Conn_Molex_10085021.stp]
2025-09-23 add spacer m3 3mm
2025-10-09 add film capacitor symbol
2025-12-22 Add new components Temperature Sensor, Connector & Shunt regulator and 3D Model
2025-12-26 3d model updated
    [1122550000.stp]
2025-12-29 Footprint update
2026-01-22 Zener Diode
    [BZY55B6V2.STEP]
2026-01-26 Regarding Diode Footprint and 3d model
    [D_0805_2012Metric.step]
2026-01-26 Footprint & 3D model fix
    [BZY55B6V2.STEP]
2026-06-24 GaN Switch IGC033S10S1 adding
    [IGC033S10S1XTMA1.stp]
2026-07-29 Integrated the Infineon GaN switch into the existing library
2026-08-08 Renaming Done to Add IGC033S10S1 CoolGaN switch symbol to LEA Symbol Library
2026-08-18 added 1812_4532metric capacitor symbol, footprint and 3D model
    [C_1812_4532Metric.step]
2026-08-20 added symbol and footprint and 3d models for GaN based half_bridge
    [2MM-HB-D08-HT-02-H-TB.stp, 7461062.stp, ESQT-108-03-F-D-350.stp, HalfBridge.step]
2026-08-21 updated naming for Half bridge connector
2026-08-24 update half bridge connector symbol aux input voltage pin +12V to +24V
2026-08-25 added C_1812_2000V_2n2 and C_1812_2000V_1n capacitors
2026-08-27 update capacitor symbol name to C_1812__2n2_X7R_10P_2000V
2026-08-30 added symbol and footprint and 3d model for VS-E5TH2112S2L-M3 rectifier diode
    [TO-263AB(D2PAK)-2L.STEP]
2026-08-31 updated rectifier diode symbol name
2026-09-01 added capacitor to the symbol library C_1210_1n0_COG_5P_1500V
2026-09-03 added SiC diode D_TO-263-2L_10A_SCS210KNHR
    [TO-263-2.step]
2026-09-03 added capacitor symbol footprint and 3D model C_2225__100n_X7R_10P__1500V
    [C_2225_5664Metric.step]
2026-09-07 add isolated converter 1779405341 symbol, footprint, 3d model
    [1779405341.stp]
2026-09-07 add capacitor C_1812__470p_X7R_10P__3000V
2026-09-07 add common mode choke L_SL2_2x10u_30P_1.6A symbol, footprint, 3D model
    [744226S.stp]
2026-09-08 add isolation amplifier voltage sensor AMC1311DWVR
2026-09-08 add current sense isolation amplifier AMC1301QDWVQ1
2026-09-08 add shunt resistor R_shunt_CSSH2728FT10L0
    [R_2728_reversed.stp]
2026-09-08 add power inductor L_SMD__6u8_20P_20A
    [HCMA1707-6R8-R.stp]
2026-09-08 update isolated current amplifier symbol AMC1301QDWVQ1
2026-09-09 add current sense resistor R_shunt_CSSH2728FT25L0
2026-09-11 add resistor symbol R_1206__1M5_THICK__1P_500V
2026-09-11 add connector symbol, footprint, 3D model Conn_02x05_Odd_Even
    [Conn_WE_61301021821.stp]
2026-09-11 update connector footprint Conn_WE_61301021821
2026-09-14 add three connectors Symbols, footprint, 3d model Conn_Samtec_LS2-105-01-F-D, Conn_Samtec_LS2-105-01-F-D-RA2, Conn_Samtec_LS2-105-01-F-D-RA1
    [Conn_SAMTEC-LS2-105-01-X-D.step, Conn_Samtec_LS2-105-01-F-D-RA1.stp, Conn_Samtec_LS2-105-01-F-D-RA2.stp]
2026-09-14 update footprint Conn_Samtec_LS210501FDRA2
2026-09-15 add mosfet T_SOT_2A_SSM3K2615TU
    [SOT-323F_UFM.stp]
2026-09-15 add film capacitor C_Film__2u0_PP__5P_1000V
    [C_Film_ECW-FJ3A205J.stp]
2026-09-15 add inductor L_SMD_10u_20P_5A, symbol, footprint,3d model
    [WE_744393305100.stp]
2026-09-15 add switching voltage regulator symbol Controller_LMR51635
2026-09-16 update film capacitor symbol
2026-10-12 add heatsink and fan to half bridge connector 3D model
2026-10-12 update half bridge connector symbol
2026-10-13 add LDO symbol, footprint and 3D model
2026-10-16 add power inductor symbol, footprint and 3D model
2026-10-21 add schottky diode symbol D_TO263-2_10A_IDK10G120C5
2026-10-23 add current sense amplifier symbol CS-Amp_TI_TMCS1133B4A
2026-10-27 add 16 pin connector symbol, footprint and 3D model
2026-11-02 add 1998933 1000V PCB header
2026-11-03 add 1000V PCB header 1998784
2026-11-03 update PCB header symbol
2026-11-10 update Half bridge connector footprint
2026-11-10 update SiC Diode footprint
2026-11-11 update footprint TO-263-2_SiC_Diode to TO-263-2_increased_distance
