upb-lea/LEA_KiCad_Library/(notices)

Notices in the files:
LEA_3D_Models/SOIC-14_3.9x8.7mm_P1.27mm.step:
Copyright (C) 2017, kicad StepUp
This work is licensed under the [Creative Commons CC-BY-SA 4.0 License](https://creativecommons.org/licenses/by-sa/4.0/legalcode),
with the following exception:
To the extent that the creation of electronic designs that use 'Licensed Material' can be considered to be 'Adapted Material',
You are free to use the library data in your own projects without the obligation to share your project files under this or any other license agreement.
LEA_3D_Models/R_0603_1608Metric.step:
Copyright (C) 2018, kicad StepUp
LEA_3D_Models/D_0805_2012Metric.step:
This program is free software: you can redistribute it and/or modify
it under the terms of the GNU General Public License as published by
the Free Software Foundation, either version 3 of the License, or
any later version.
itself might be covered by the GNU General Public License.
LEA_3D_Models/TO-263-2.step:
Copyright (C) 2023, Ray Benitez
This work is licensed under the
[Creative Commons CC-BY-SA 4.0 License](https://creativecommons.org/licenses/by-sa/4.0/legalcode),
project files under this or any other license agreement. However, if you wish to distribute
LEA_3D_Models/L_Wurth_WE-TPC-1038.step:
The information within the data (“Information”) has been provided to you free of charge for your use according to the terms of the
Creative Commons Attribution-ShareAlike 4.0 International Public License and remains the sole property of Würth Elektronik eiSos GmbH & Co. KG.
You are obliged to use the Information in accordance with the Creative Commons Attribution-ShareAlike 4.0 International Public License.
The following exception to the Creative Commons Attribution-ShareAlike 4.0 International Public License applies to your use of the Information:
To the extent that the creation of electronic designs that use 'Licensed Material' can be considered to be 'Adapted Material', then the copyright holder waives article 3 of
the license with respect to these designs and any generated files which use data provided as part of the 'Licensed Material'. You are free to use the library data in your
own projects without the obligation to share your project files under this or any other license agreement. However, if you wish to redistribute these libraries, or parts
LEA_3D_Models/USB4110.stp:
FILE_NAME( 'p:/temp/worker_26/temp/exporttempdir_1720_901_JYsxl/format_0/USB4110-GF-A.stp', '2022-01-23T23:29:36', ( 'License CC BY-ND 4.0' ), ( 'CADENAS' ), ' ', 'PARTsolutions', ' ' );
LEA_3D_Models/FTR-110-03-G-D-06-TR.stp:
author */ ('License CC BY-ND 4.0'),
